UofSC-ASME/USC-ASME-TigerBurn-2026/README.md

# USC-ASME-TigerBurn-2026
Concepts and CAD files for Tiger Burn 2026.
