UofSC-ASME/USC-ASME-TigerBurn-2026/UofSC-ASME-Tiger-Burn-Design-2025-main/UofSC-ASME-Tiger-Burn-Design-2025-main/README.md

# UofSC-ASME-Tiger-Burn-Design-2025
Concepts and CAD files for Tiger Burn 2025.

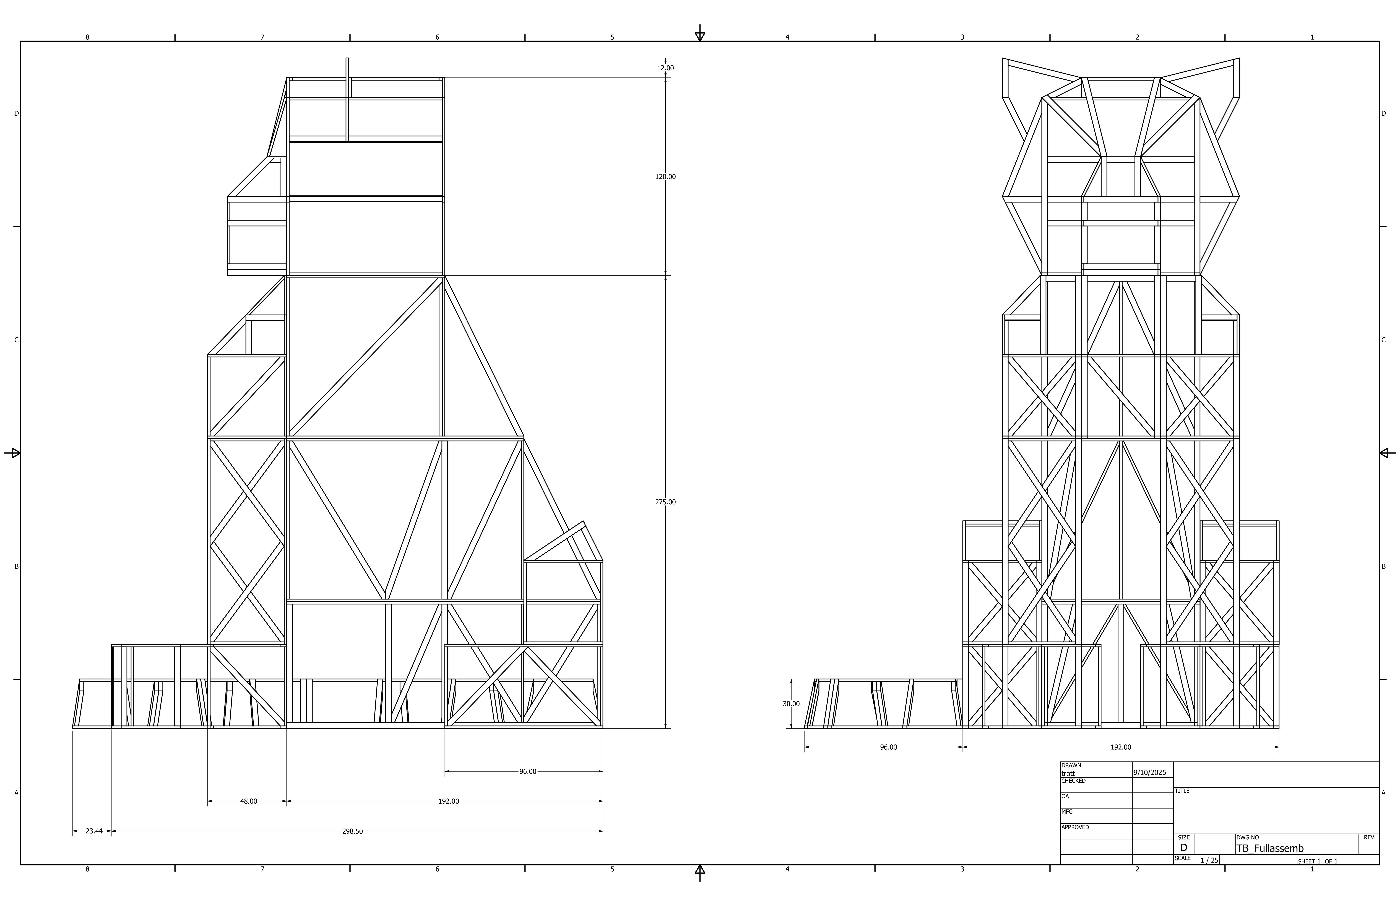
[picture p1: UofSC-ASME-Tiger-Burn-Design-2025-main/UofSC-ASME-Tiger-Burn-Design-2025-main/Documents/Drawings/TB_Fullassemb.png]

**Figure 1:** Drawing of the full assembly

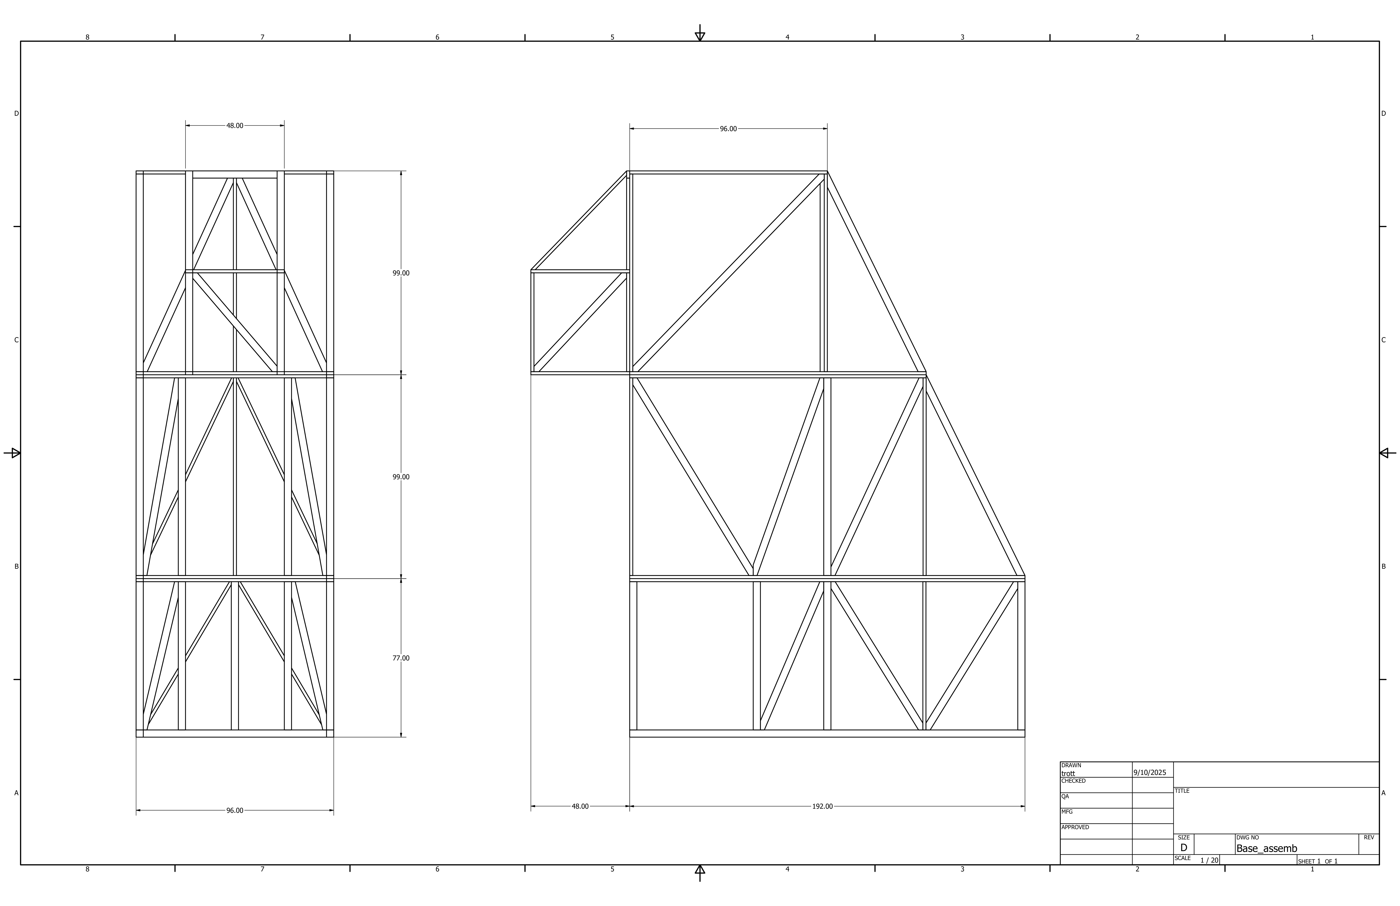
[picture p2: UofSC-ASME-Tiger-Burn-Design-2025-main/UofSC-ASME-Tiger-Burn-Design-2025-main/Documents/Drawings/Base_assemb.png]

**Figure 2:** Drawing of the base assembly.
