UofSC-ASME/USC-ASME-TigerBurn-2026/head files/Screenshot 2026-06-01 195907.png

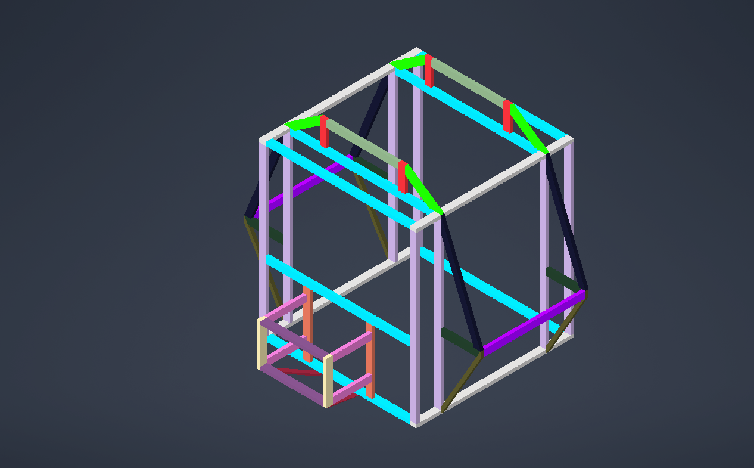
head files/Screenshot 2026-06-01 195907.png
