UofSC-ASME/USC-ASME-TigerBurn-2026/head files/Screenshot 2026-08-07 163357.png

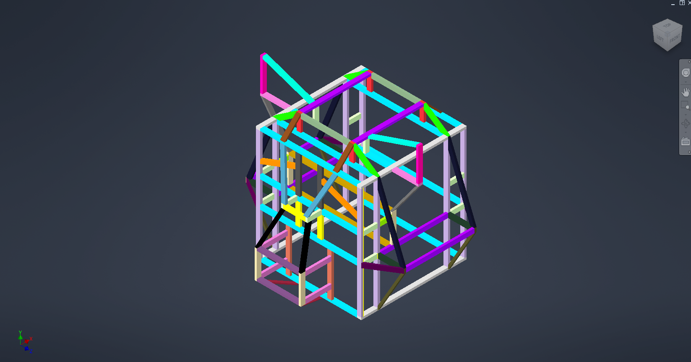
head files/Screenshot 2026-08-07 163357.png
