UofSC-ASME/USC-ASME-TigerBurn-2026/UofSC-ASME-Tiger-Burn-Design-2025-main/UofSC-ASME-Tiger-Burn-Design-2025-main/CAD/Reference (TB24)/FullAssembly/FullAssembly.stl

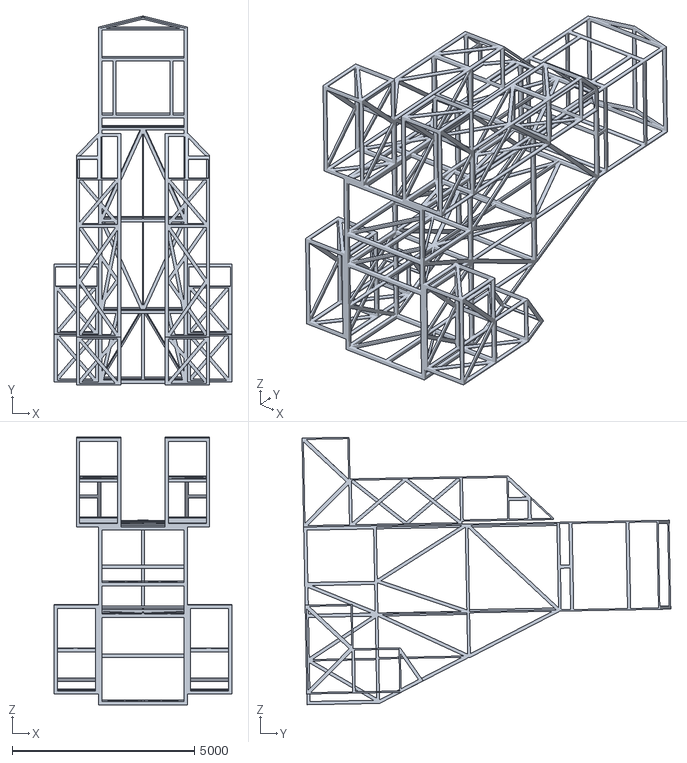
[picture p5: CAD file, 2026-04-23]
UofSC-ASME-Tiger-Burn-Design-2025-main/UofSC-ASME-Tiger-Burn-Design-2025-main/CAD/Reference (TB24)/FullAssembly/FullAssembly.stl
4876.8 x 10121.6 x 7337.9
