UofSC-ASME/USC-ASME-TigerBurn-2026/(list of files, cad)

Other CAD files:
UofSC-ASME-Tiger-Burn-Design-2025-main/UofSC-ASME-Tiger-Burn-Design-2025-main/CAD/Assembly/TB_Fullassemb.dwg
UofSC-ASME-Tiger-Burn-Design-2025-main/UofSC-ASME-Tiger-Burn-Design-2025-main/CAD/Assembly/Base_assemb.dwg
UofSC-ASME-Tiger-Burn-Design-2025-main/UofSC-ASME-Tiger-Burn-Design-2025-main/CAD/Assembly/OldVersions/TB_Fullassemb.0001.dwg
UofSC-ASME-Tiger-Burn-Design-2025-main/UofSC-ASME-Tiger-Burn-Design-2025-main/CAD/Assembly/OldVersions/Base_assemb.0001.dwg
Build Instructions/B_Foot_v2 - Copy (1).iam
Build Instructions/BoardCutsTigerBurnHead2026.iam
CAD/Assembly/OldVersions/TB_Fullassemb.0022.iam
CAD/Assembly/TB_Fullassemb-1.idw
CAD/Assembly/TB_Fullassemb.iam
CAD/Head/Tiger_HeadFrame/Frame/OldVersions/Frame 1756844320201.0004.iam
CAD/Head/Tiger_HeadFrame/Frame/OldVersions/Skeleton 1756844320202.0001.ipt
CAD/Legs/Back Foot/2x4x120.ipt
CAD/Legs/Back Foot/2x4x30.ipt
CAD/Legs/Back Foot/2x4x60.ipt
CAD/Legs/Back Foot/B_Foot.iam
CAD/Legs/Back Foot/B_Foot_v2 - Copy.iam
CAD/Legs/Back Foot/OldVersions/2x4x30.0001.ipt
CAD/Legs/Back Foot/OldVersions/2x4x42.0005.ipt
CAD/Legs/Back Foot/OldVersions/2x4x60.0002.ipt
CAD/Legs/Back Foot/OldVersions/2x4xrr.0001.ipt
CAD/Legs/Back Foot/OldVersions/B_Foot_v2.0010.iam
CAD/Legs/Back Foot/OldVersions/S_2x4x44.12.0003.ipt
CAD/Legs/Back Foot/OldVersions/S_2x4x54.35.0002.ipt
CAD/Legs/Back Foot/S_2x4x54.35.ipt
CAD/Legs/Back Foot/S_2x4x63.13.ipt
CAD/Legs/Back Foot/S_2x4x65.081.ipt
CAD/Legs/Back Foot/S_2x4x65.8.ipt
CAD/Legs/Back Foot/S_2x4x68.525.ipt
CAD/Legs/Front Foot/2x4x12.ipt
CAD/Legs/Front Foot/2x4x20.5.ipt
CAD/Legs/Front Foot/2x4x22.5.ipt
CAD/Legs/Front Foot/2x4x30.ipt
CAD/Legs/Front Foot/2x4x42.ipt
CAD/Legs/Front Foot/2x4x8.ipt
CAD/Legs/Front Foot/2x4x96.ipt
CAD/Legs/Front Foot/F_Foot.iam
CAD/Legs/Front Foot/F_Foot_v2.iam
CAD/Legs/Front Foot/Ffoot2.iam
CAD/Legs/Front Foot/OldVersions/2x4x12.0008.ipt
CAD/Legs/Front Foot/OldVersions/2x4x20.5.0002.ipt
CAD/Legs/Front Foot/OldVersions/2x4x22.5.0001.ipt
CAD/Legs/Front Foot/OldVersions/2x4x8.0005.ipt
CAD/Legs/Front Foot/OldVersions/F_Foot.0013.iam
CAD/Legs/Front Foot/OldVersions/F_Foot.0015.iam
CAD/Legs/Front Foot/OldVersions/F_Foot_v2.0007.iam
CAD/Legs/Front Foot/OldVersions/S_2x4x11.24.0002.ipt
CAD/Legs/Front Foot/OldVersions/S_2x4x13.48.0002.ipt
CAD/Legs/Front Foot/OldVersions/S_2x4x14.71 - Copy.0001.ipt
CAD/Legs/Front Foot/OldVersions/S_2x4x30.5.0001.ipt
CAD/Legs/Front Foot/S_2x4x11.24.ipt
CAD/Legs/Front Foot/S_2x4x13.48.ipt
CAD/Legs/Front Foot/S_2x4x14.71.ipt
CAD/Legs/Front Foot/S_2x4x30.5.ipt
CAD/Legs/Front Foot/S_2x4x54.35.ipt
CAD/Legs/Shoulder/Shoulder_L/Lshoulder cuts.ipt
CAD/Legs/Shoulder/Shoulder_L/OldVersions/Lshoulder cuts.0001.ipt
CAD/Tail/2x4x24.ipt
CAD/Tail/2x4x28.ipt
CAD/Tail/2x4x36.ipt
CAD/Tail/2x4x72.ipt
CAD/Tail/2x4x96.ipt
CAD/Tail/OldVersions/2x4x28.0005.ipt
CAD/Tail/OldVersions/2x4x96.0007.ipt
CAD/Tail/OldVersions/S_2x4x14.42.0001.ipt
CAD/Tail/OldVersions/S_2x4x24.74.0002.ipt
CAD/Tail/OldVersions/S_2x4x27.876.0001.ipt
CAD/Tail/OldVersions/S_2x4x28.635.0001.ipt
CAD/Tail/OldVersions/S_2x4x29.399.0002.ipt
CAD/Tail/OldVersions/S_2x4x31.008.0001.ipt
CAD/Tail/OldVersions/S_2x4x39.27.0003.ipt
CAD/Tail/OldVersions/S_2x4x39.865.0001.ipt
CAD/Tail/OldVersions/S_2x4x42.997.0001.ipt
CAD/Tail/OldVersions/S_2x4x45.283.0001.ipt
CAD/Tail/OldVersions/S_2x4x48.76.0005.ipt
CAD/Tail/OldVersions/S_2x4x50.56.0003.ipt
CAD/Tail/OldVersions/S_2x4x52.551.0002.ipt
CAD/Tail/OldVersions/S_2x4x53.341.0001.ipt
CAD/Tail/OldVersions/S_2x4x55.628.0001.ipt
CAD/Tail/OldVersions/S_2x4x57.206.0001.ipt
CAD/Tail/OldVersions/S_2x4x60.882.0002.ipt
CAD/Tail/OldVersions/S_2x4x64.382.0001.ipt
CAD/Tail/OldVersions/S_2x4x69.709.0001.ipt
CAD/Tail/OldVersions/S_2x4x73.75.0003.ipt
CAD/Tail/OldVersions/S_2x4x74.54.0003.ipt
CAD/Tail/OldVersions/S_2x4x82.0002.ipt
CAD/Tail/OldVersions/S_2x4x84.0002.ipt
CAD/Tail/OldVersions/S_2x4x93.85.0002.ipt
CAD/Tail/OldVersions/Sketch_tail.0003.ipt
CAD/Tail/OldVersions/Struct_tail.0002.iam
CAD/Tail/OldVersions/Tail.0007.iam
CAD/Tail/OldVersions/tail_p1.0005.iam
CAD/Tail/OldVersions/tail_p2.0001.iam
CAD/Tail/OldVersions/tail_p3.0003.iam
CAD/Tail/OldVersions/tail_p4.0004.iam
CAD/Tail/OldVersions/taildiag.0001.ipt
CAD/Tail/S_2x4x14.42.ipt
CAD/Tail/S_2x4x24.74.ipt
CAD/Tail/S_2x4x27.876.ipt
CAD/Tail/S_2x4x28.635.ipt
CAD/Tail/S_2x4x29.334.ipt
CAD/Tail/S_2x4x29.399.ipt
CAD/Tail/S_2x4x31.008.ipt
CAD/Tail/S_2x4x31.38.ipt
CAD/Tail/S_2x4x32.93.ipt
CAD/Tail/S_2x4x39.865.ipt
CAD/Tail/S_2x4x40.427.ipt
CAD/Tail/S_2x4x40.639.ipt
CAD/Tail/S_2x4x41.265.ipt
CAD/Tail/S_2x4x41.489.ipt
CAD/Tail/S_2x4x42.997.ipt
CAD/Tail/S_2x4x43.799.ipt
CAD/Tail/S_2x4x45.283.ipt
CAD/Tail/S_2x4x48.76.ipt
CAD/Tail/S_2x4x50.56.ipt
CAD/Tail/S_2x4x52.551.ipt
CAD/Tail/S_2x4x53.341.ipt
CAD/Tail/S_2x4x55.628.ipt
CAD/Tail/S_2x4x57.206.ipt
CAD/Tail/S_2x4x60.882.ipt
CAD/Tail/S_2x4x64.382.ipt
CAD/Tail/S_2x4x69.709.ipt
CAD/Tail/S_2x4x72.ipt
CAD/Tail/S_2x4x73.75.ipt
CAD/Tail/S_2x4x74.54.ipt
CAD/Tail/S_2x4x80.31.ipt
CAD/Tail/S_2x4x82.ipt
CAD/Tail/S_2x4x84.ipt
CAD/Tail/S_2x4x92.131.ipt
CAD/Tail/S_2x4x93.85.ipt
CAD/Tail/S_2x4x96.546.ipt
CAD/Tail/S_2x4x96.ipt
CAD/Tail/S_2x4x96b.ipt
CAD/Tail/Sketch_tail.ipt
CAD/Tail/Struct_tail.iam
CAD/Tail/Tail.iam
CAD/Tail/tail_p1.iam
CAD/Tail/tail_p2.iam
CAD/Tail/tail_p3.iam
CAD/Tail/tail_p4.iam
CAD/Tail/taildiag.ipt
UofSC-ASME-Tiger-Burn-Design-2025-main/UofSC-ASME-Tiger-Burn-Design-2025-main/CAD/Assembly/Base_assemb.iam
UofSC-ASME-Tiger-Burn-Design-2025-main/UofSC-ASME-Tiger-Burn-Design-2025-main/CAD/Assembly/Body_assemb.iam
UofSC-ASME-Tiger-Burn-Design-2025-main/UofSC-ASME-Tiger-Burn-Design-2025-main/CAD/Assembly/OldVersions/Base_assemb.0001.iam
UofSC-ASME-Tiger-Burn-Design-2025-main/UofSC-ASME-Tiger-Burn-Design-2025-main/CAD/Assembly/OldVersions/Body_assemb.0001.iam
UofSC-ASME-Tiger-Burn-Design-2025-main/UofSC-ASME-Tiger-Burn-Design-2025-main/CAD/Assembly/OldVersions/TB_Fullassemb.0014.iam
UofSC-ASME-Tiger-Burn-Design-2025-main/UofSC-ASME-Tiger-Burn-Design-2025-main/CAD/Assembly/TB_Fullassemb.iam
UofSC-ASME-Tiger-Burn-Design-2025-main/UofSC-ASME-Tiger-Burn-Design-2025-main/CAD/Body/Base 01/2x4x192.ipt
UofSC-ASME-Tiger-Burn-Design-2025-main/UofSC-ASME-Tiger-Burn-Design-2025-main/CAD/Body/Base 01/2x4x72.ipt
UofSC-ASME-Tiger-Burn-Design-2025-main/UofSC-ASME-Tiger-Burn-Design-2025-main/CAD/Body/Base 01/2x4x89.ipt
UofSC-ASME-Tiger-Burn-Design-2025-main/UofSC-ASME-Tiger-Burn-Design-2025-main/CAD/Body/Base 01/4x4x192.ipt
UofSC-ASME-Tiger-Burn-Design-2025-main/UofSC-ASME-Tiger-Burn-Design-2025-main/CAD/Body/Base 01/4x4x72.ipt
UofSC-ASME-Tiger-Burn-Design-2025-main/UofSC-ASME-Tiger-Burn-Design-2025-main/CAD/Body/Base 01/4x4x89.ipt
UofSC-ASME-Tiger-Burn-Design-2025-main/UofSC-ASME-Tiger-Burn-Design-2025-main/CAD/Body/Base 01/Base 01.iam
UofSC-ASME-Tiger-Burn-Design-2025-main/UofSC-ASME-Tiger-Burn-Design-2025-main/CAD/Body/Base 01/OldVersions/2x4x192.0001.ipt
UofSC-ASME-Tiger-Burn-Design-2025-main/UofSC-ASME-Tiger-Burn-Design-2025-main/CAD/Body/Base 01/OldVersions/2x4x72.0001.ipt
UofSC-ASME-Tiger-Burn-Design-2025-main/UofSC-ASME-Tiger-Burn-Design-2025-main/CAD/Body/Base 01/OldVersions/2x4x89.0001.ipt
UofSC-ASME-Tiger-Burn-Design-2025-main/UofSC-ASME-Tiger-Burn-Design-2025-main/CAD/Body/Base 01/OldVersions/4x4x192.0001.ipt
UofSC-ASME-Tiger-Burn-Design-2025-main/UofSC-ASME-Tiger-Burn-Design-2025-main/CAD/Body/Base 01/OldVersions/4x4x72.0001.ipt
UofSC-ASME-Tiger-Burn-Design-2025-main/UofSC-ASME-Tiger-Burn-Design-2025-main/CAD/Body/Base 01/OldVersions/4x4x89.0001.ipt
UofSC-ASME-Tiger-Burn-Design-2025-main/UofSC-ASME-Tiger-Burn-Design-2025-main/CAD/Body/Base 01/OldVersions/Base 01.0027.iam
UofSC-ASME-Tiger-Burn-Design-2025-main/UofSC-ASME-Tiger-Burn-Design-2025-main/CAD/Body/Base 01/OldVersions/S_2x4x73.980.0003.ipt
UofSC-ASME-Tiger-Burn-Design-2025-main/UofSC-ASME-Tiger-Burn-Design-2025-main/CAD/Body/Base 01/OldVersions/S_2x4x83.735.0004.ipt
UofSC-ASME-Tiger-Burn-Design-2025-main/UofSC-ASME-Tiger-Burn-Design-2025-main/CAD/Body/Base 01/OldVersions/fside1.0002.ipt
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
