UofSC-ASME/USC-ASME-TigerBurn-2026/Build Instructions Instructions.docx

Follow template of previous year’s designs!!

PUT ALL DIMENSIONS IN INCHES ONLY (people are stupid)

Don’t include unnecessary information

Piece quantity – pull from BOM

Piece cuts – pull from cut sheet

Screenshot each step of the process with dimensions

Include all pieces used and dimensions to build

Think about how to best construct the piece in order as you make the steps

I prefer to create a “cut sheet” page at the beginning. This shows people how to cut the boards all at once, and makes next steps a lot easier. Make sure to add a note on the instructions to LABEL YOUR CUTS with the dimension so they don’t get mixed up.
