UofSC-ASME/USC-ASME-TigerBurn-2026/Build Instructions/B Leg.x.pptx

## Back Leg x2

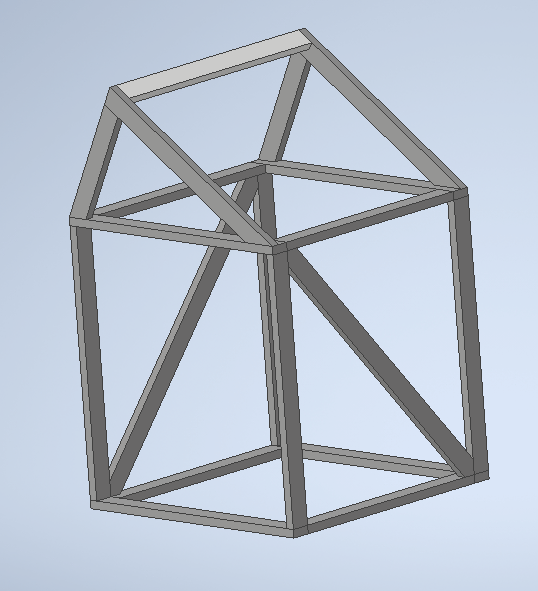
[picture p6: figure]

9.5 2x4x8

## Slide 2

(2) 2x4x8
- (2) 48”
- (2) 41”

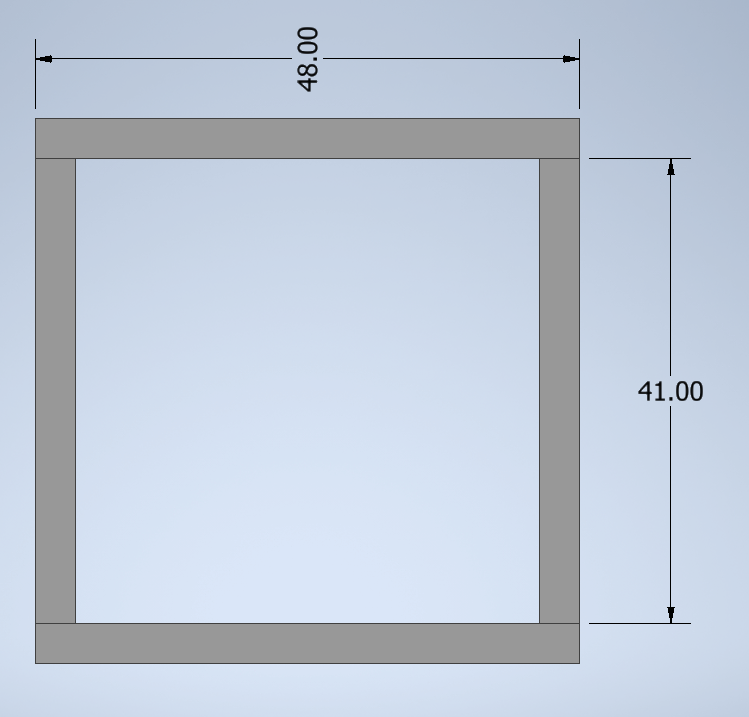
[picture p7: figure]

## Slide 3

(2) 2x4x8
- (4) 48”

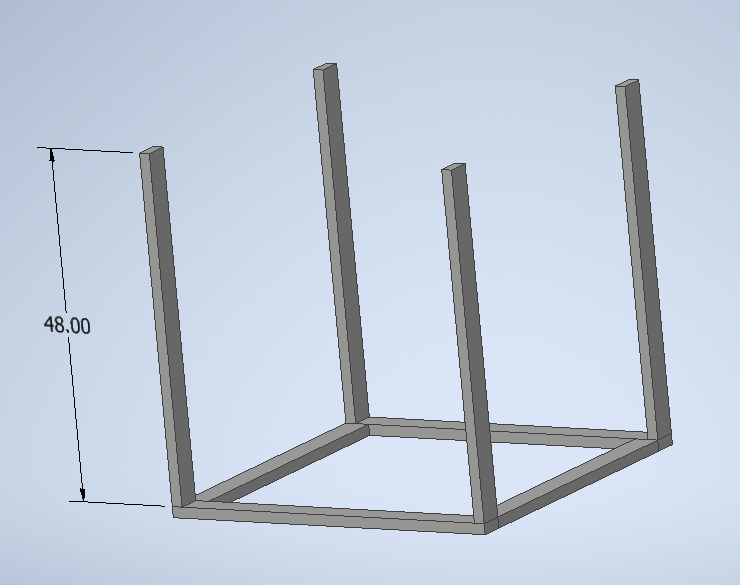
[picture p8: figure]

## Slide 4

(2) 2x4x8
- (2) 48”
- (2) 41”

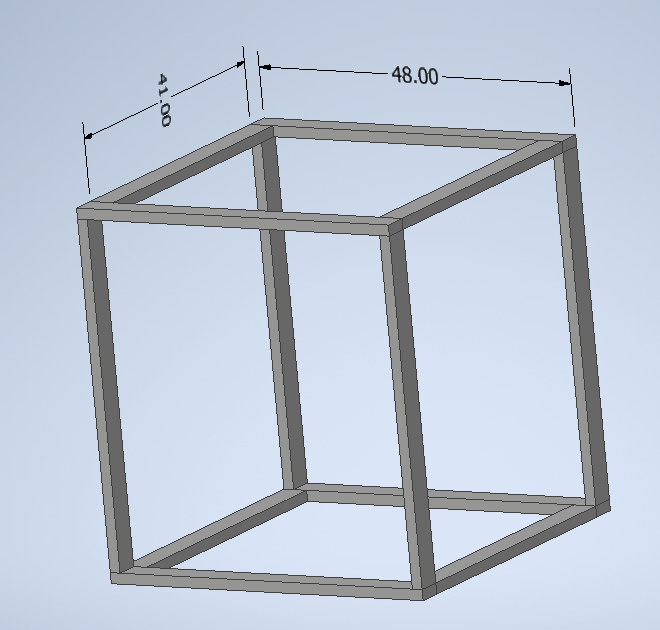
[picture p9: figure]

## Slide 5

(2) 2x4x8
- (2) slants
  - Save excess for top slants

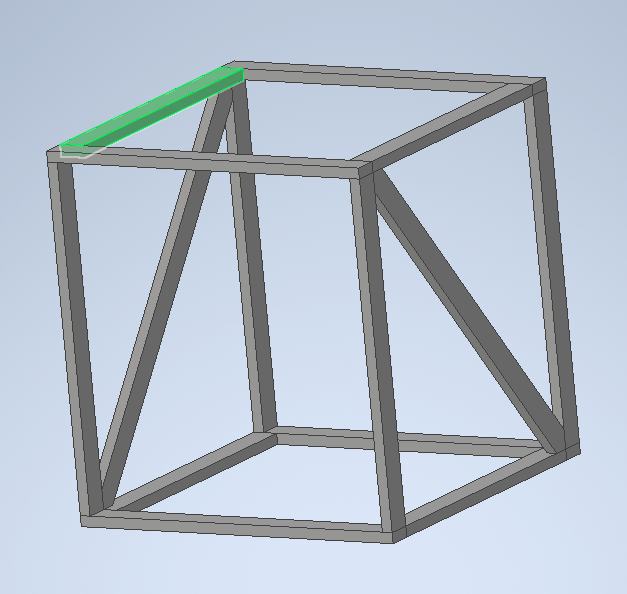
[picture p10: figure]

## Slide 6

(1) 2x4x8
- (2) long slants

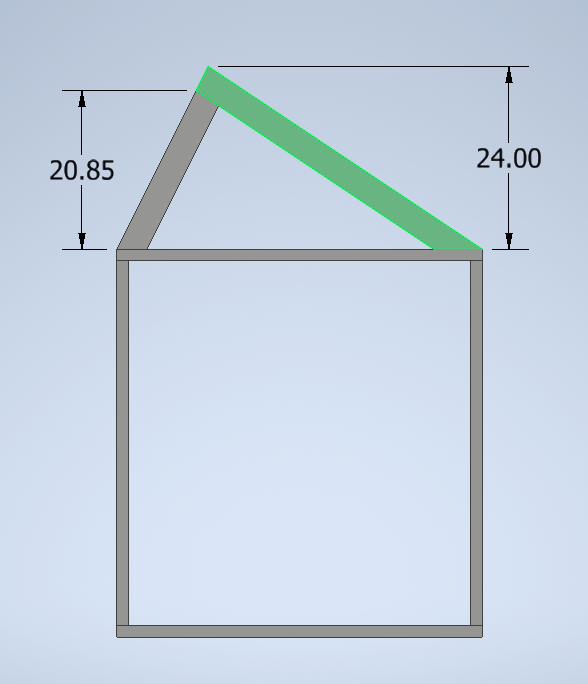
[picture p11: figure]

(2) Leftover from inside slants
- (2) short slants

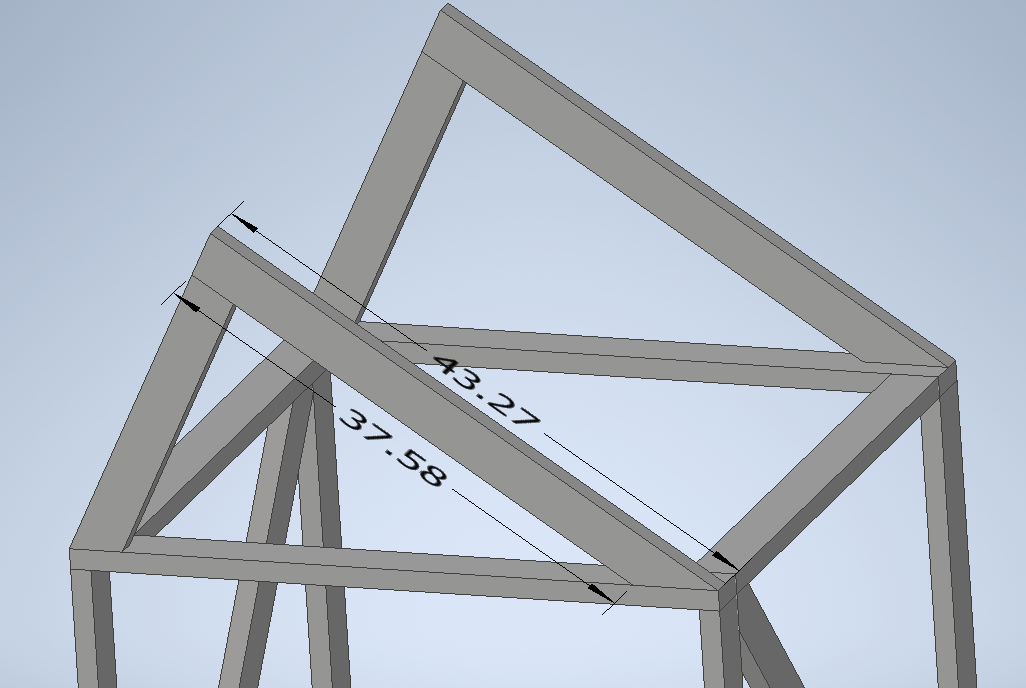
[picture p12: figure]
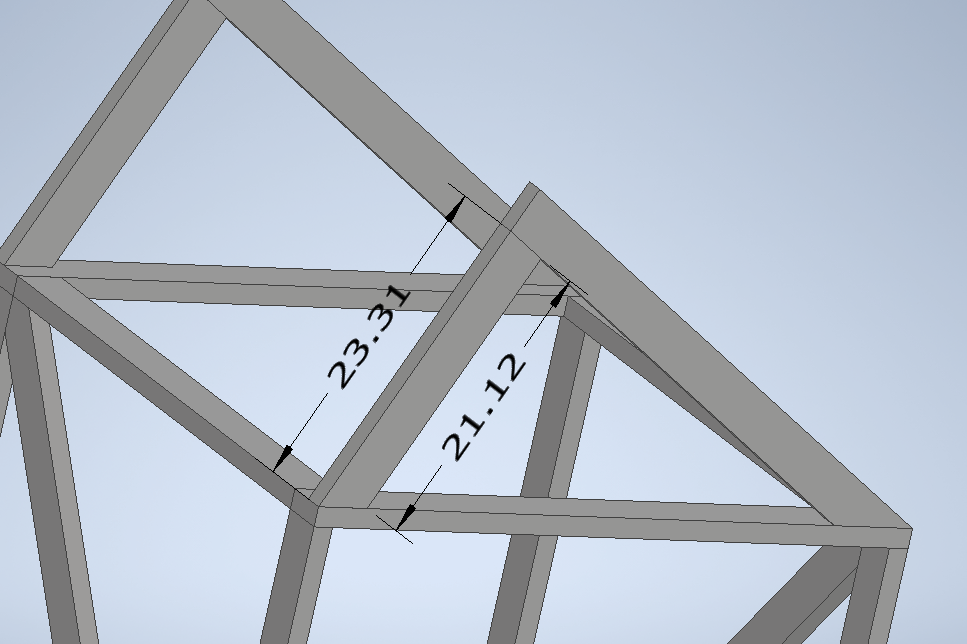
[picture p13: figure]

## Slide 7

(0.5) 2x4x8
- (1) 45”
  - Save other half for second back leg

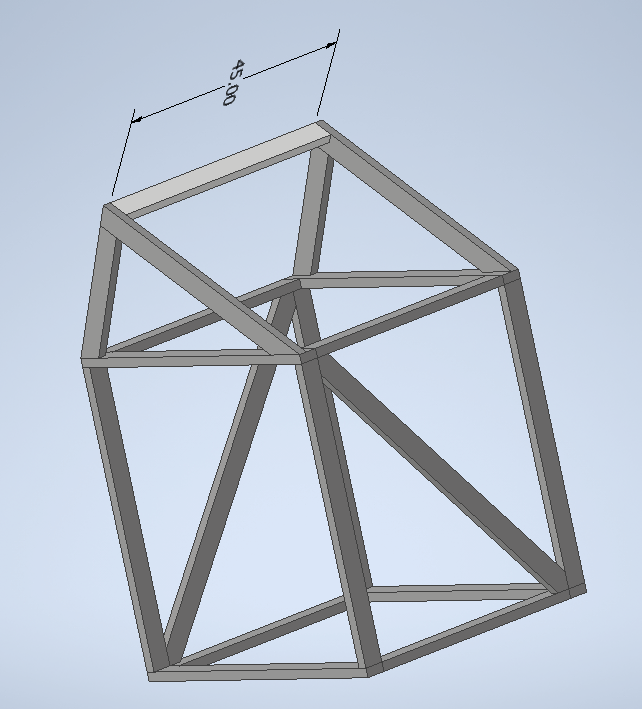
[picture p14: figure]
