UofSC-ASME/USC-ASME-TigerBurn-2026/Build Instructions/BF2026.x.pptx

## Back Foot Instructions (x2)

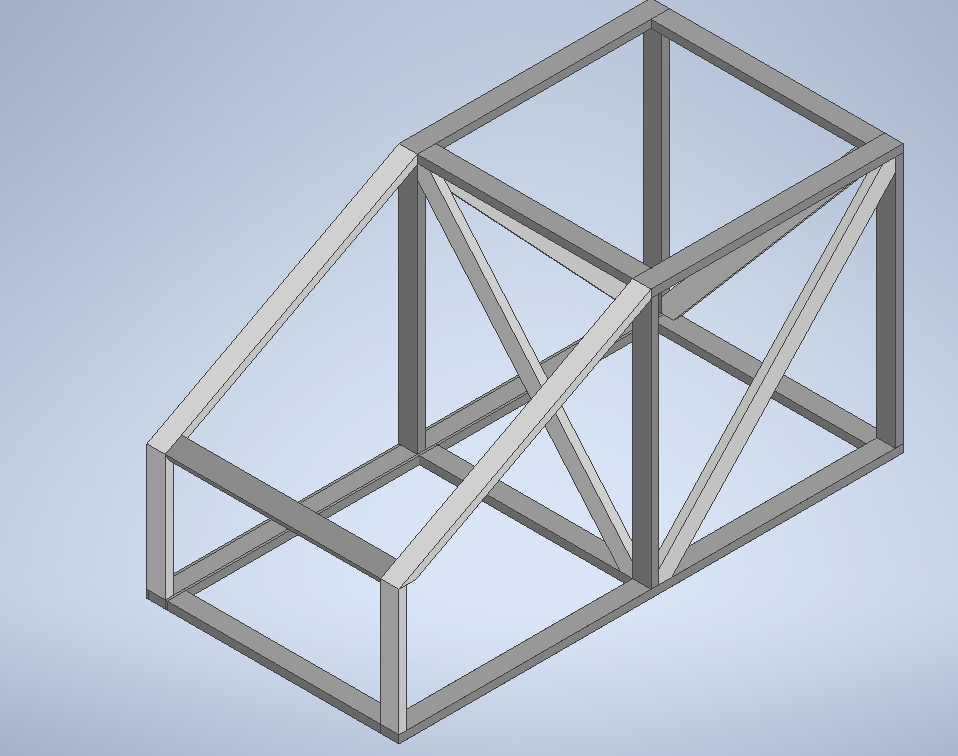
[picture p15: figure]
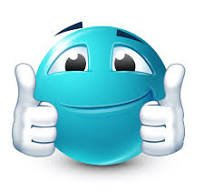
[picture p16: figure]

## Cut List

- (10) 2x4x8
  - (2 boards) → (1) 96” per board
  - (3 boards) → (2) 48” per board
  - (3 boards) → (2) 41” per board
  - (2 boards) → (1) 24” + (1) S66
- (1) 2x4x10
  - (1 board) → (2) S55
- (1) 2x4x12
  - (1 board) → (2) S66
Label all boards as you cut and keep track!

## Base

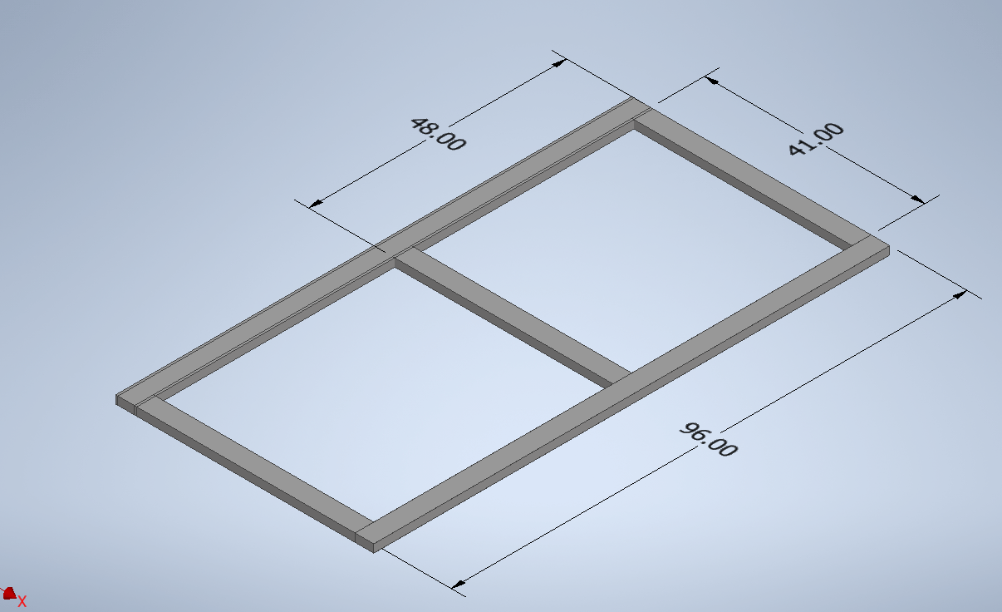
[picture p17: figure]

- (2) 96"
- (3) 41''

## Supports

- (4) 48”

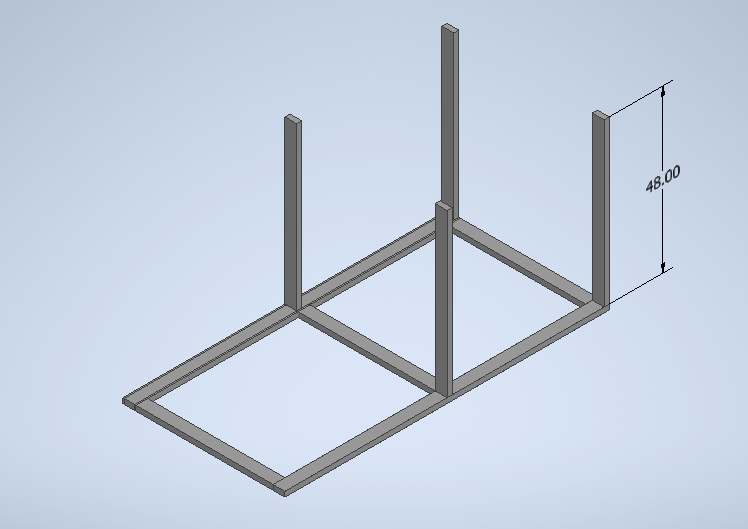
[picture p18: figure]

## Roof

- (2) 48”
- (2) 41”

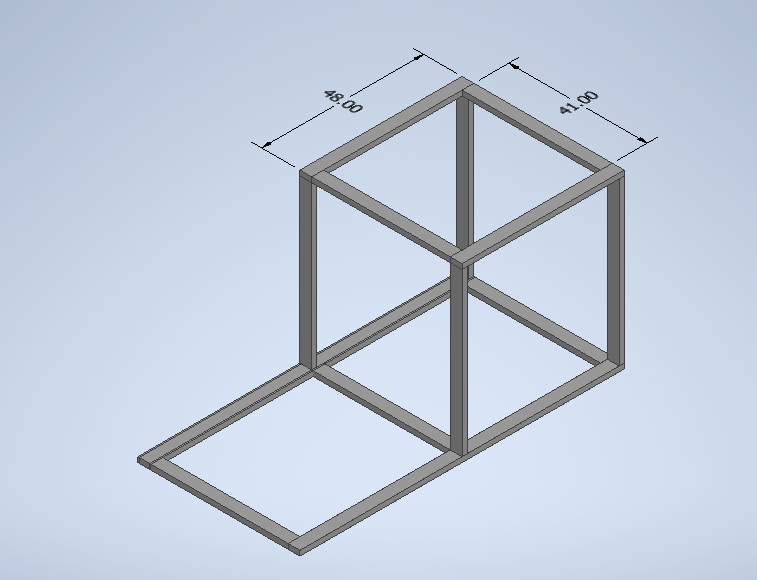
[picture p19: figure]

## Inner Diagonals

- (4) S66

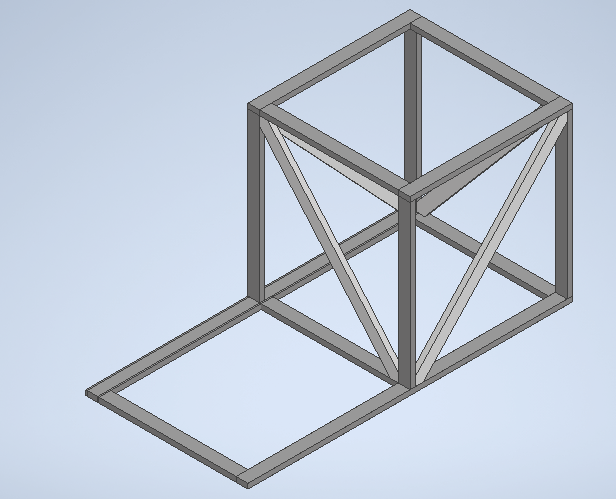
[picture p20: figure]

## Claw area

- (2) 24”
- (1) 41”

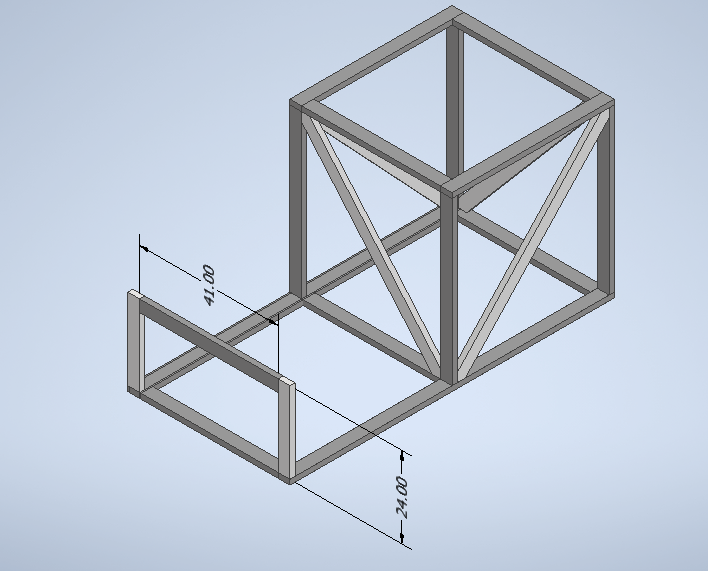
[picture p21: figure]

## Front Diagonal

- (2) S55

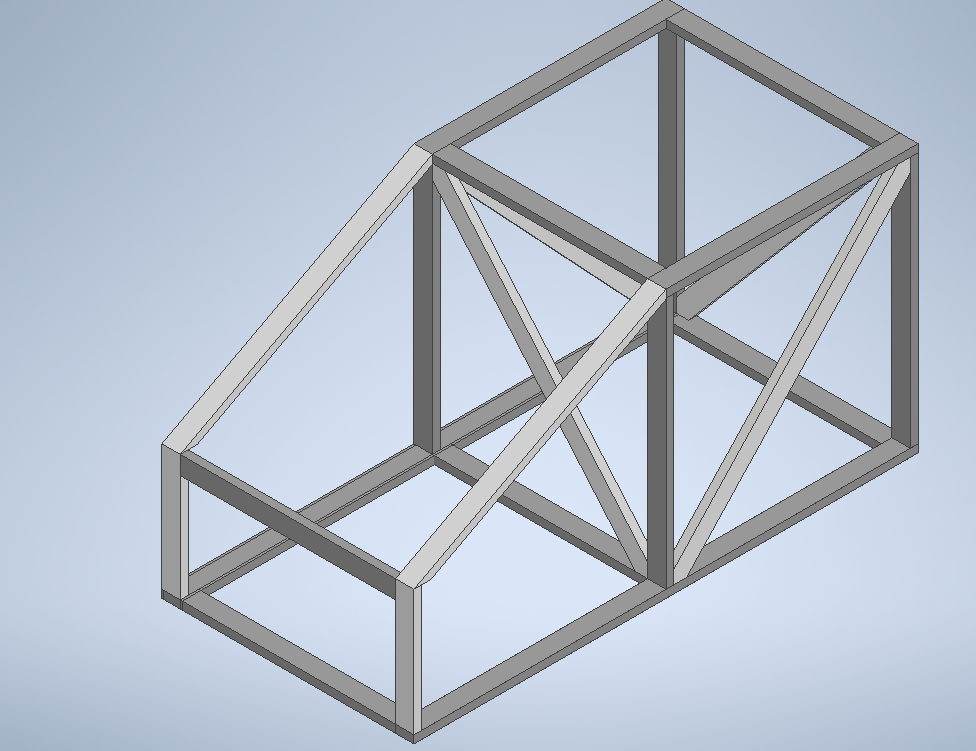
[picture p22: figure]

## CONGRATS!!

- Now the other Front Foot!
