UofSC-ASME/USC-ASME-TigerBurn-2026/Build Instructions/FF2026.x.pptx

## Front Foot Instructions (x2)

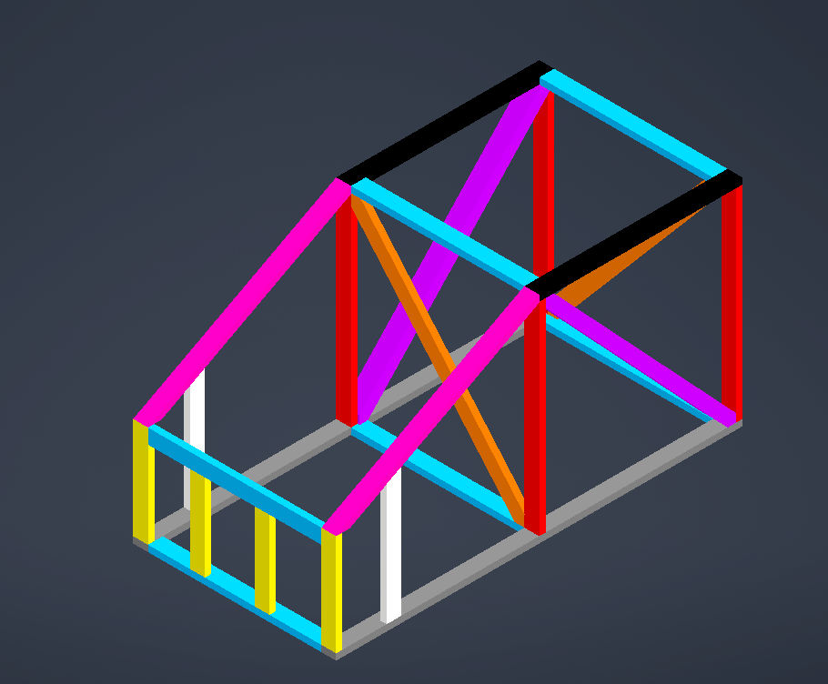
[picture p23: figure]
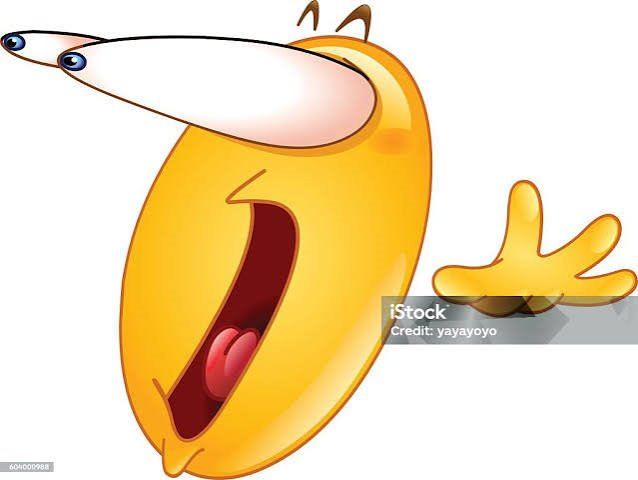
[picture p24: figure]

## Cut List

- (10) 2x4x8
  - (2 boards) → (1) 96” per board
  - (3 boards) → (2) 48” per board
  - (3 boards) → (2) 41” per board
  - (2 boards) → (1) 24” + (1) S66
- (3) 2x4x10
  - (1 board) → (2) S55
  - (2 boards) →(1) 20.5” + (1) S31 + (1) S66
Label all boards as you cut and keep track!

## Base


- (2) 96"
- (3) 41''

## Supports

- (4) 48”
- (2) 24”

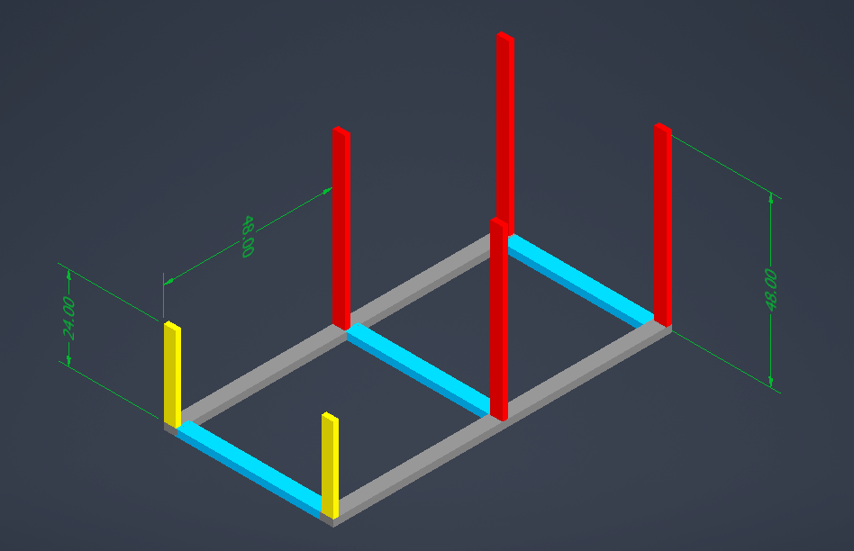
[picture p25: figure]

## Roof

- (2) 48”
- (2) 41”

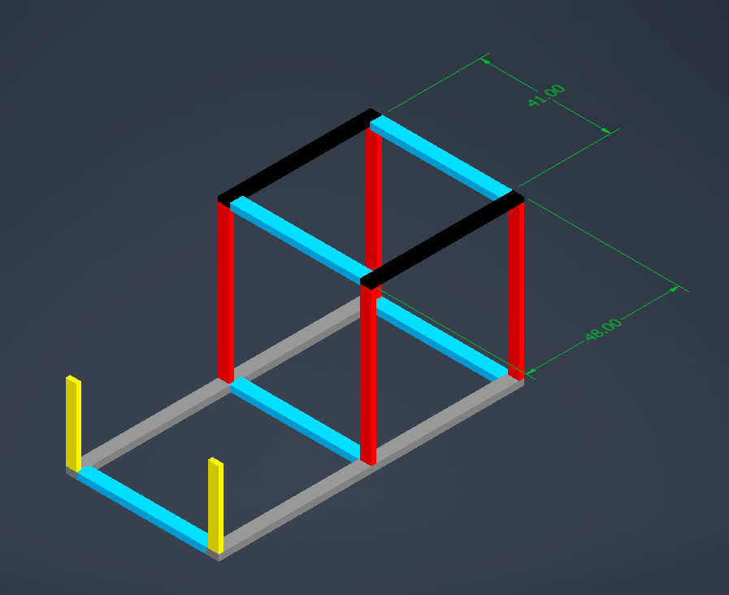
[picture p26: figure]

## Inner Diagonals

- (4) S66
- (pictures are a bit out of order but do these box diagonals before adding the toe)

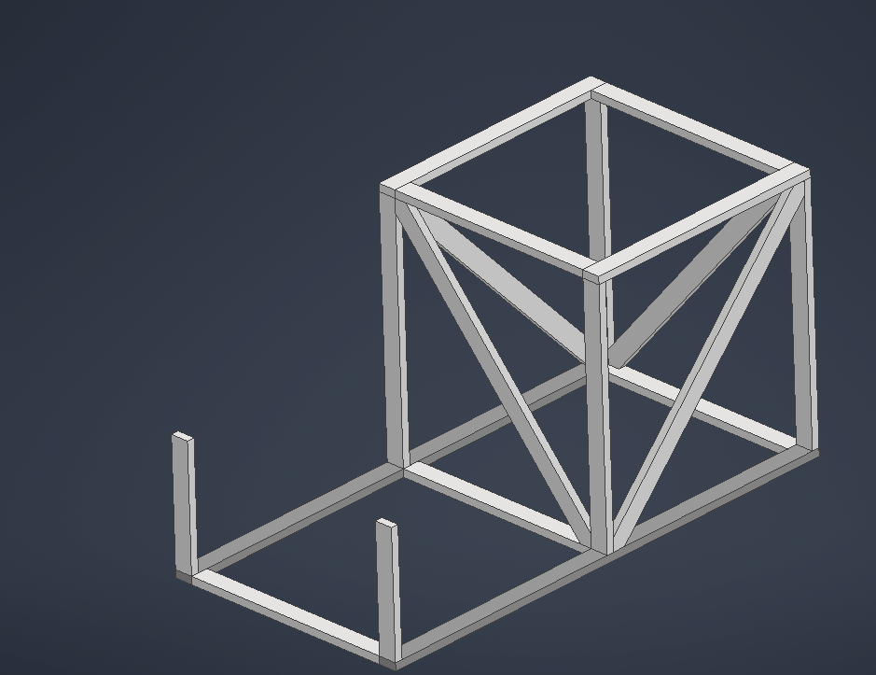
[picture p27: figure]

## Claw area

- (2) 20.5”
- (1) 41”

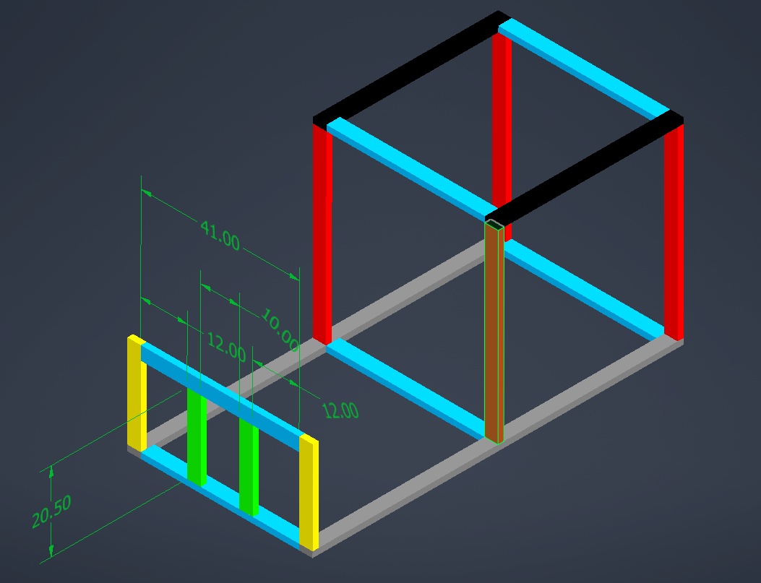
[picture p28: figure]

## Front Diagonal and Support

- (2) S55
- (2) S31

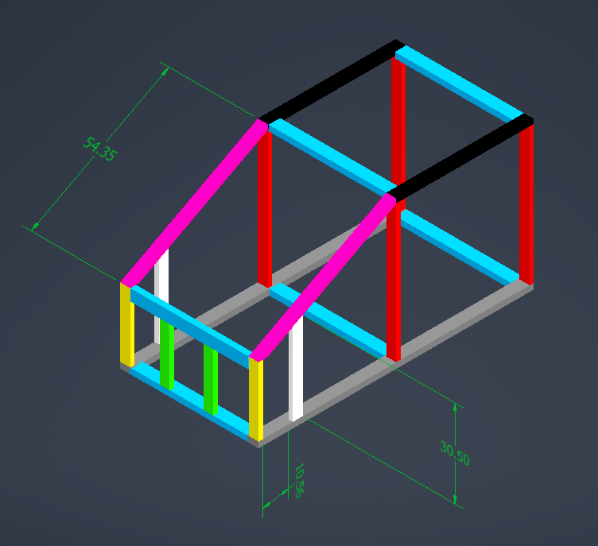
[picture p29: figure]

## CONGRATS!!

- Now the other Front Foot!

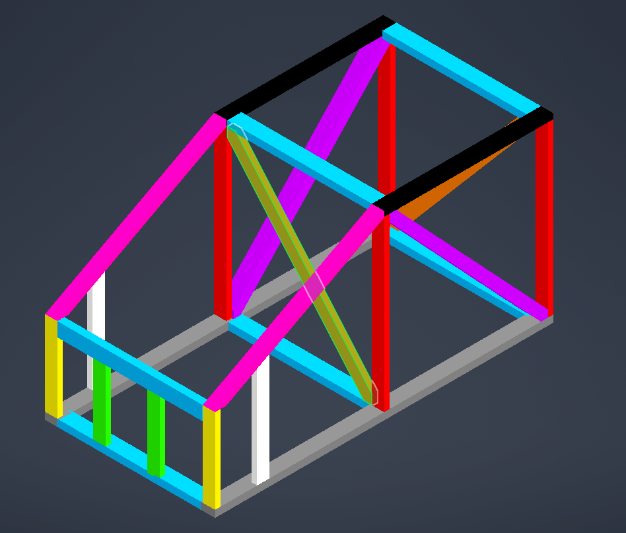
[picture p30: figure]
