UofSC-ASME/USC-ASME-TigerBurn-2026/Build Instructions/F Leg.x.pptx

## Front Leg x2

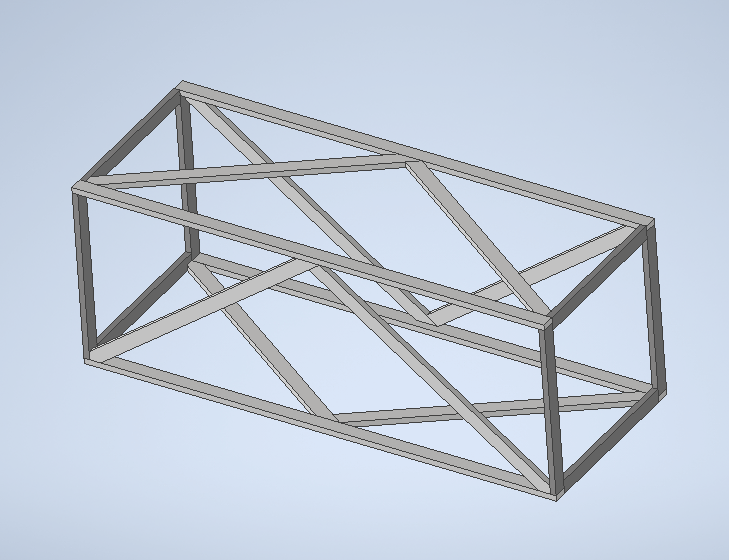
[picture p31: figure]

Very important to be using the right pieces and board sizes!!! Please keep track and label boards as you cut!!

3 2x4x8
6 2x4x10
4 2x4x12

## Slide 2

(2) 2x4x12
- (2) 125”
(2) 2x4x10
- (2) 41”
  - Cut a 41” from two separate 10’ boards NOT the same one. Save 79” leftover pieces

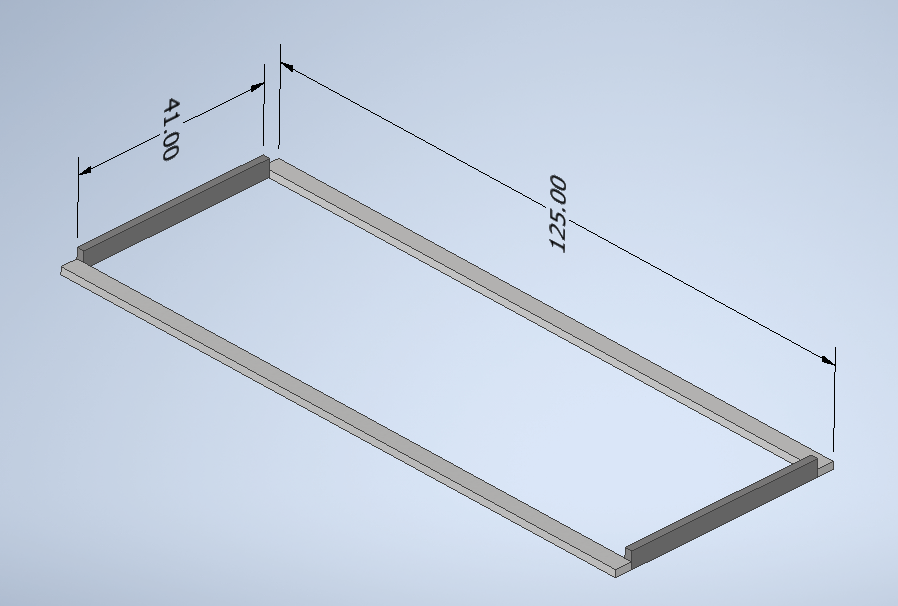
[picture p32: figure]

Very important to be using the right pieces and board sizes!!! Please keep track and label boards as you cut!!

## Slide 3

(1) 2x4x8
- (2) 45”
  - cut 2 45” from one 8’ board
(2) 2x4x10
- (2) 45”
  - Cut a 45” from two separate 10’ boards NOT the same one. Save 75” leftover pieces

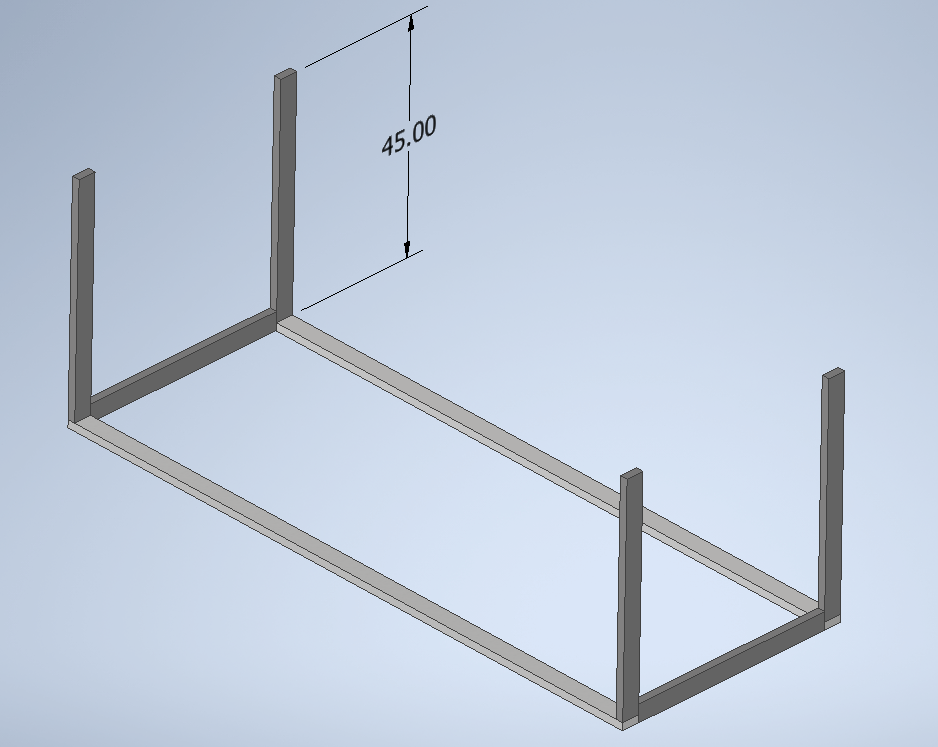
[picture p33: figure]

Very important to be using the right pieces and board sizes!!! Please keep track and label boards as you cut!!

## Slide 4

(2) 2x4x12
- (2) 125”
(2) 2x4x10
- (2) 41”
  - Cut a 41” from two separate 10’ boards NOT the same one. Save 79” leftover pieces

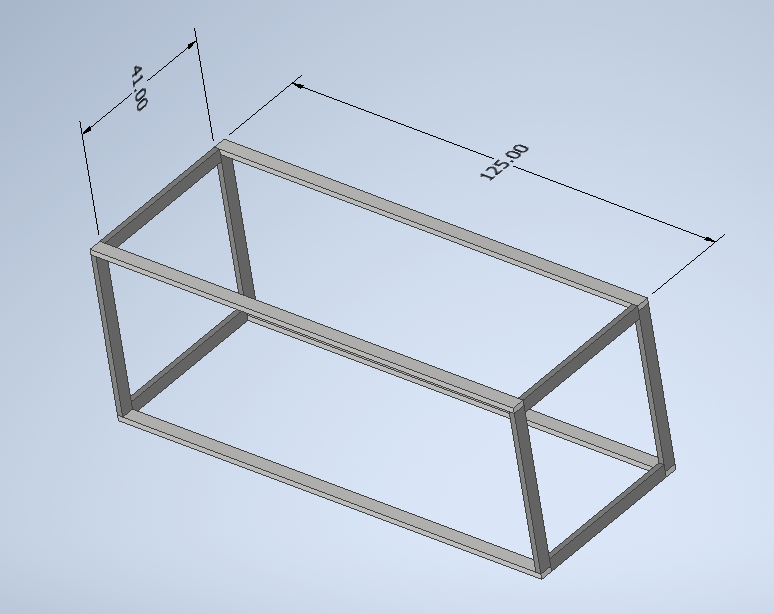
[picture p34: figure]
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

## Slide 5

(2) 2x4x8
- (2) long slants
(2) 75” leftovers
- (2) short slants

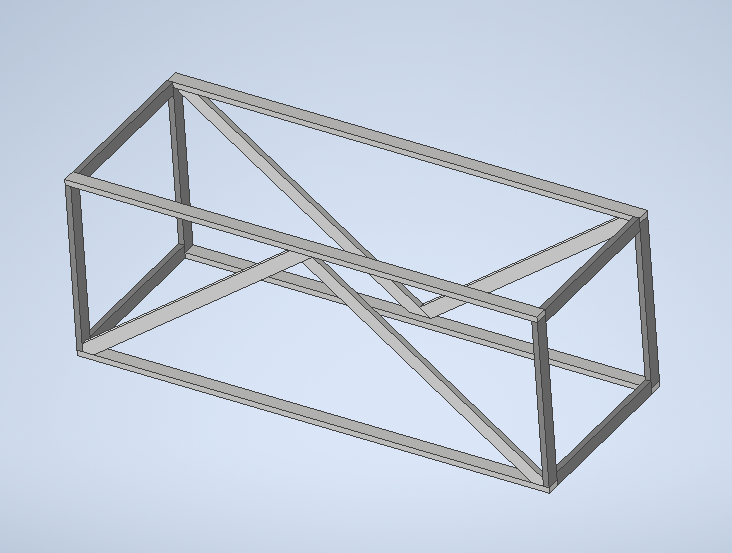
[picture p35: figure]
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

## Slide 6

(4) 79” leftovers
- (4) slants

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
