UofSC-ASME/USC-ASME-TigerBurn-2026/Build Instructions/B Foot..pptx

## Back Foot x2

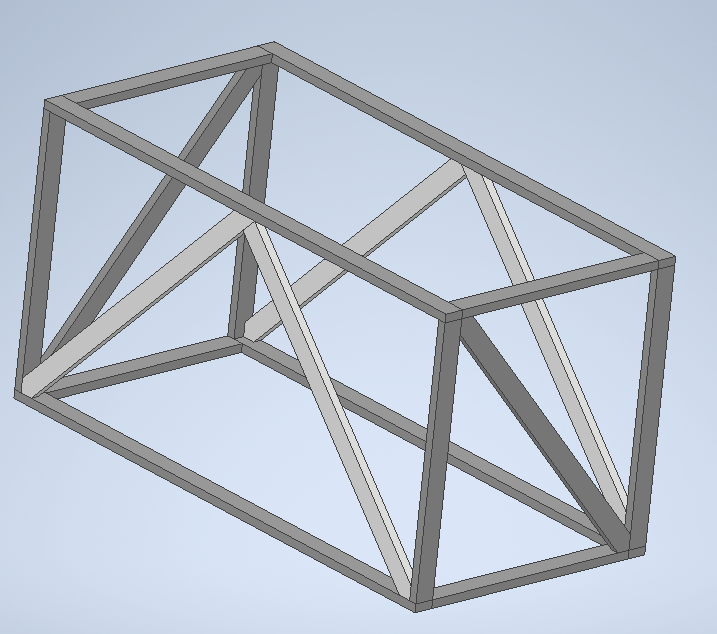
[picture p36: figure]

5 2x4x8
6 2x4x10

## Slide 2

(2) 2x4x8
- (2) 8’
(2) 2x4x10
- (2) 41”
  - Cut one from each board, save extra 79” boards

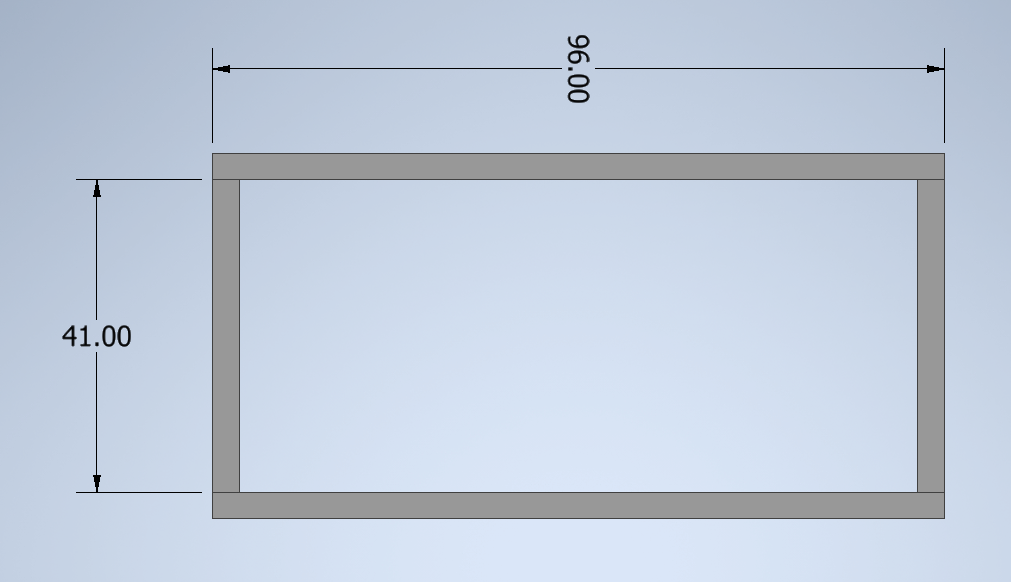
[picture p37: figure]

## Slide 3

(1) 2x4x8
- (2) 4’
(2) 2x4x10
- (2) 4’
  - One from each board, save extra 72” boards

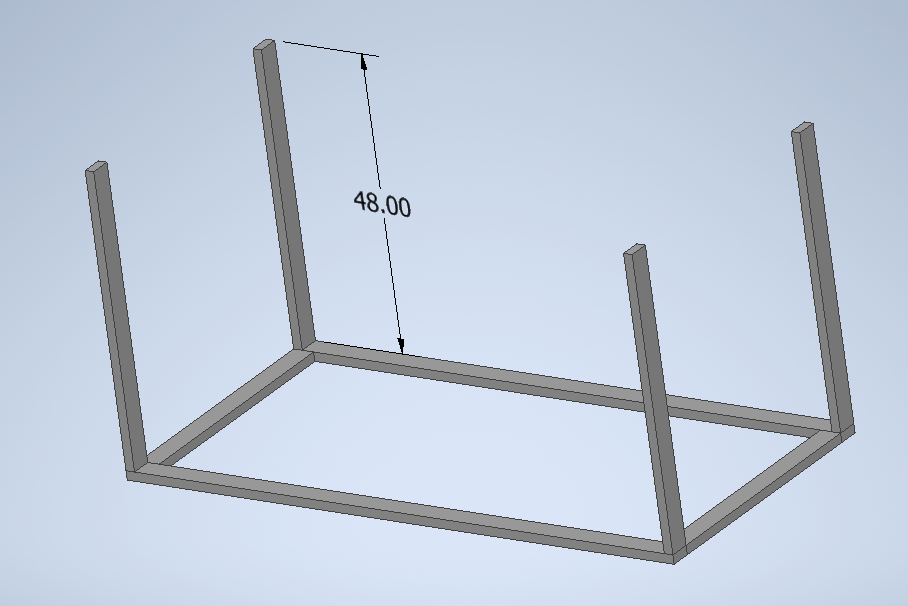
[picture p38: figure]

## Slide 4

(2) 2x4x8
- (2) 8’
(2) 2x4x10
- (2) 41”
  - Cut one from each board, save extra 79” boards

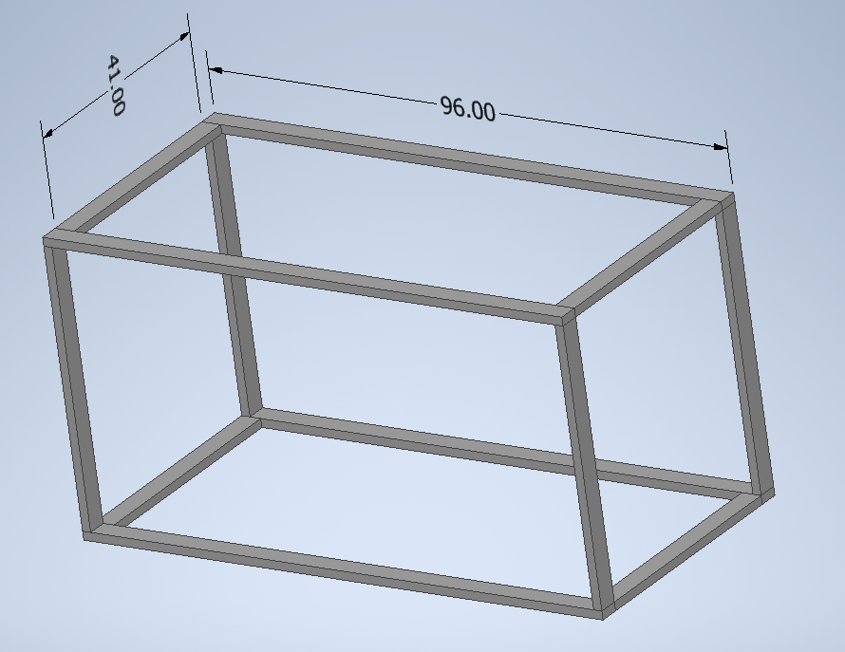
[picture p39: figure]

## Slide 5

(4) Saved extras
- (4) slants

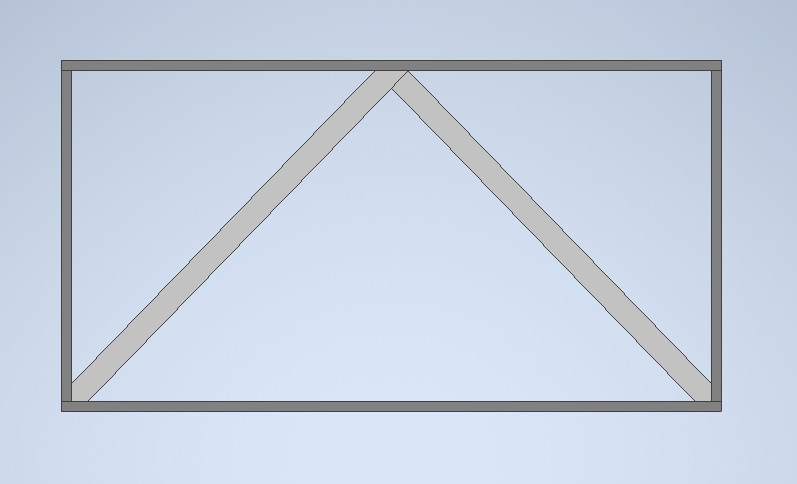
[picture p40: figure]

## Slide 6

(2) Saved extras
- slants
