UofSC-ASME/USC-ASME-TigerBurn-2026/Build Instructions/Head.o.pptx

## Head

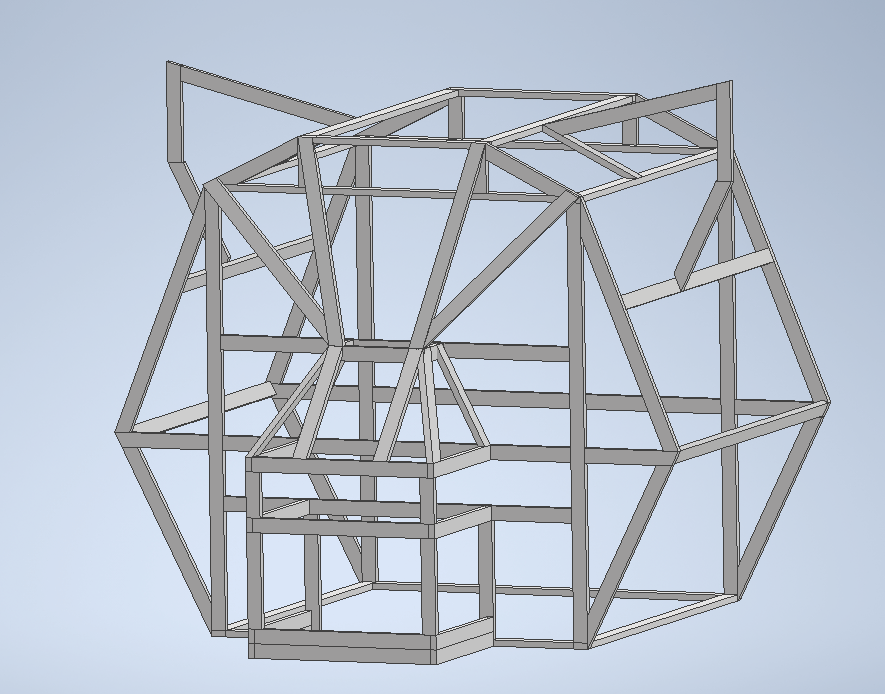
[picture p41: figure]

25 2x4x8
16 2x4x10
1 2x4x12

## Slide 2

(4) 2x4x8
- (2) 8’
- (2) 7’5”

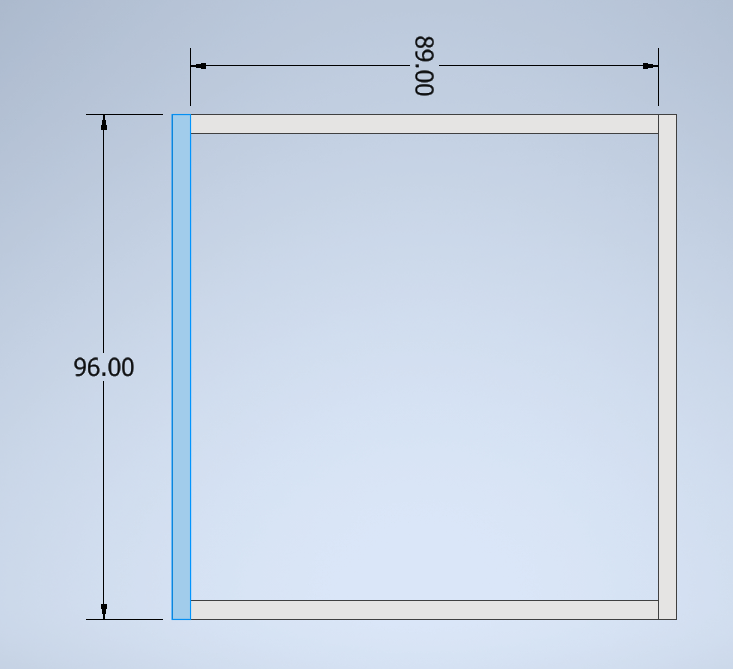
[picture p42: figure]

## Slide 3

(4) 2x4x10
- (4) 8’9”
  - save (4) 15” leftovers

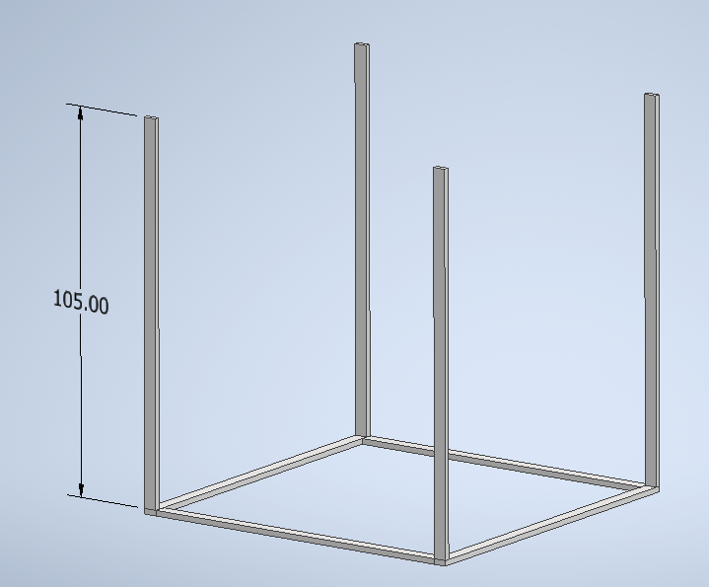
[picture p43: figure]

## Slide 4

(4) 2x4x8
- (2) 8’
- (2) 7’5”

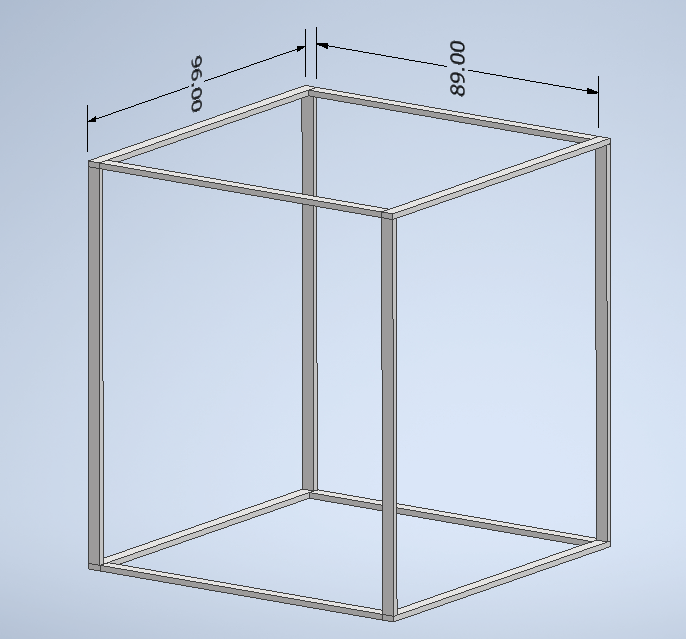
[picture p44: figure]

## Slide 5

(2) 2x4x10
- (2) 28.5”
  - Cut ONE from EACH board
  - WRITE (B) ON LEFTOVER BOARDS [91.5”] AND SAVE

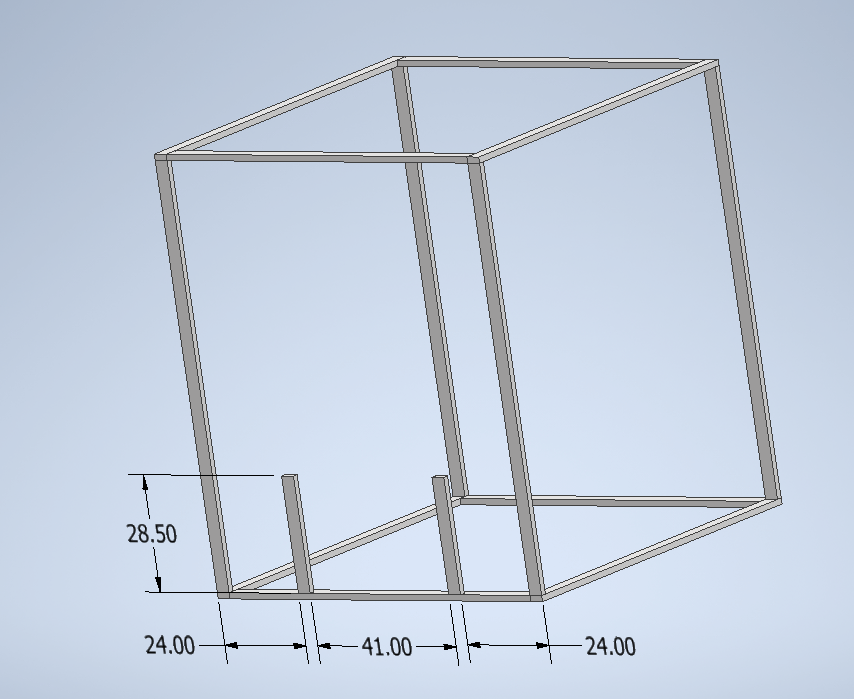
[picture p45: figure]

## Slide 6

(4) 2x4x8
- (4) 7’5”

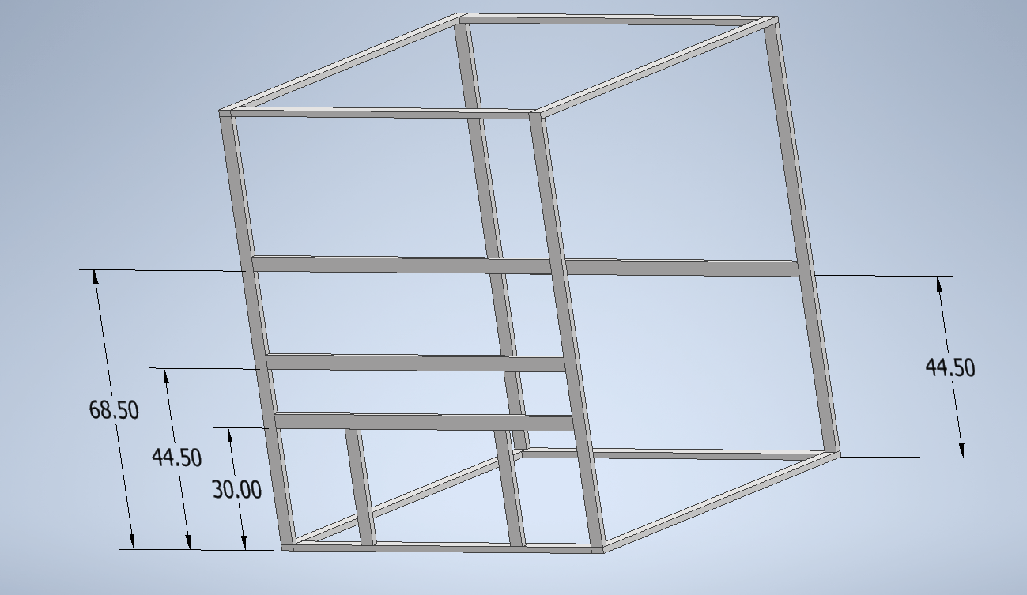
[picture p46: figure]

## Slide 7

(4) 15” leftovers
- (4) 10.5”

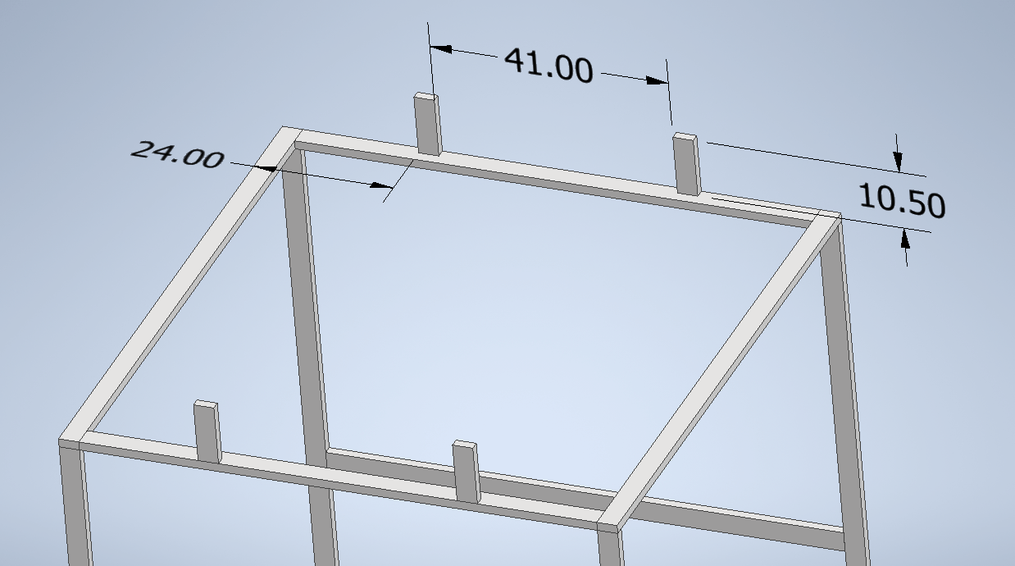
[picture p47: figure]

## Slide 8

(3) 2x4x8
- (2) 4’
- (2) 7’5”

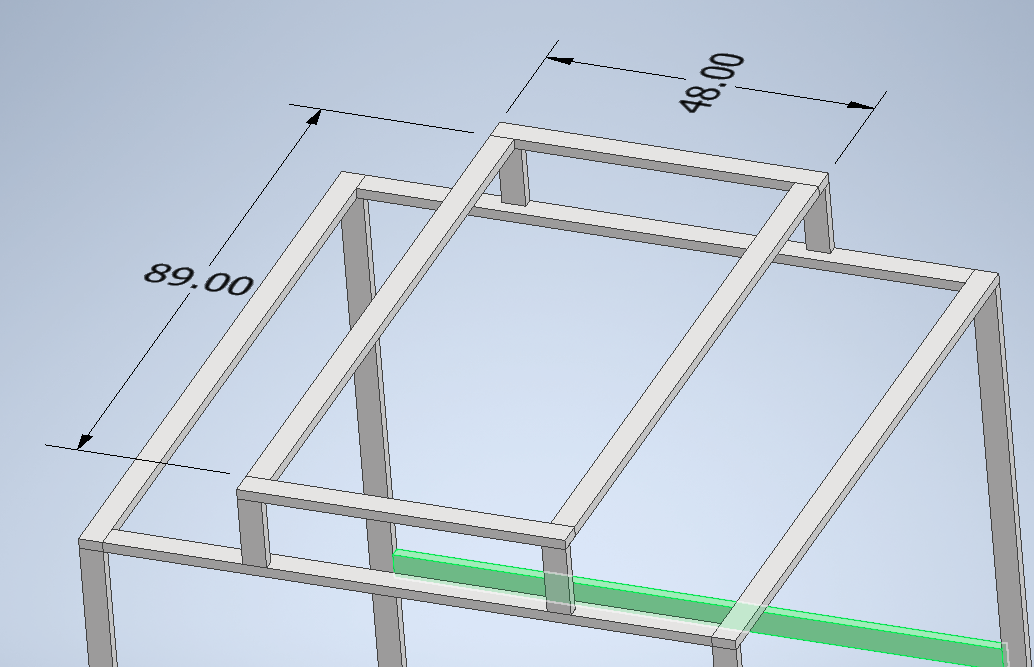
[picture p48: figure]

## Slide 9

(2) 2x4x8
- (6) slants
  - Three slants/board
  - WRITE (A) ON LEFTOVER BOARDS [15”] AND SAVE

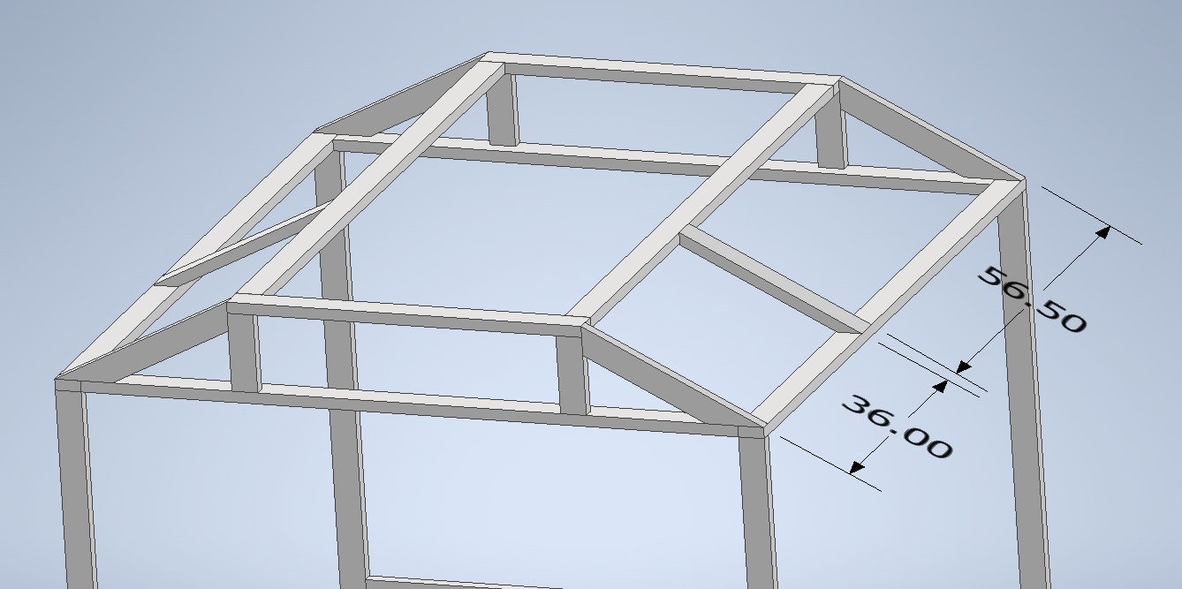
[picture p49: figure]

## Slide 10

(1) 2x4x8
- (4) ???

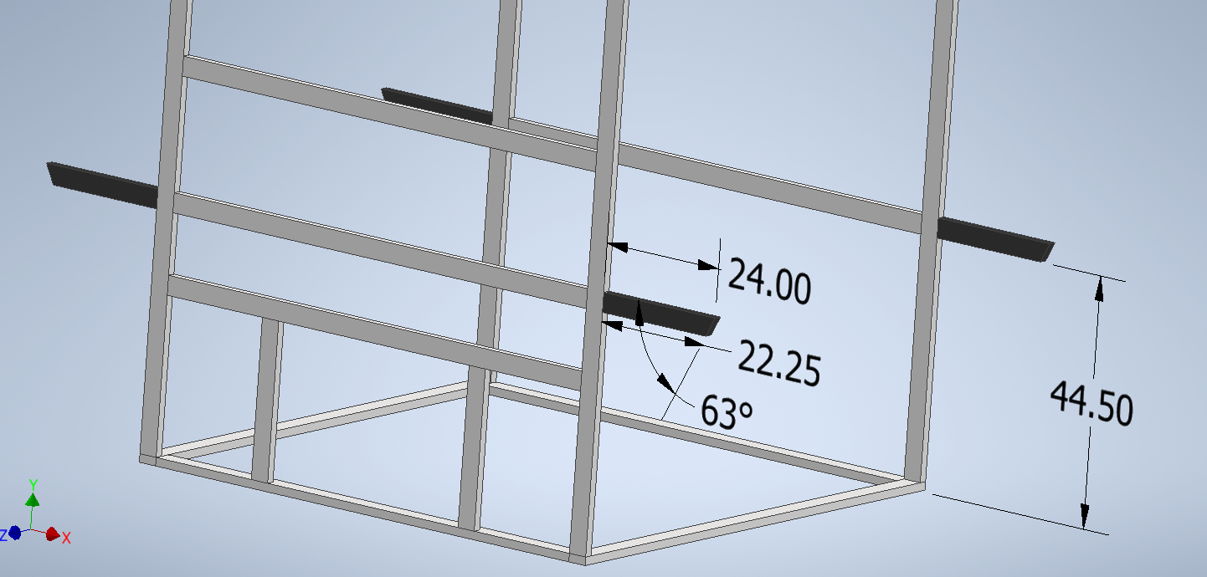
[picture p50: figure]

## Slide 11

(4) 2x4x10
- (8) slants
  - 1 long + 1 short per board

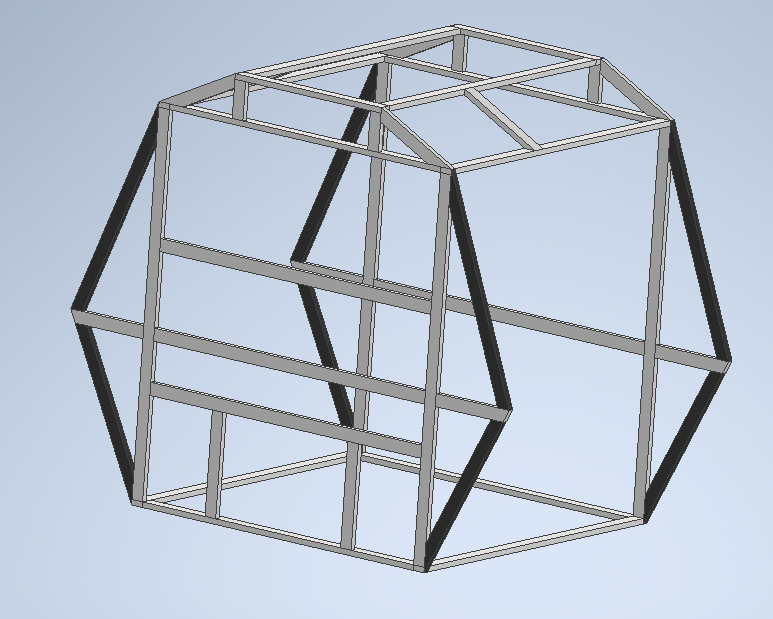
[picture p51: figure]

## Slide 12

(4) 2x4x8
- (4) 7’9”

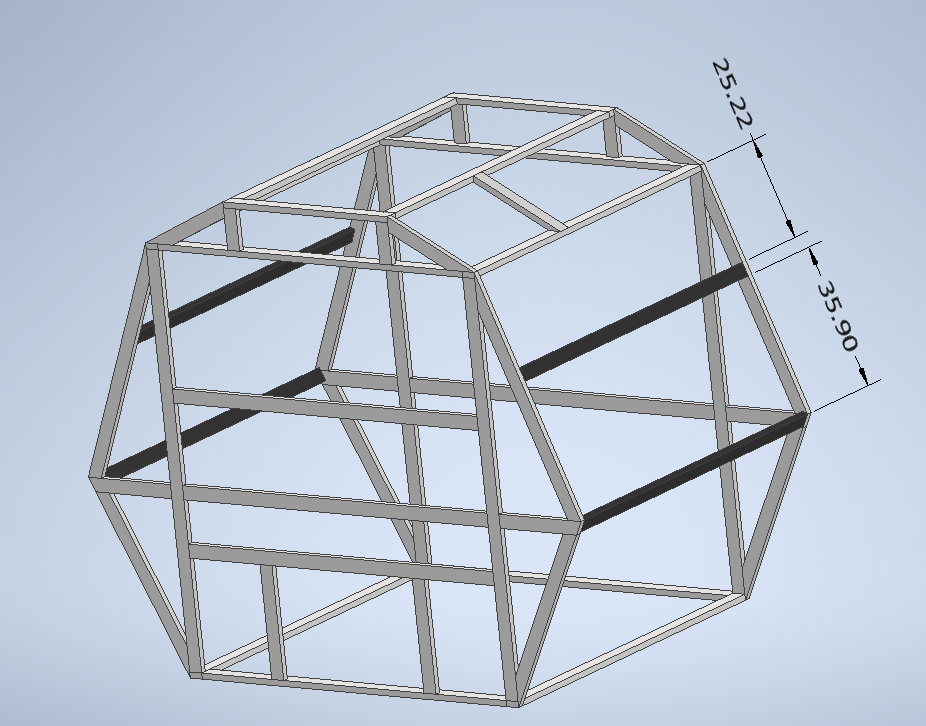
[picture p52: figure]

## Slide 13

(2) 2x4x10
- (4) 3’
- (2) 3’9”
  - (36+36+45)x2 boards

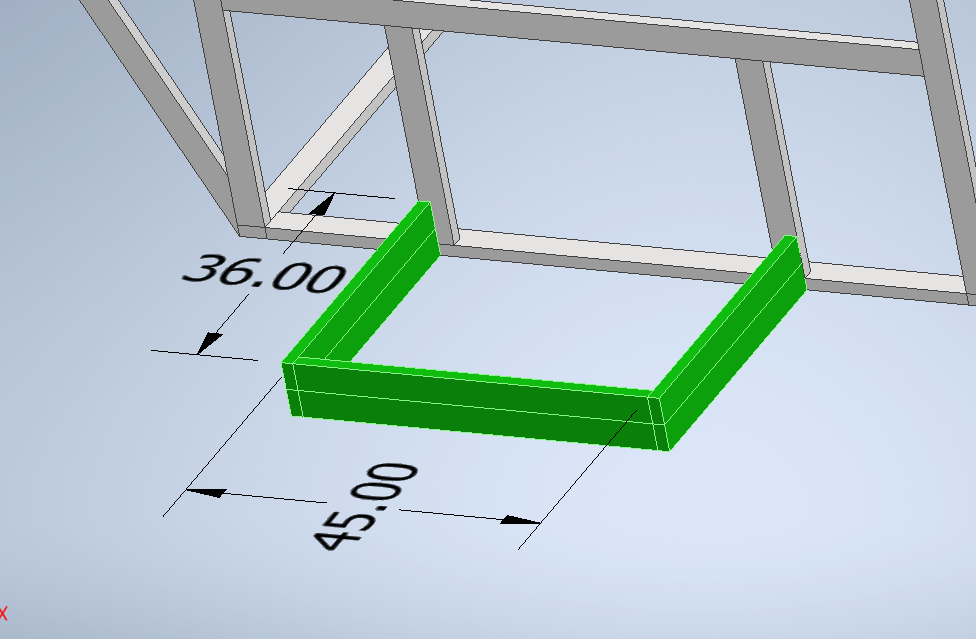
[picture p53: figure]

## Slide 14

(2) B boards
- (2) 23”
  - Cut ONE from EACH board

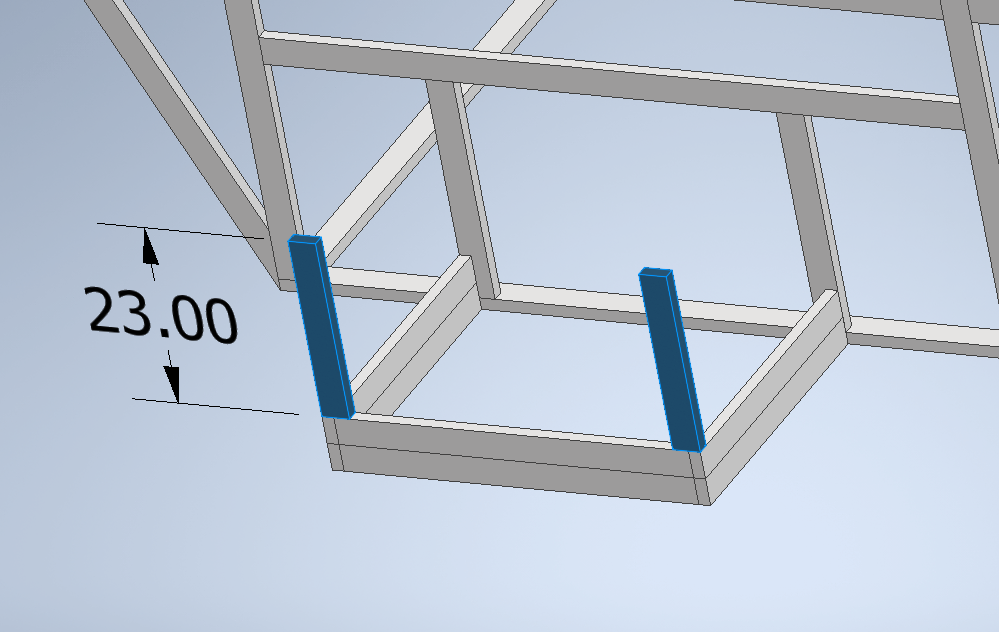
[picture p54: figure]

## Slide 15

(1) 2x4x10
- (2) 3’
- (1) 3’9”

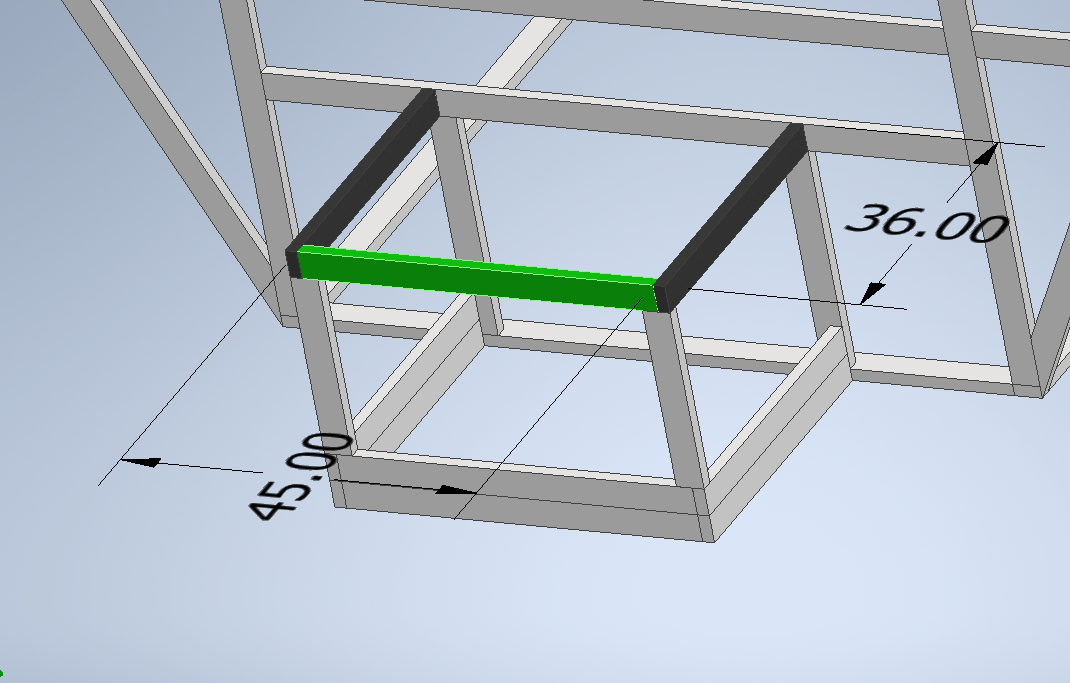
[picture p55: figure]

## Slide 16

(2) A boards
- (2) 11”

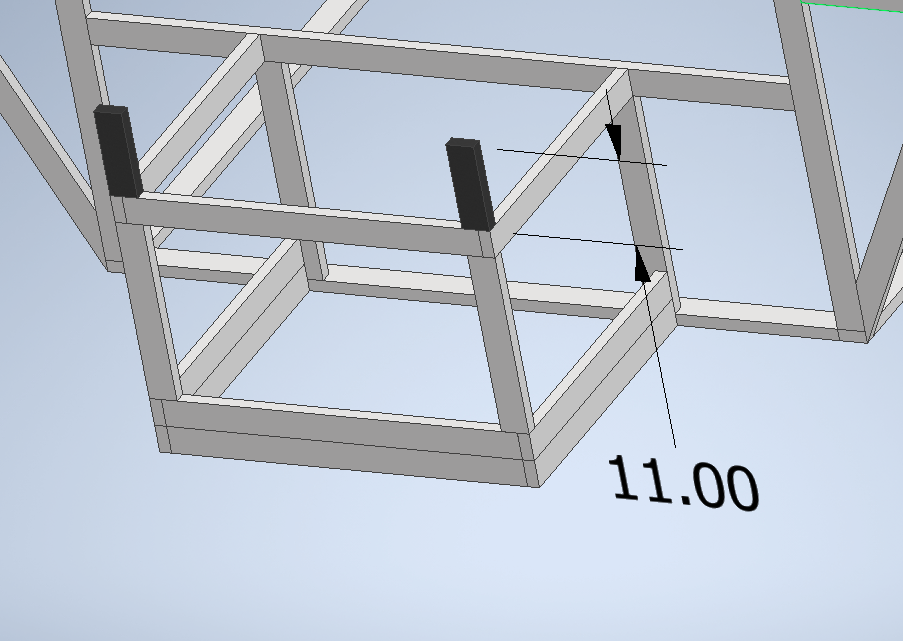
[picture p56: figure]

## Slide 17

(1) 2x4x10
- (2) 3’
- (1) 3’9”

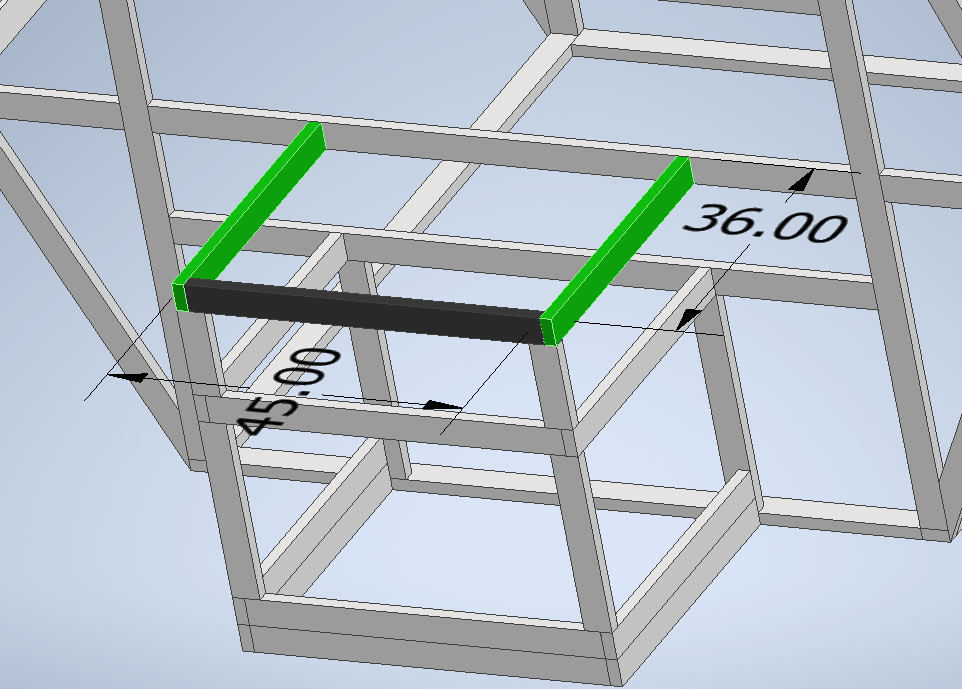
[picture p57: figure]

## Slide 18

(2) 2x4x10
- (2) 12”
  - Cut ONE 12” from each 10’
  - WRITE (E) ON LEFTOVER BOARDS [9’] AND SAVE

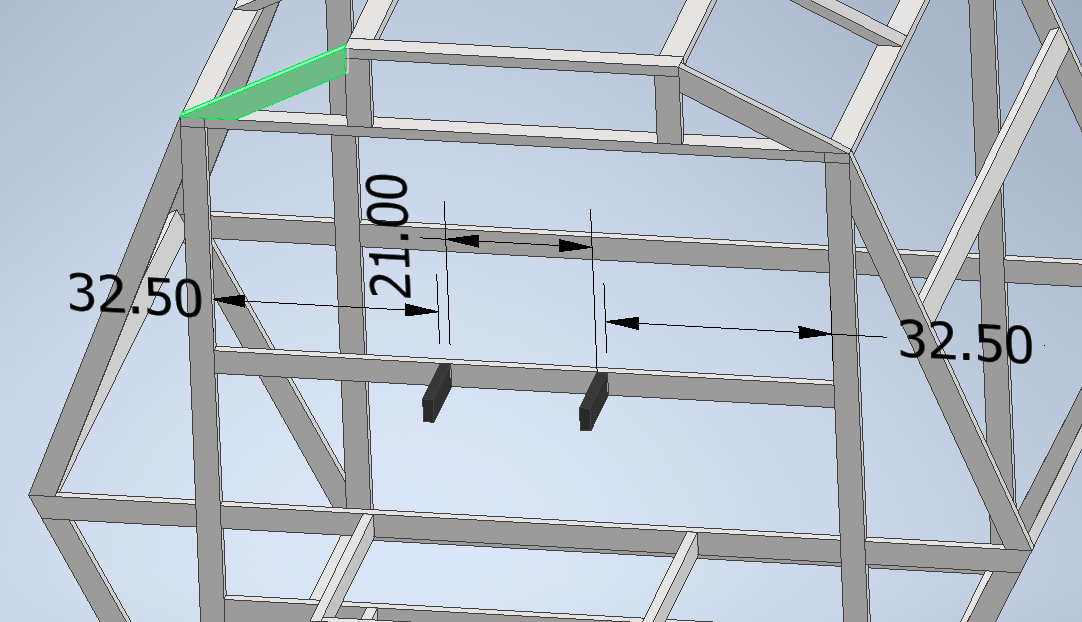
[picture p58: figure]

12.00

## Slide 19

(1) scrap???
- (1) 21”

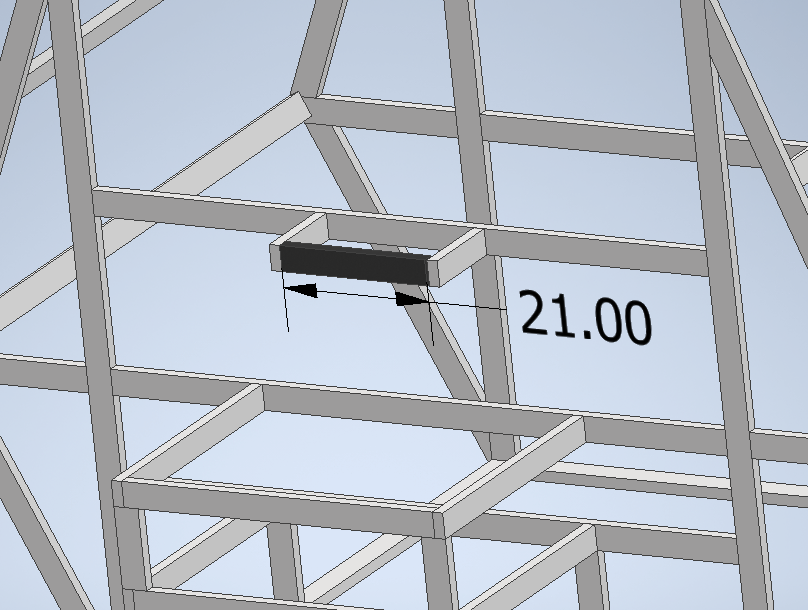
[picture p59: figure]

## Slide 20

(2) D boards (75” miscuts)
- (2) slants
  - One from each board

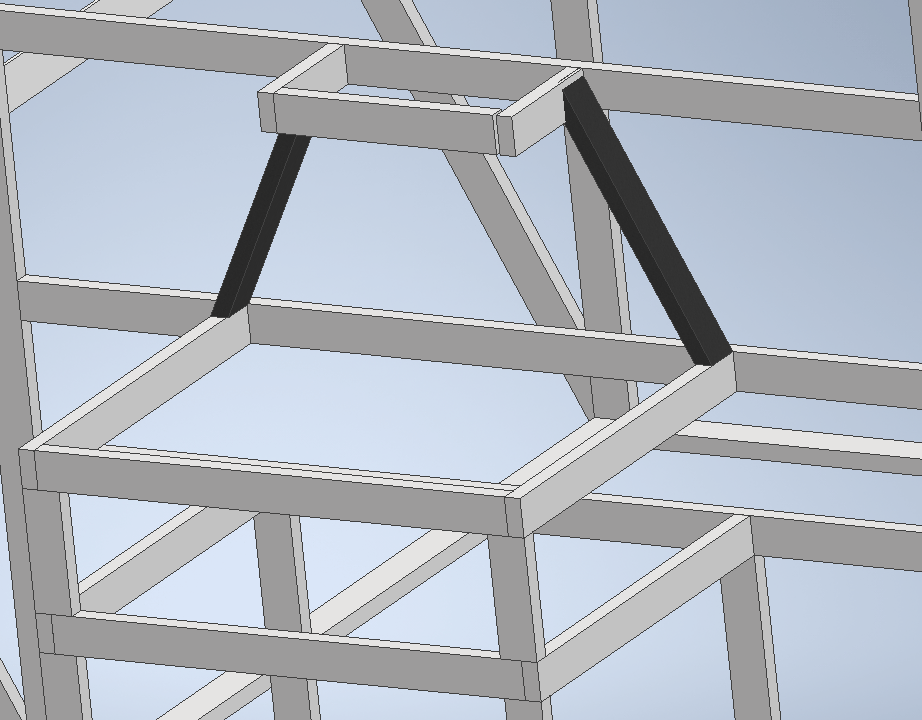
[picture p60: figure]

## Slide 21

(2) B boards
- (2) slants
  - One from each board

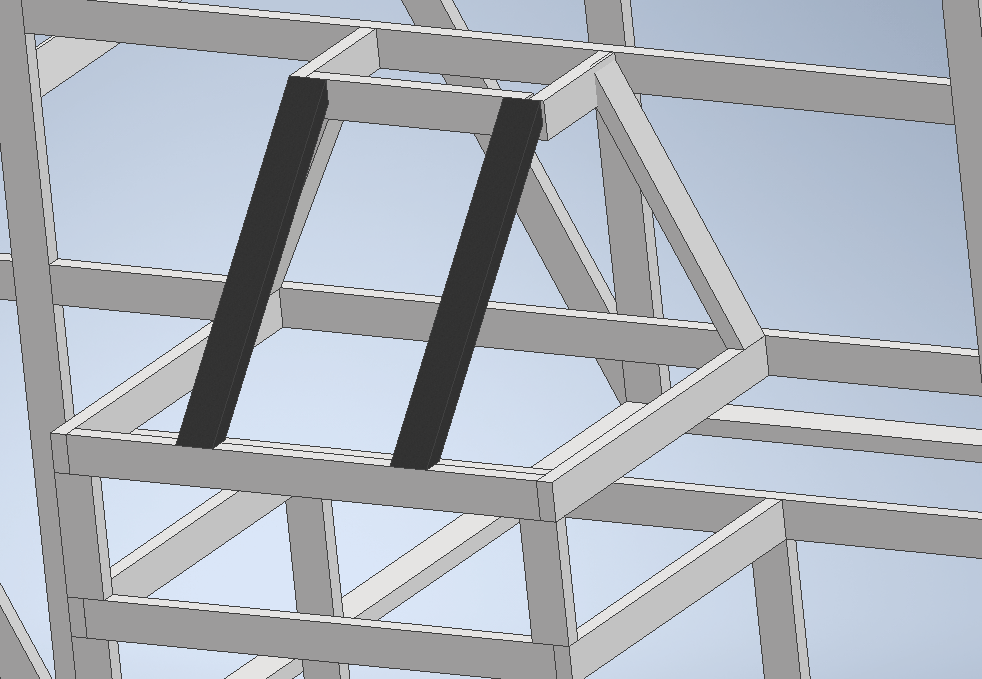
[picture p61: figure]

## Slide 22

(2) D boards
- (2) slants
  - One from each board

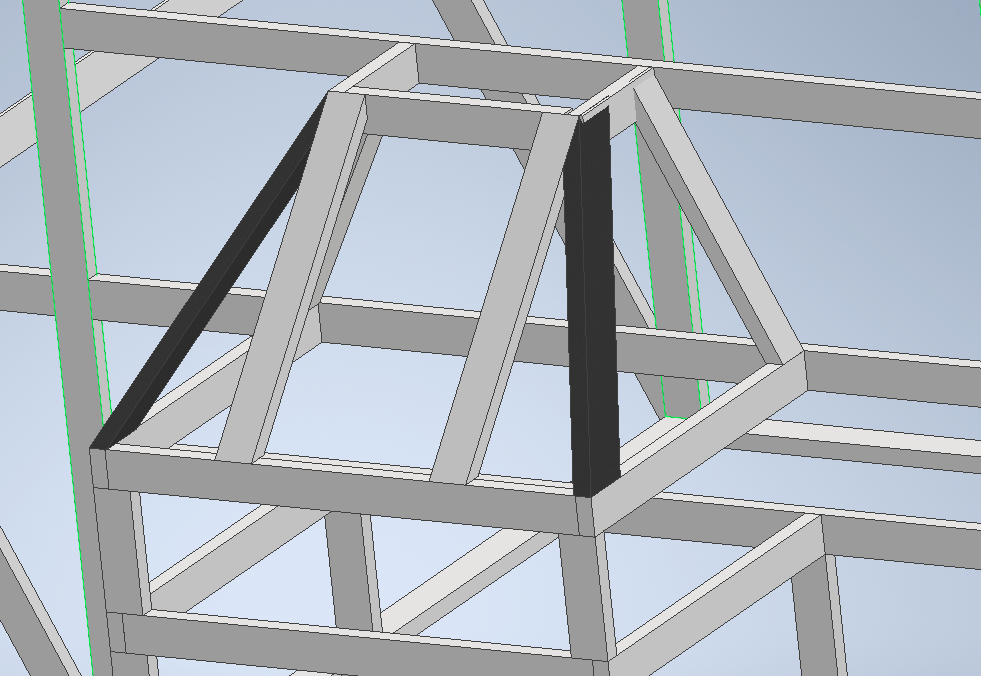
[picture p62: figure]

## Slide 23

(1) E board
- (2) slants

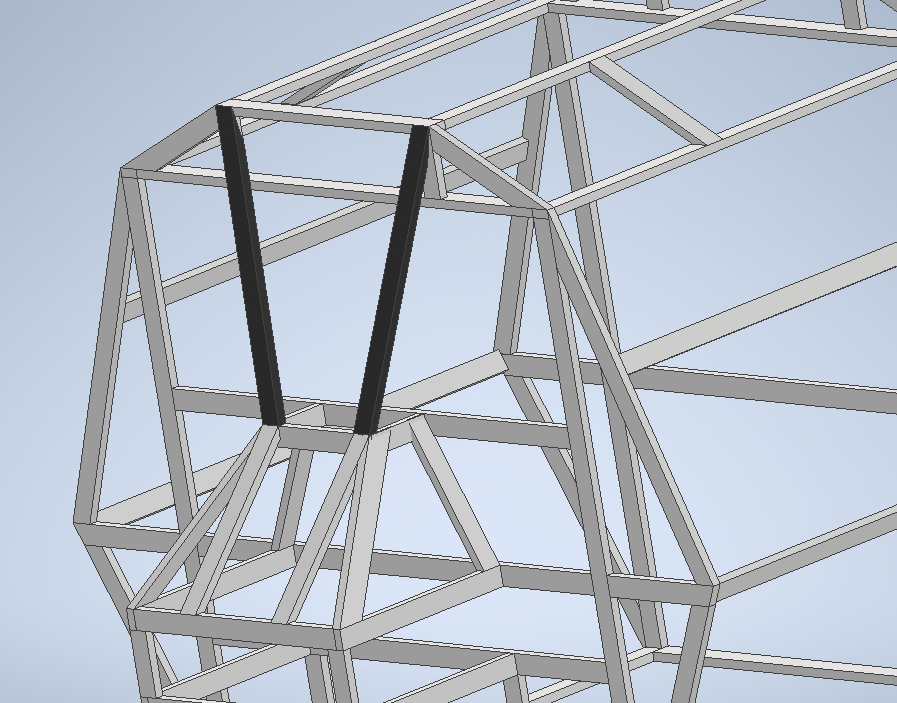
[picture p63: figure]

## Slide 24

(1) E board
- (2) slants

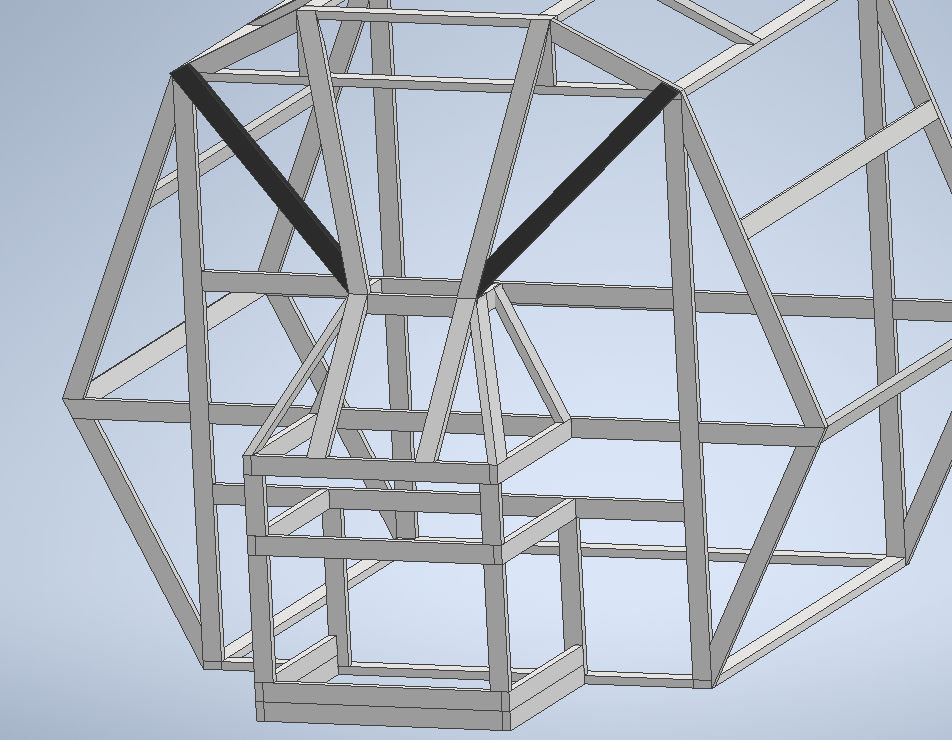
[picture p64: figure]

## Slide 25

(1) 2x4x12
- (2) ear tops
- (2) ear sides
(2) B boards
- (2) ear bottoms
  - One from each board

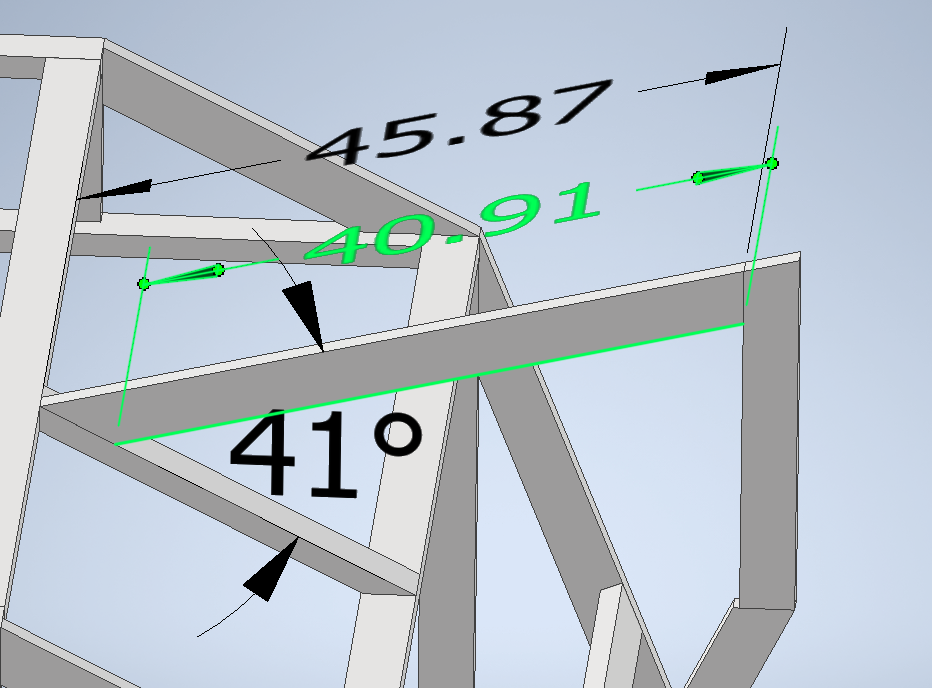
[picture p65: figure]
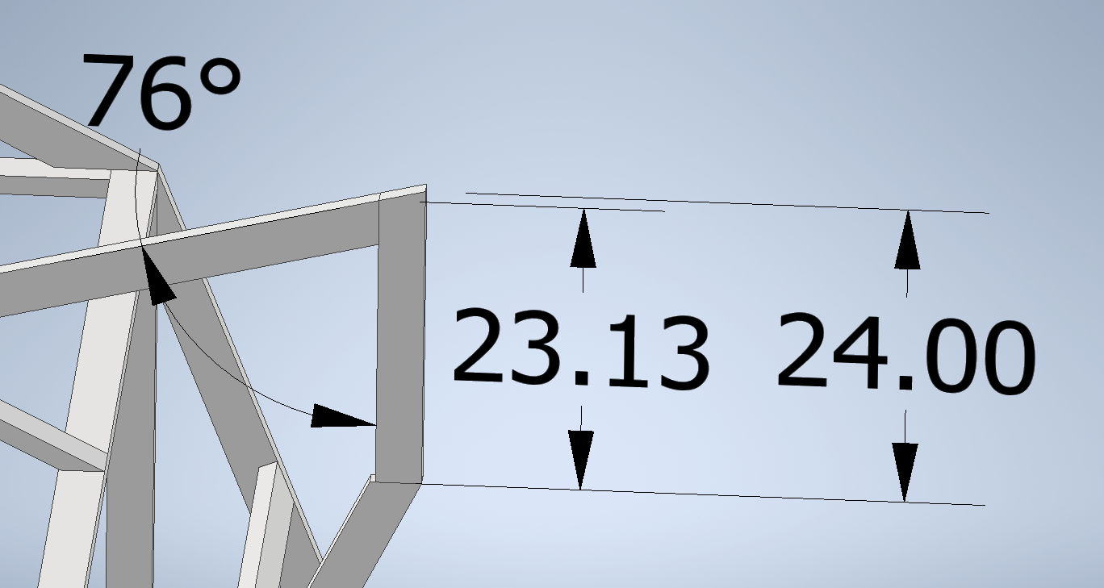
[picture p66: figure]
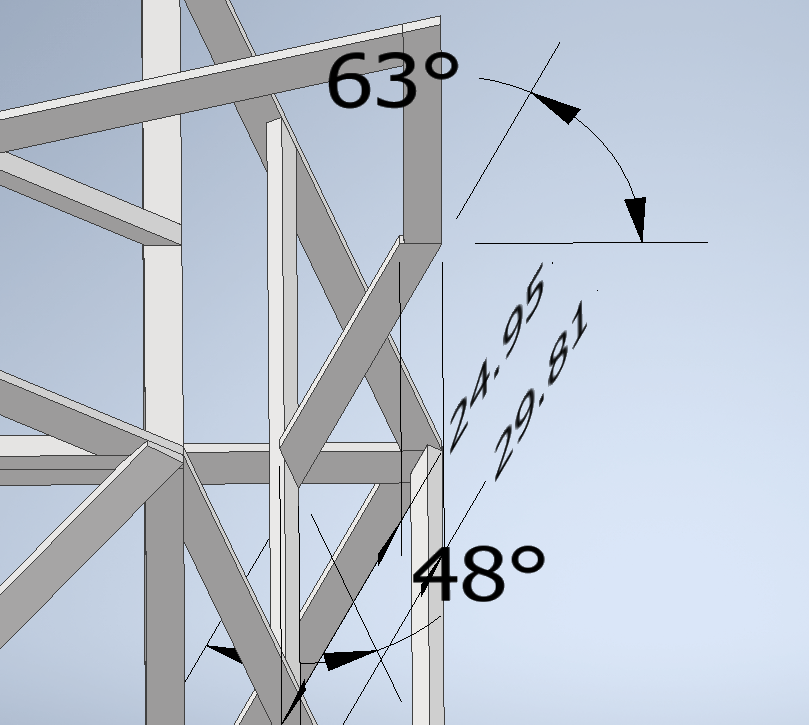
[picture p67: figure]
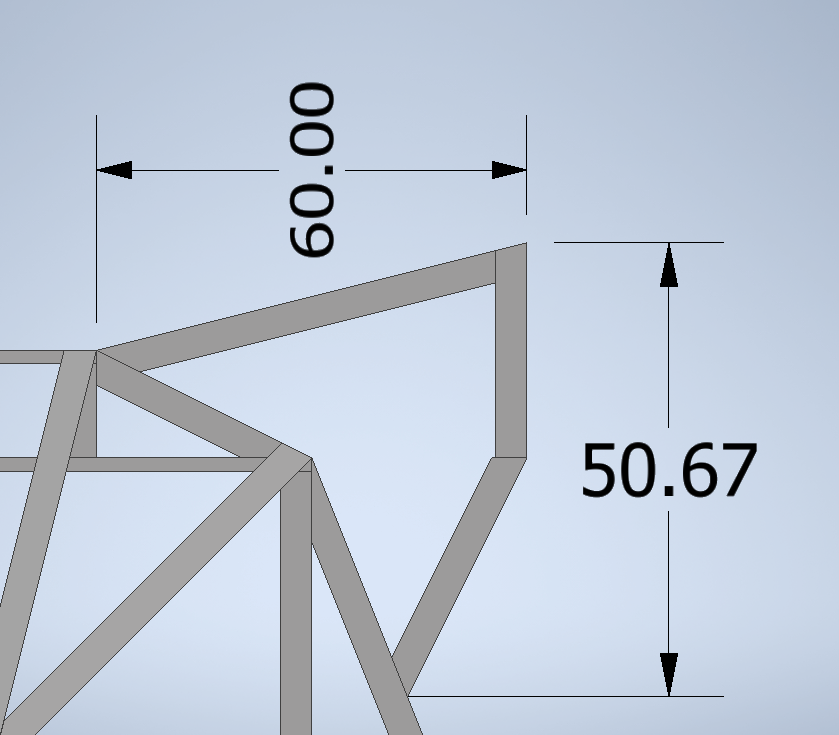
[picture p68: figure]

## Slide 26

voila

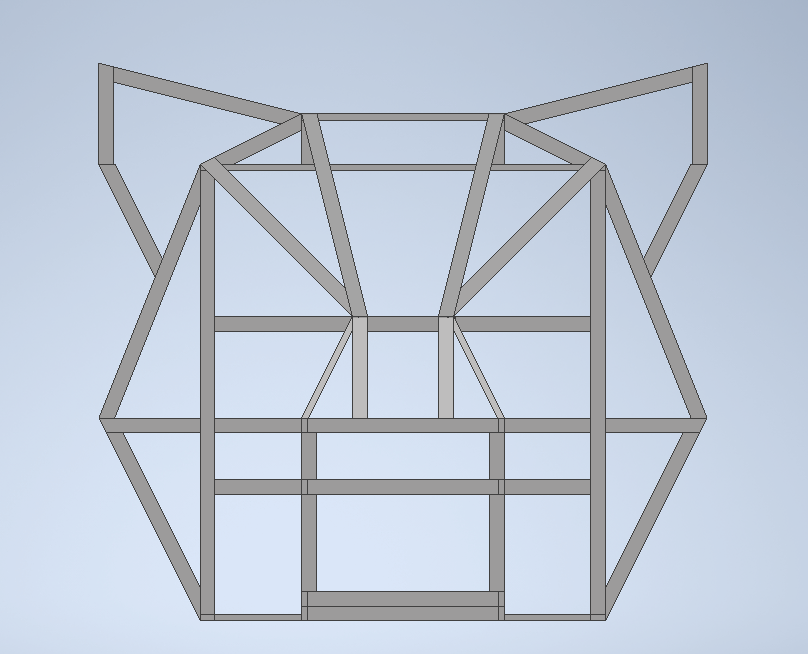
[picture p69: figure]
