UofSC-ASME/USC-ASME-TigerBurn-2026/Build Instructions/L shoulder..pptx

## LEFT shoulder

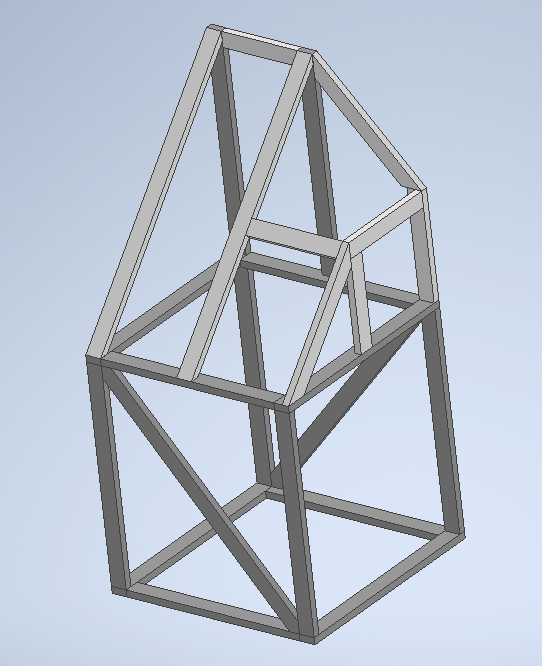
[picture p70: figure]

1.5 2x4x8
7 2x4x12

Very important to be using the right pieces and board sizes!!! Please keep track and label boards as you cut!!

## Slide 2

(2) 2x4x8
(7) 2x4x12

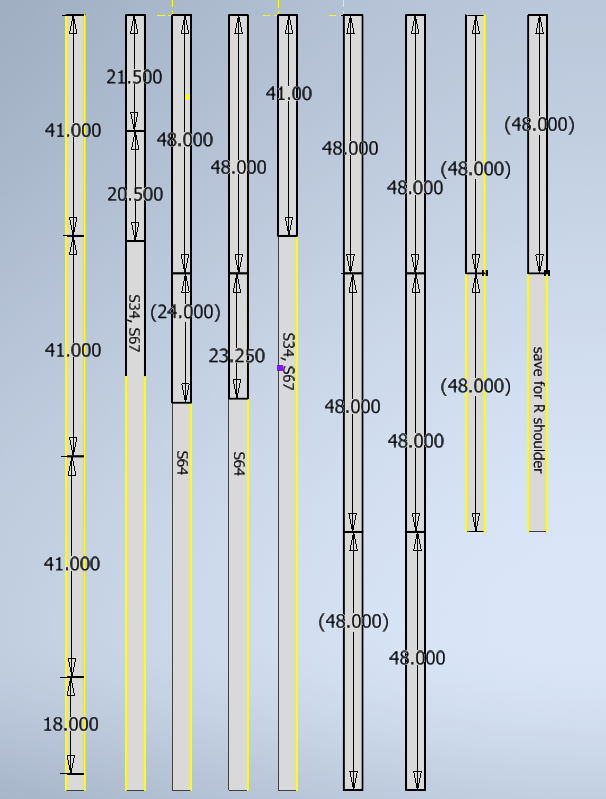
[picture p71: figure]

Mark and cut boards like this →
Label each board as written here and keep together

Very important to be using the right pieces and board sizes!!! Please keep track and label boards as you cut!!

## Slide 3

(2) 48”
(2) 41”

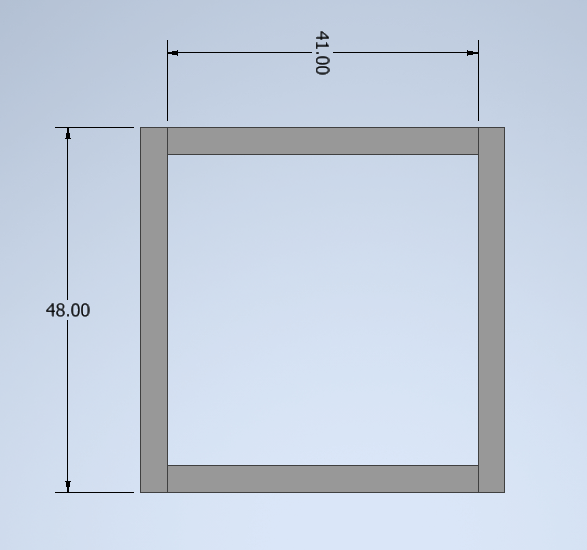
[picture p72: figure]

## Slide 4

(4) 48”

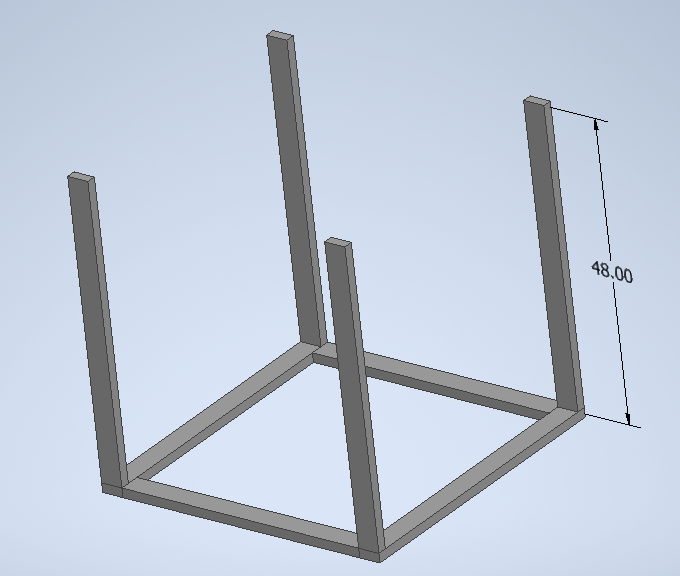
[picture p73: figure]

## Slide 5

(2) 48”
(2) 41”

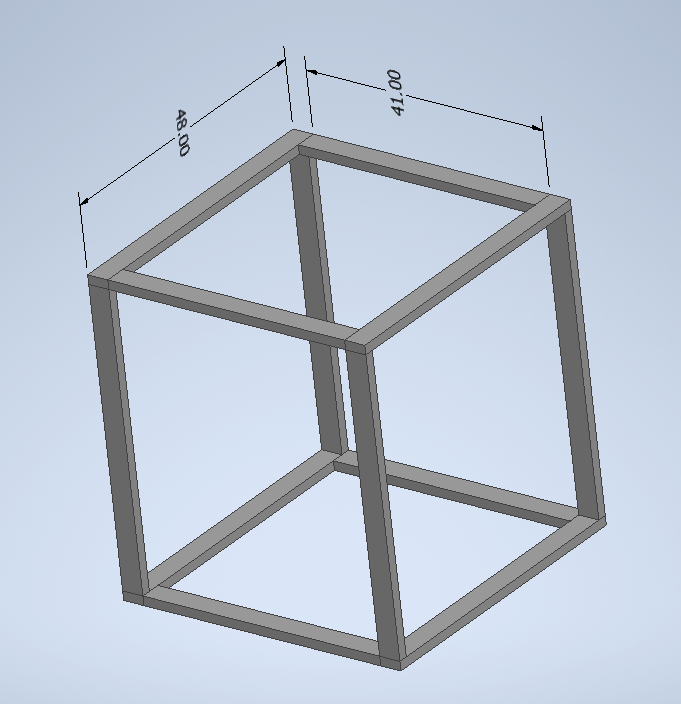
[picture p74: figure]

## Slide 6

Use the 2 pieces marked S64, one cut from each

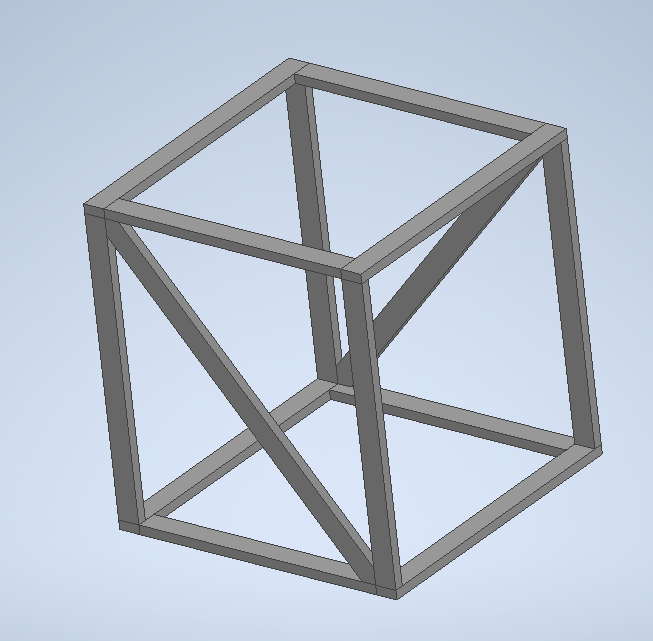
[picture p75: figure]

## Slide 7

(2) 48”
(1) 18”

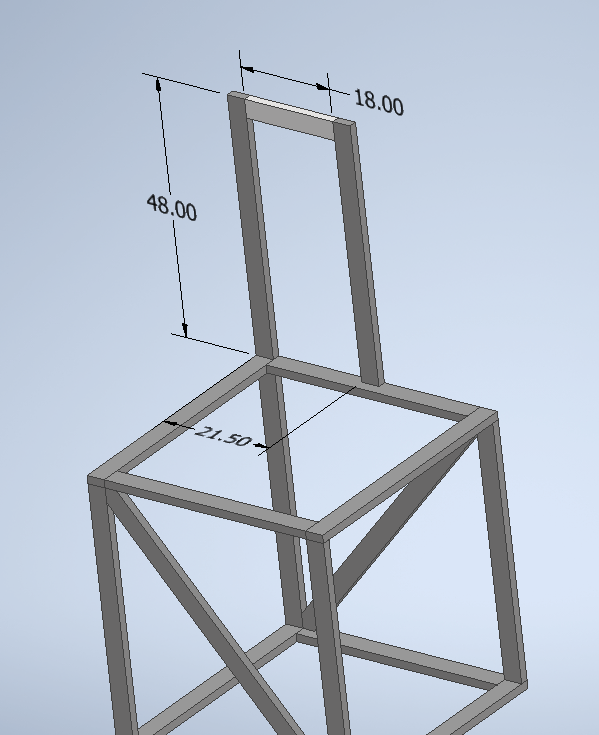
[picture p76: figure]

## Slide 8

1. 20.5”
(1) 24”
(1) 23.25”

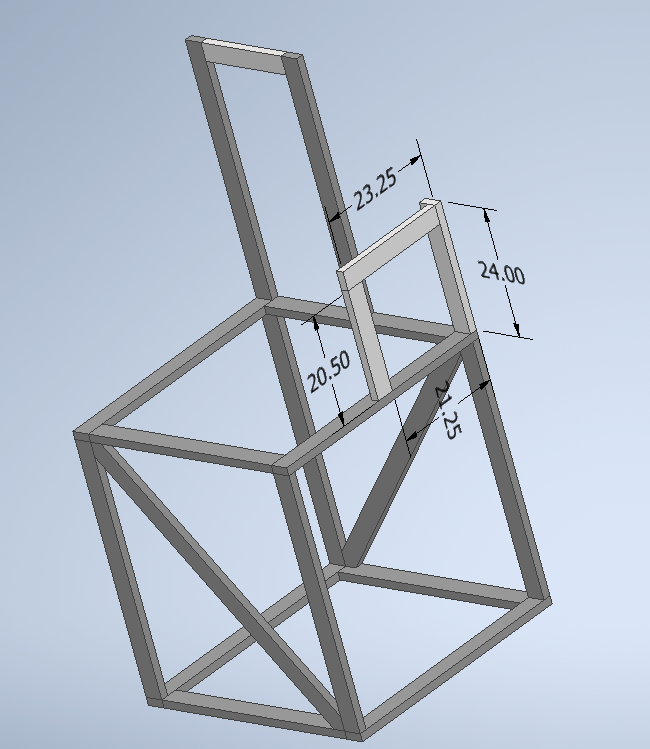
[picture p77: figure]

## Slide 9

(2) S67
(1) S34

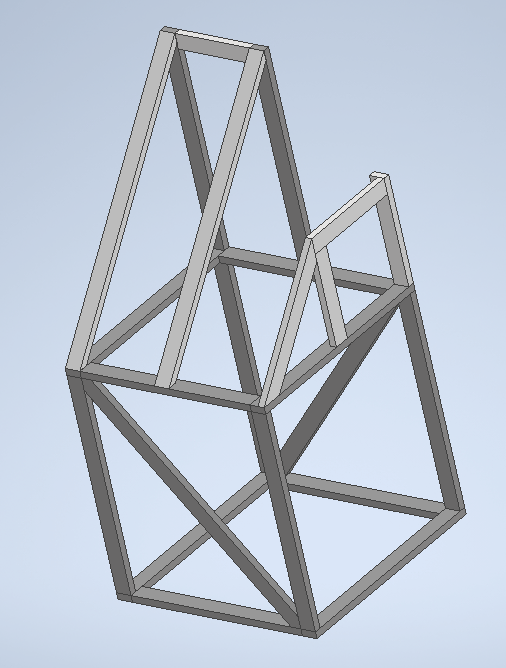
[picture p78: figure]

## Slide 10

1. 21.5”

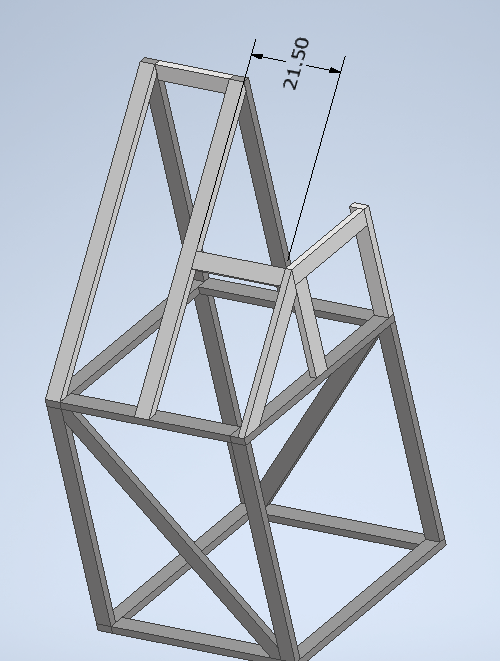
[picture p79: figure]

## Slide 11

(1) S34

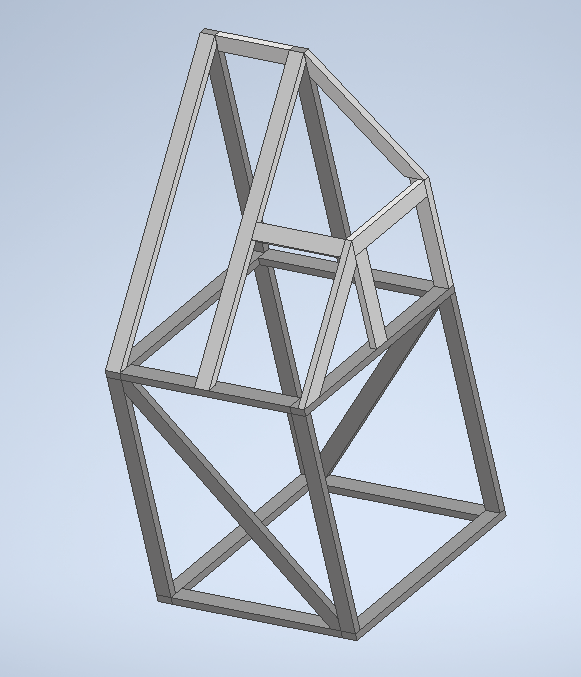
[picture p80: figure]
