UofSC-ASME/USC-ASME-TigerBurn-2026/Build Instructions/R shoulder..pptx

## RIGHT shoulder

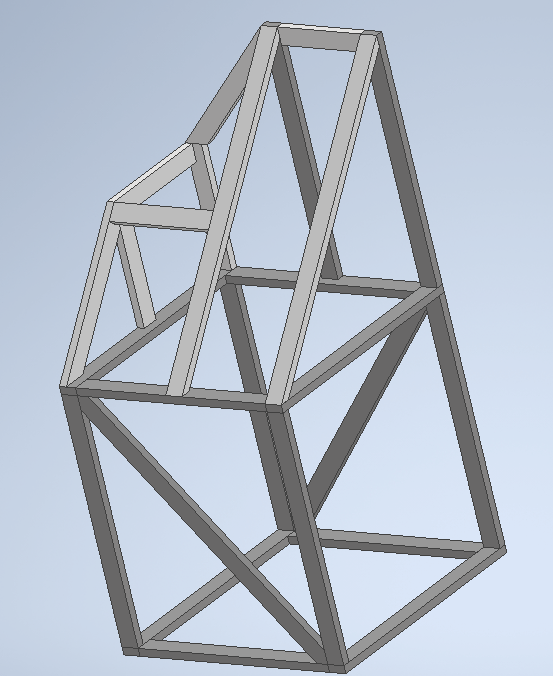
[picture p81: figure]

1.5 2x4x8
7 2x4x12

Very important to be using the right pieces and board sizes!!! Please keep track and label boards as you cut!!

## Slide 2

(1) 2x4x8
(7) 2x4x12

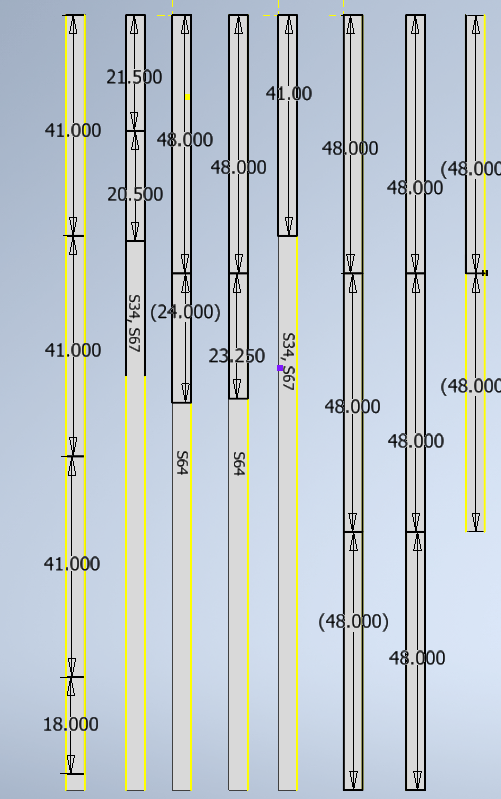
[picture p82: figure]

Mark and cut boards like this →
Label each board as written here and keep together

+ 48” saved from L shoulder

Very important to be using the right pieces and board sizes!!! Please keep track and label boards as you cut!!

## Slide 3

(2) 48”
(2) 41”


## Slide 4

(4) 48”


## Slide 5

(2) 48”
(2) 41”


## Slide 6

Use the 2 pieces marked S64, one cut from each


## Slide 7

(2) 48”
(1) 18”

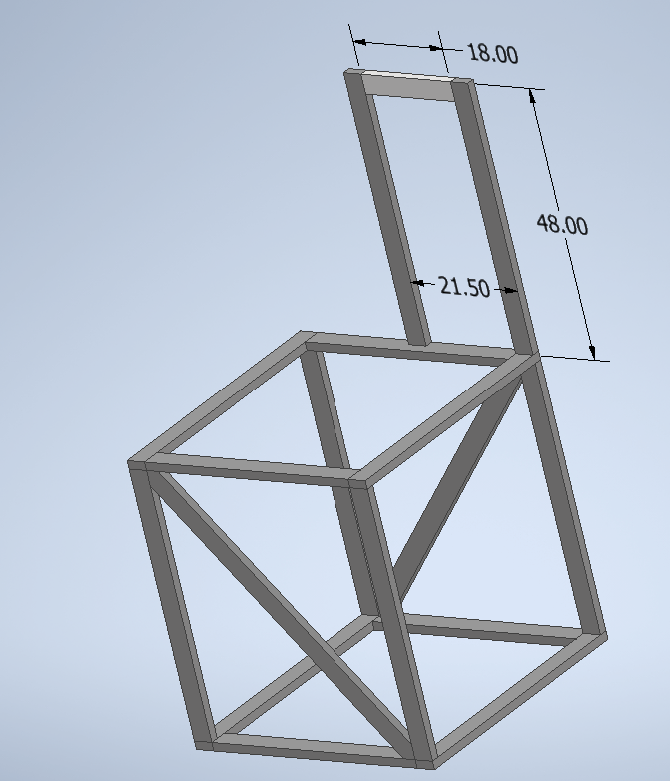
[picture p83: figure]

## Slide 8

1. 20.5”
(1) 24”
(1) 23.25”

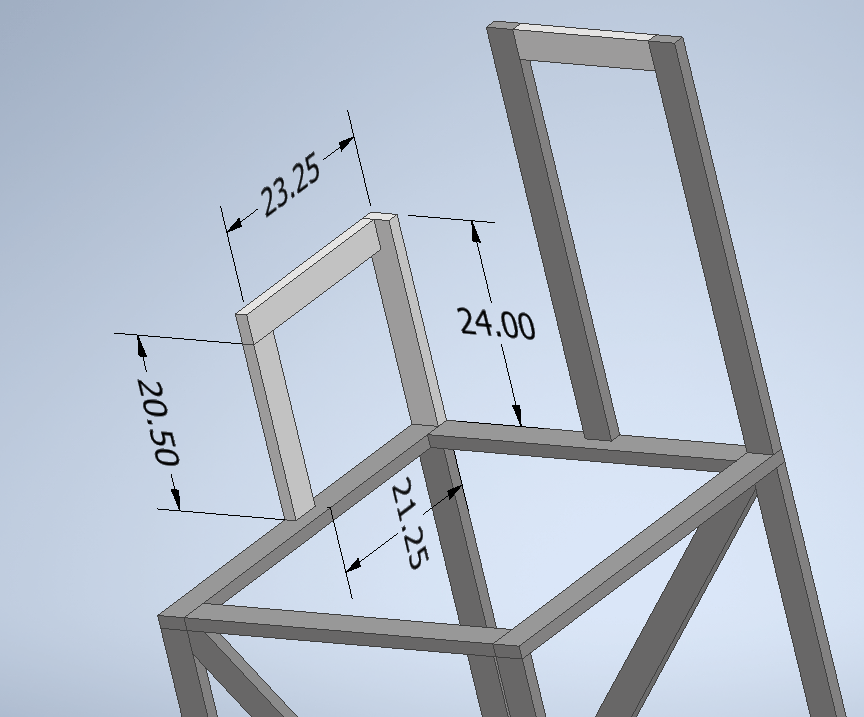
[picture p84: figure]

## Slide 9

(2) S67
(1) S34

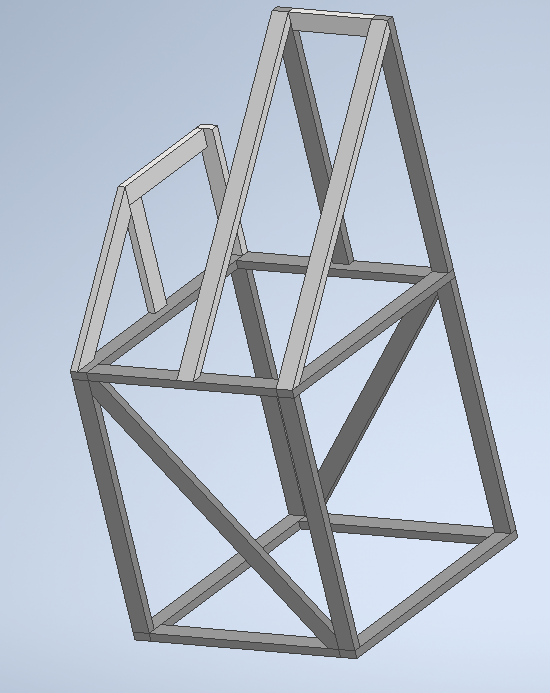
[picture p85: figure]

## Slide 10

1. 21.5”

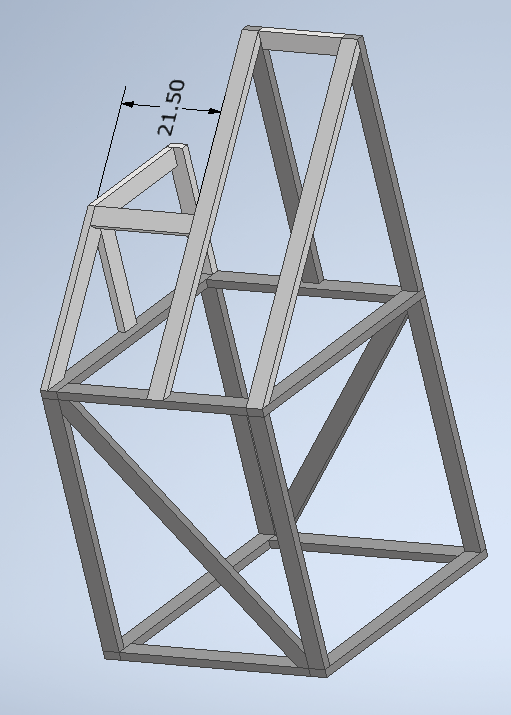
[picture p86: figure]

## Slide 11

(1) S34
