UofSC-ASME/USC-ASME-TigerBurn-2026/Build Instructions/Base 3.x.pptx

## Base 3

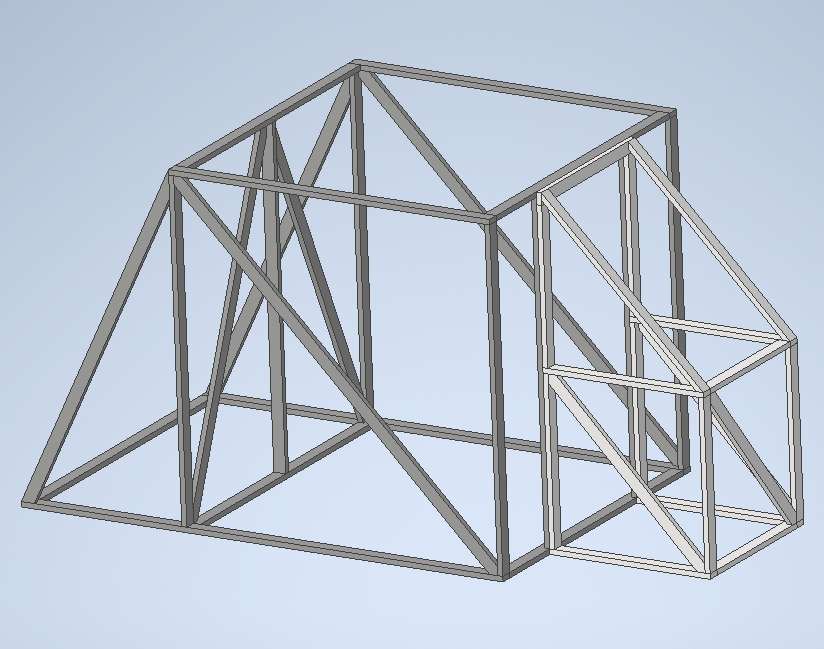
[picture p87: figure]

20 2x4x8
5 2x4x10
6 2x4x12

## Slide 2

(2) 2x4x12
- (2) 12’
(3) 2x4x8
→ (3) 7’5”

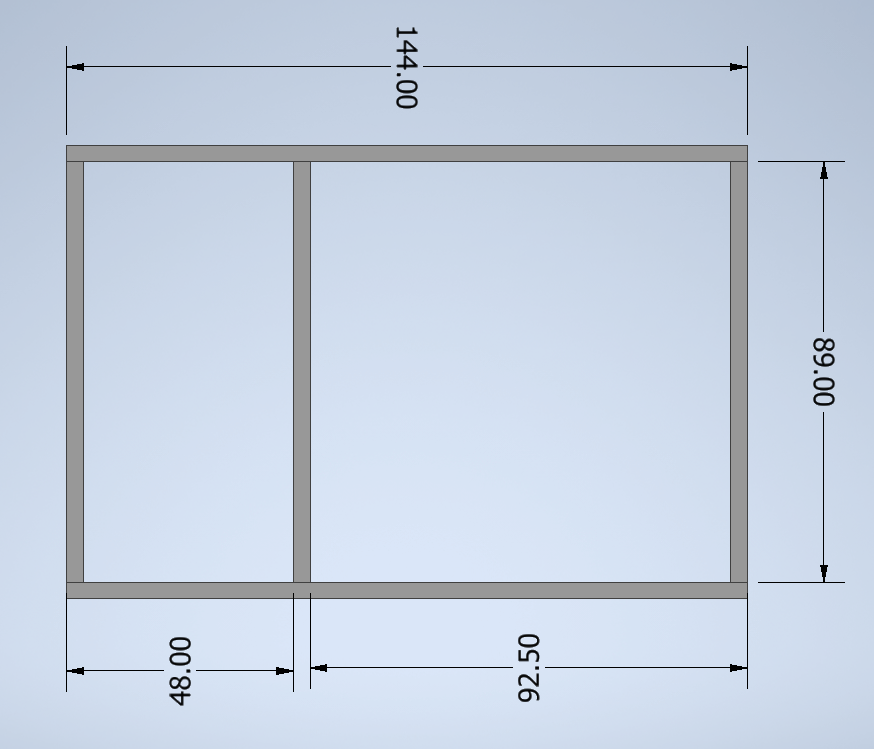
[picture p88: figure]

## Slide 3

(7) 2x4x8
→ (7) 8’

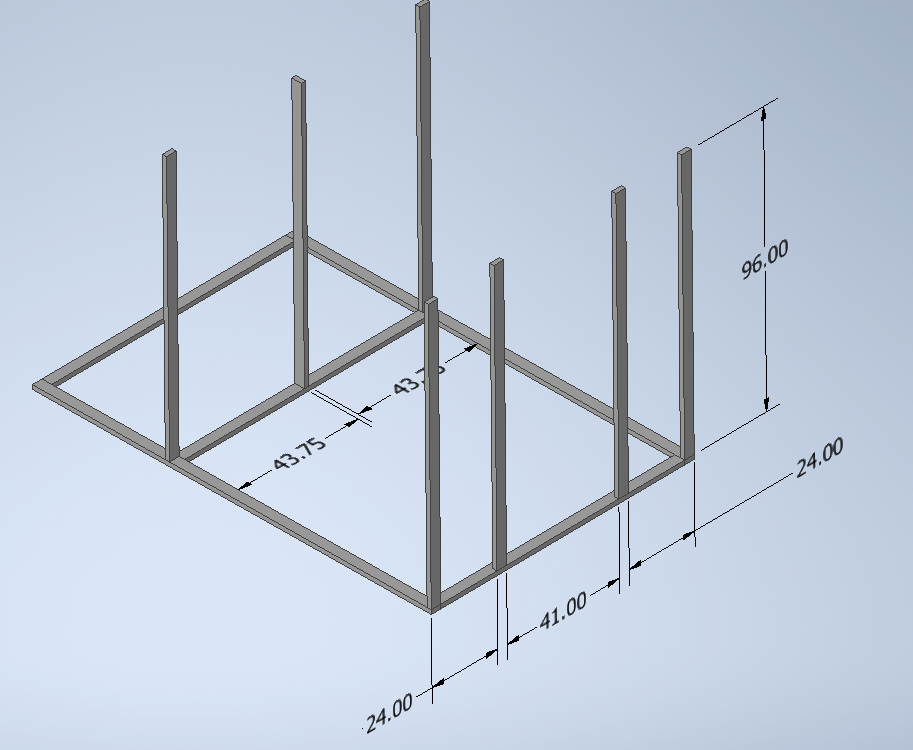
[picture p89: figure]

## Slide 4

(2) 2x4x8
- (2) 8’
(2) 2x4x8
→ (2) 7’5”

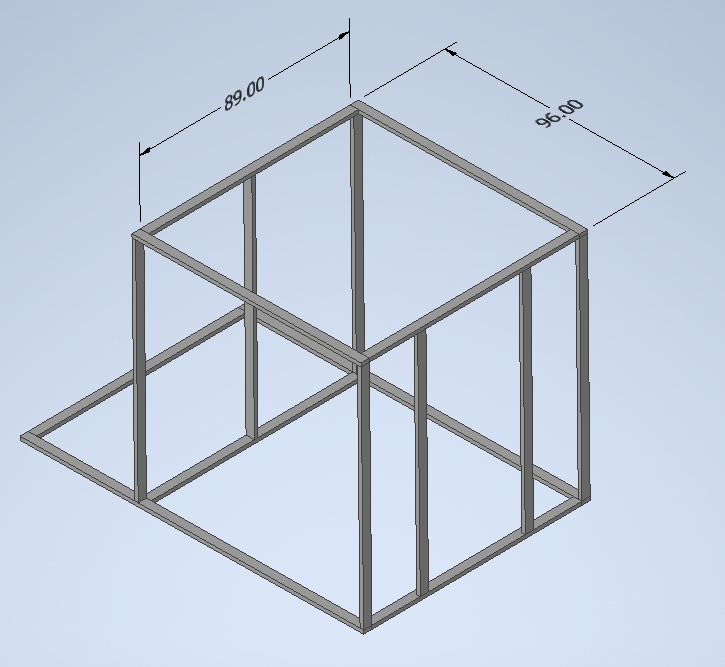
[picture p90: figure]

## Slide 5

(2) 2x4x12
- (2) internal slants
(2) 2x4x10
- (2) external slants

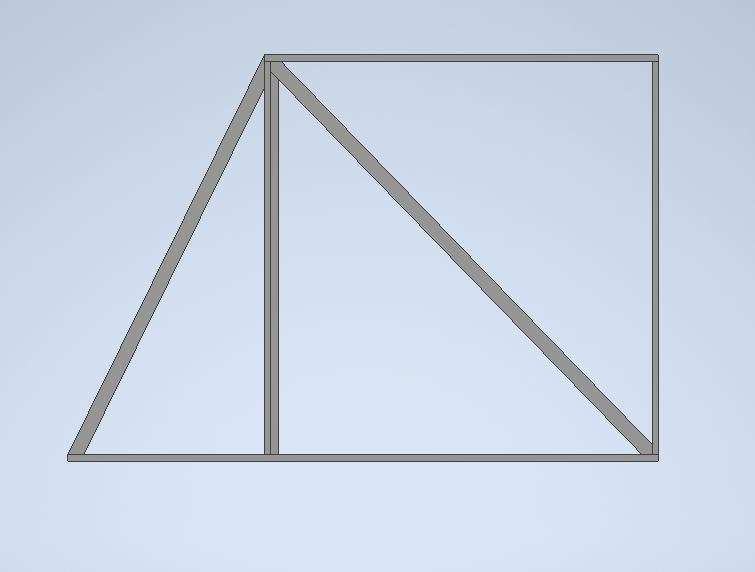
[picture p91: figure]

## Slide 6

(2) 2x4x10
- (2) slants

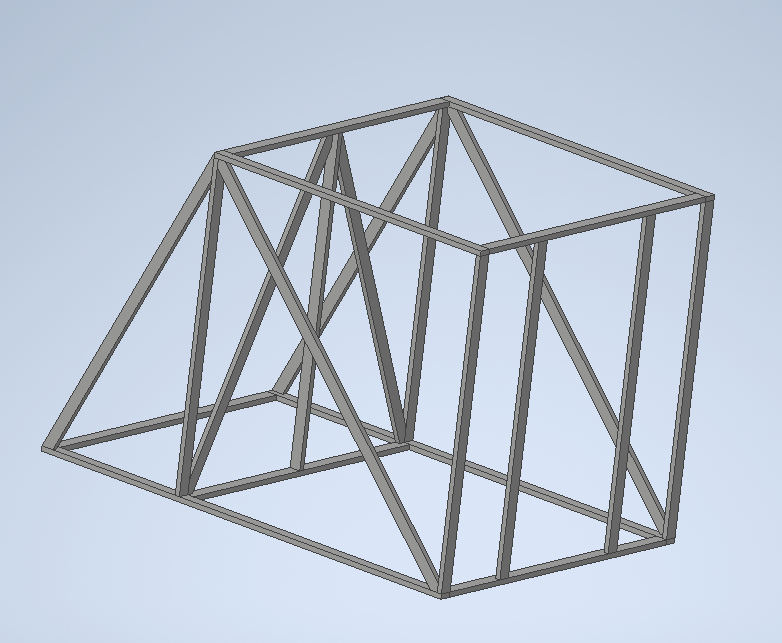
[picture p92: figure]

## Slide 7

(1.5) 2x4x8
- (2) 4’
- (1) 3’5”
  - save other half for top piece

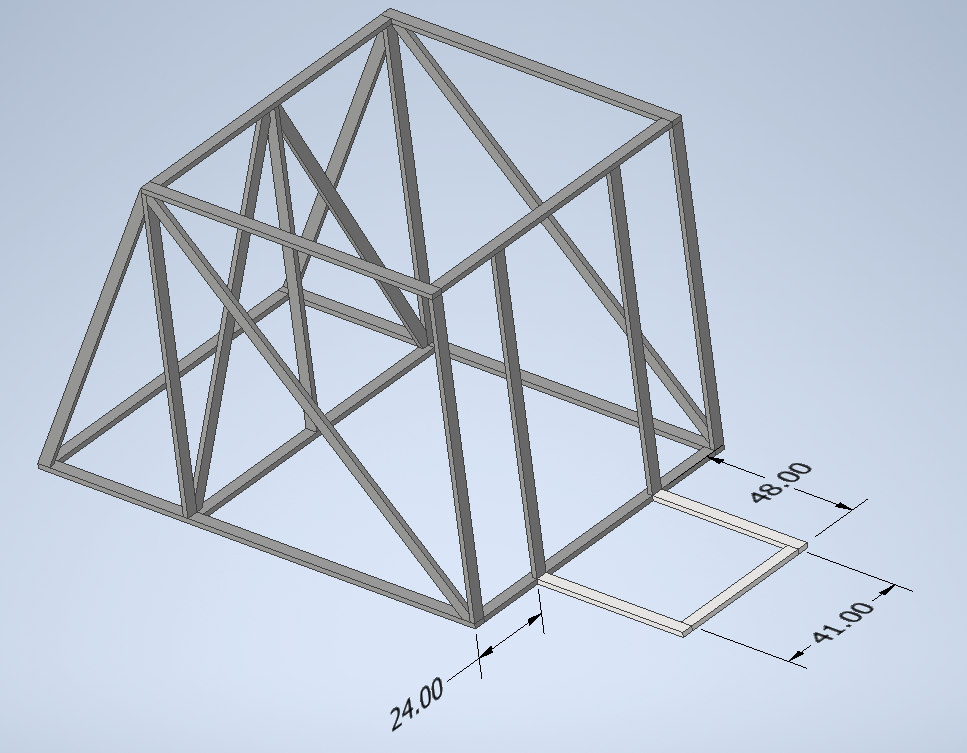
[picture p93: figure]

## Slide 8

(2) 2x4x8
- (4) 4’

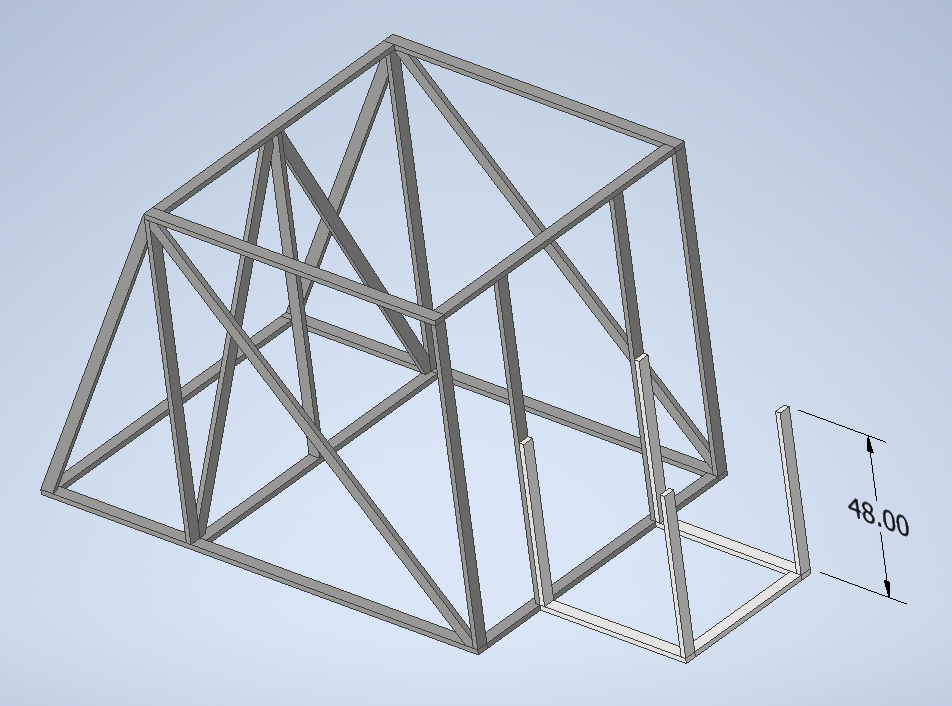
[picture p94: figure]

## Slide 9

(1.5) 2x4x8
- (2) 4’
- (1) 3’5”
  - from other half of bottom piece

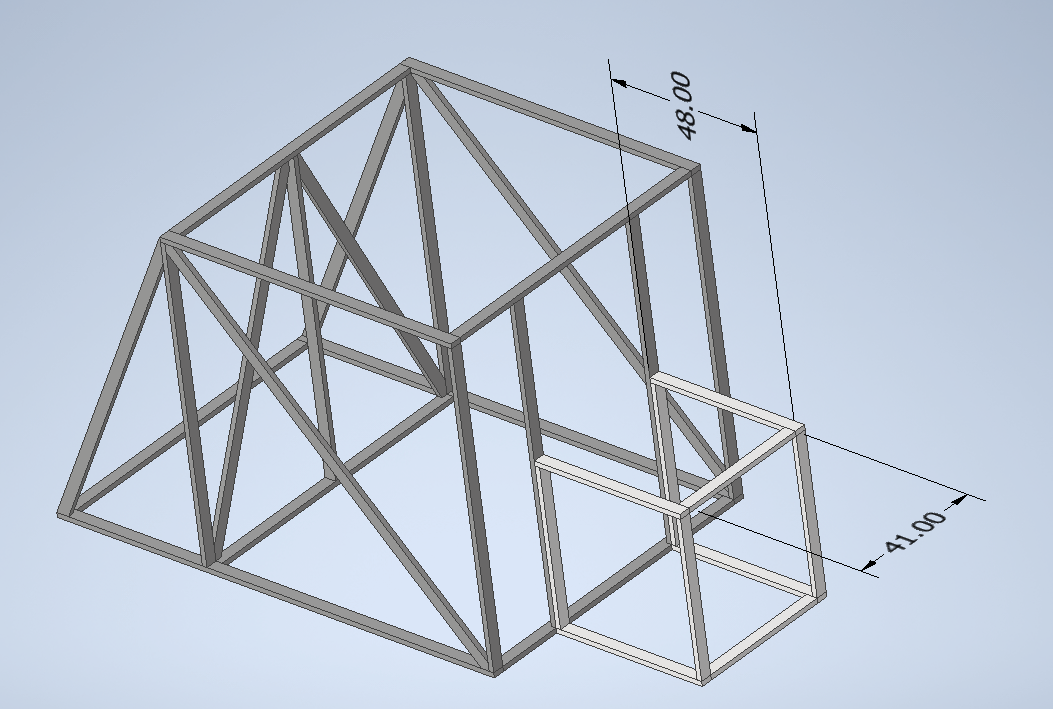
[picture p95: figure]

## Slide 10

(0.5) 2x4x10
- (1) 4’
  - save other half for front slant
(1) 2x4x8
- (1) 3’8.5”

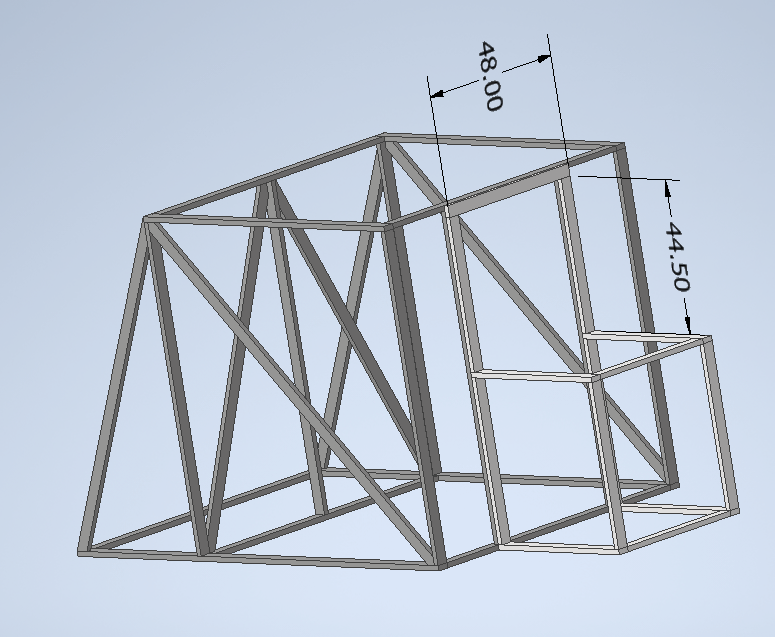
[picture p96: figure]

## Slide 11

(2) 2x4x12
- (4) slants

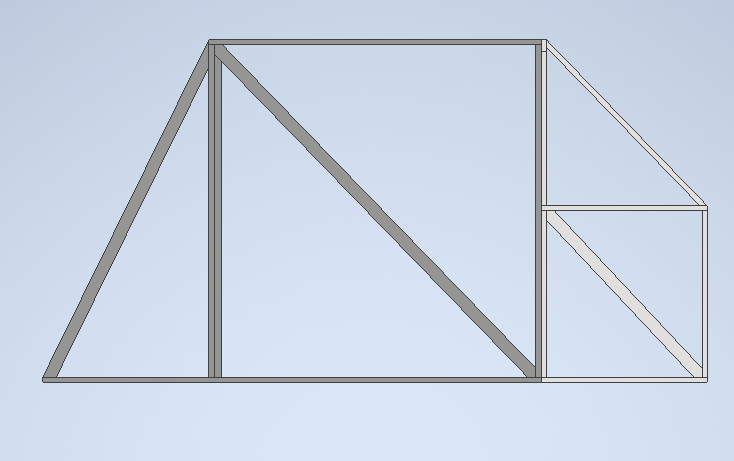
[picture p97: figure]

## Slide 12

(0.5) 2x4x10
- (1) slant
  - Saved from other half of top piece
