UofSC-ASME/USC-ASME-TigerBurn-2026/Build Instructions/F Foot..pptx

x2 (base and top)

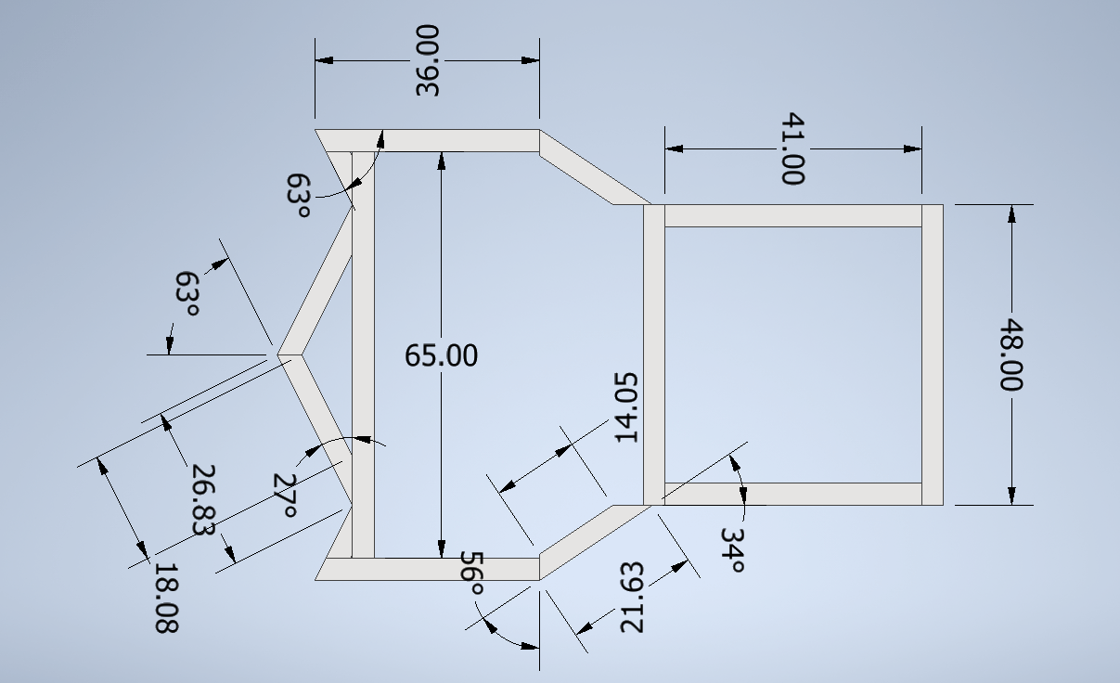
[picture p98: figure]

## Slide 4

(2) 2x4x8
- (11) 4’

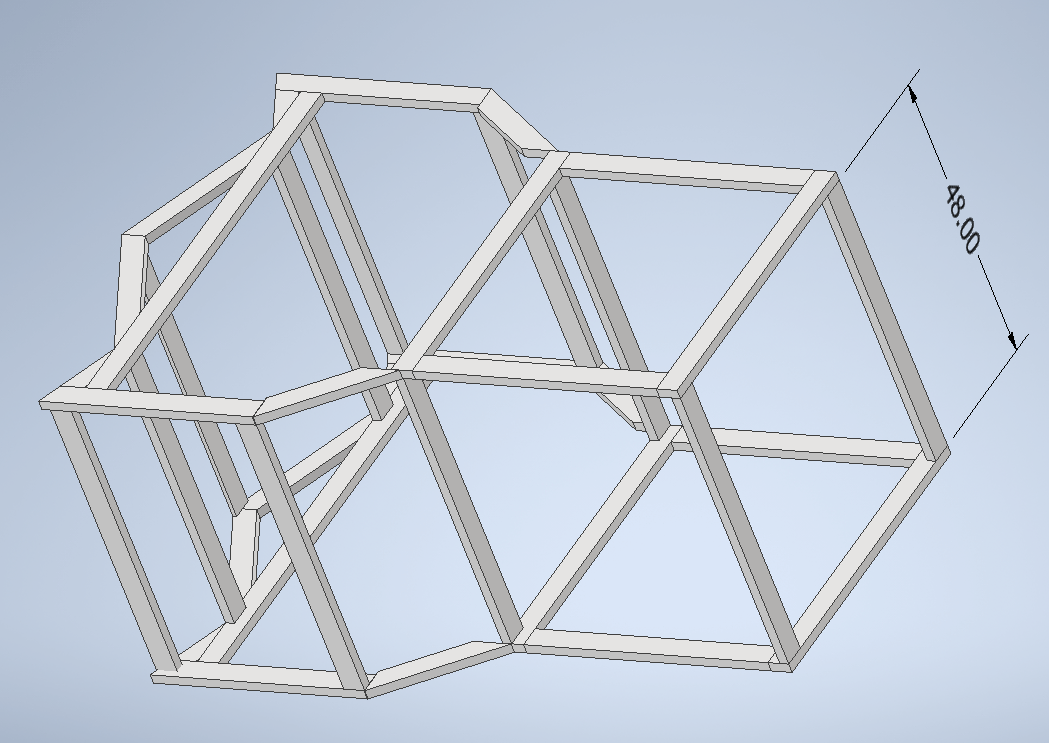
[picture p99: figure]
