UofSC-ASME/USC-ASME-TigerBurn-2026/Build Instructions/Base1.x.pptx

## Base 1

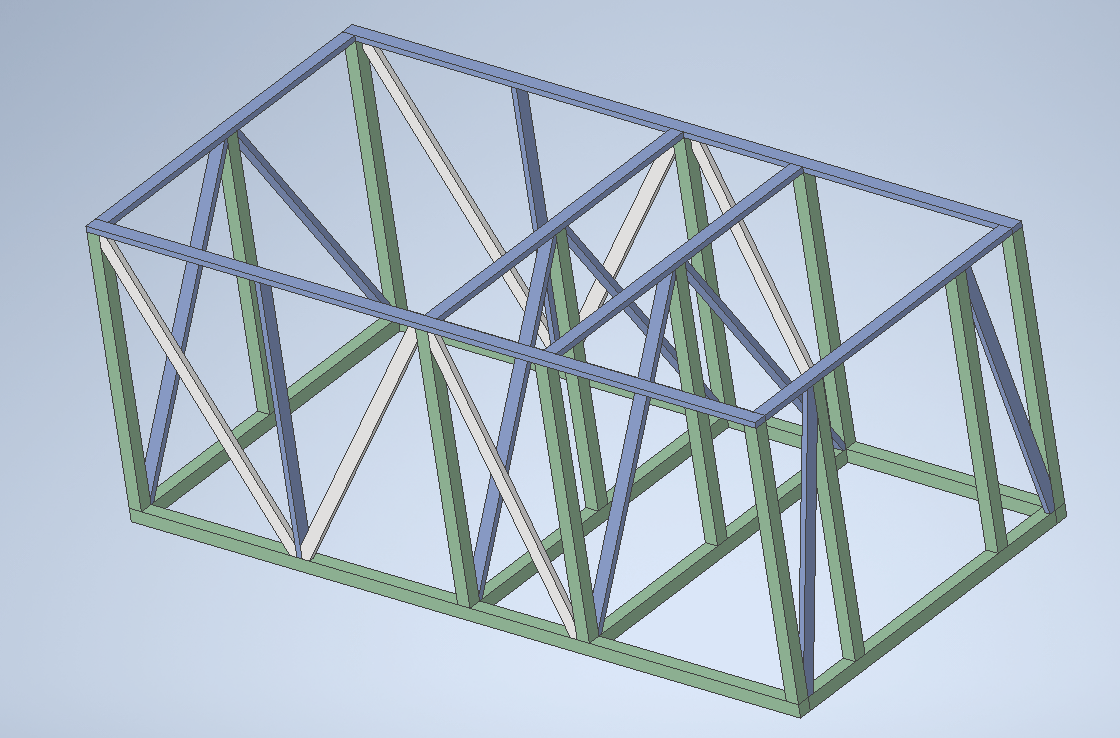
[picture p100: figure]

2 4x4x16
17 4x4x8
18 2x4x8
1 2x4x12
2 2x4x16

## Slide 2

(2) 4x4x16
- (2) 16’
(4) 4x4x8
→ (4) 7’5”

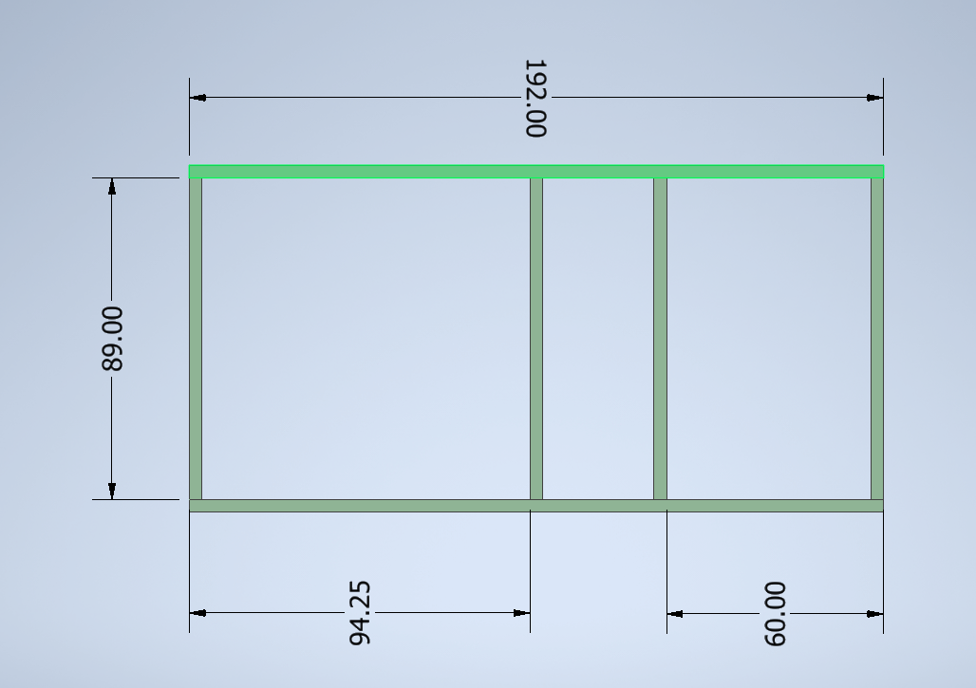
[picture p101: figure]

## Slide 3

(13) 4x4x8
→ (13) 6’
1. 2x4x12
→ (2) 6’

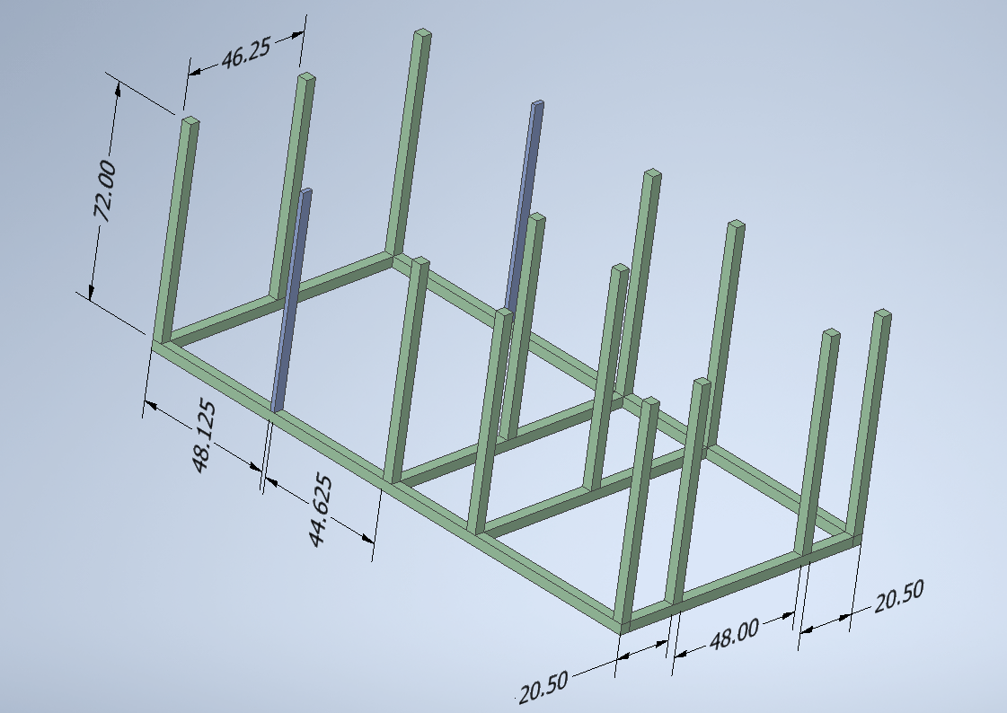
[picture p102: figure]

## Slide 4

(2) 2x4x16
- (2) 16’
(4) 2x4x8
→ (4) 7’5”

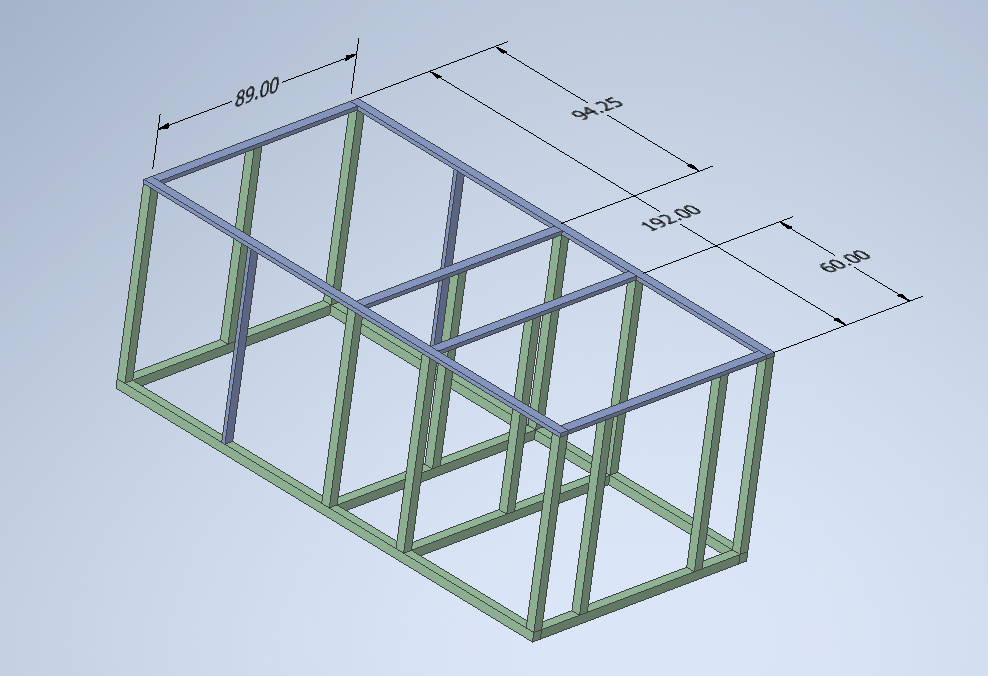
[picture p103: figure]

## Slide 5

(6) 2x4x8
- (6) slants

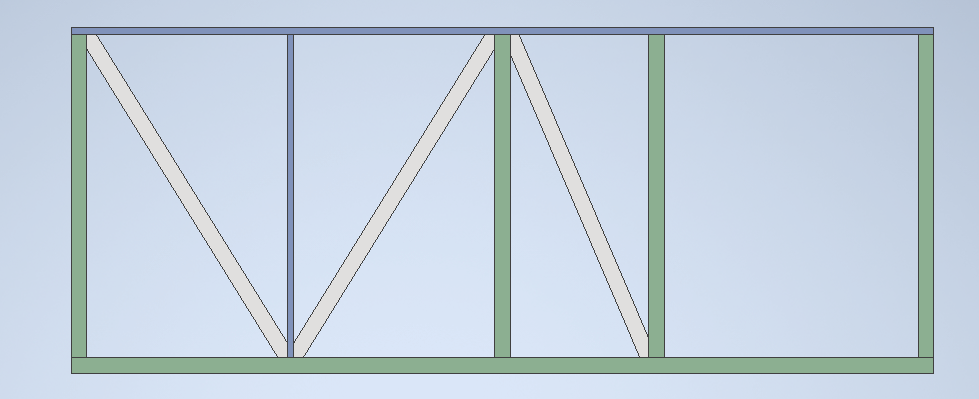
[picture p104: figure]

## Slide 6

(8) 2x4x8
- (8) slants
