UofSC-ASME/USC-ASME-TigerBurn-2026/Build Instructions/Base2.x.pptx

## Base 2

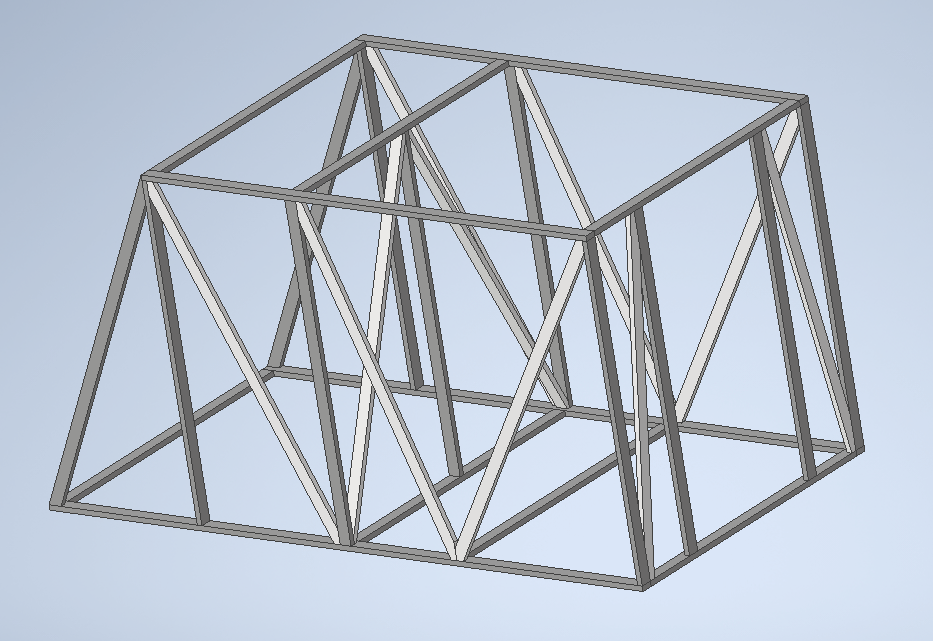
[picture p105: figure]

16 2x4x8
12 2x4x10
2 2x4x12
2 2x4x16

## Slide 2

(2) 2x4x16
- (2) 16’
(4) 2x4x8
→ (4) 7’5”

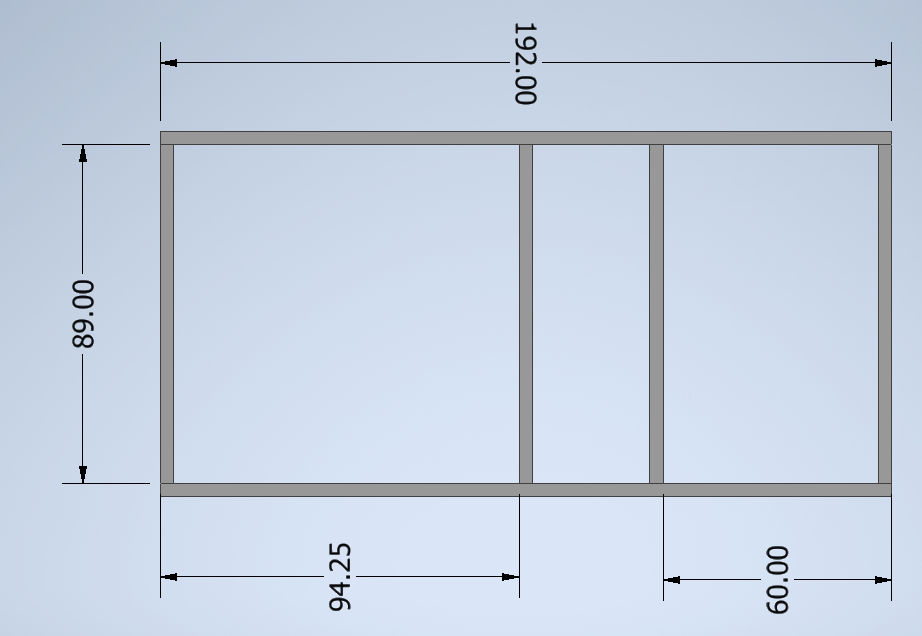
[picture p106: figure]

## Slide 3

(9) 2x4x8
→ (9) 8’

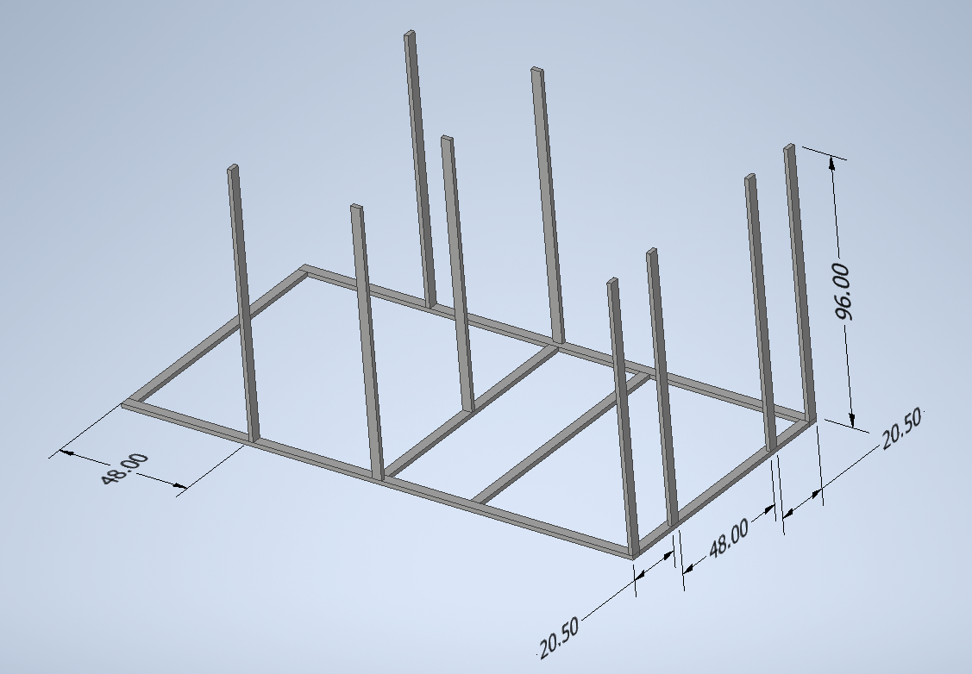
[picture p107: figure]

## Slide 4

(2) 2x4x12
- (2) 12’
(3) 2x4x8
→ (3) 7’5”

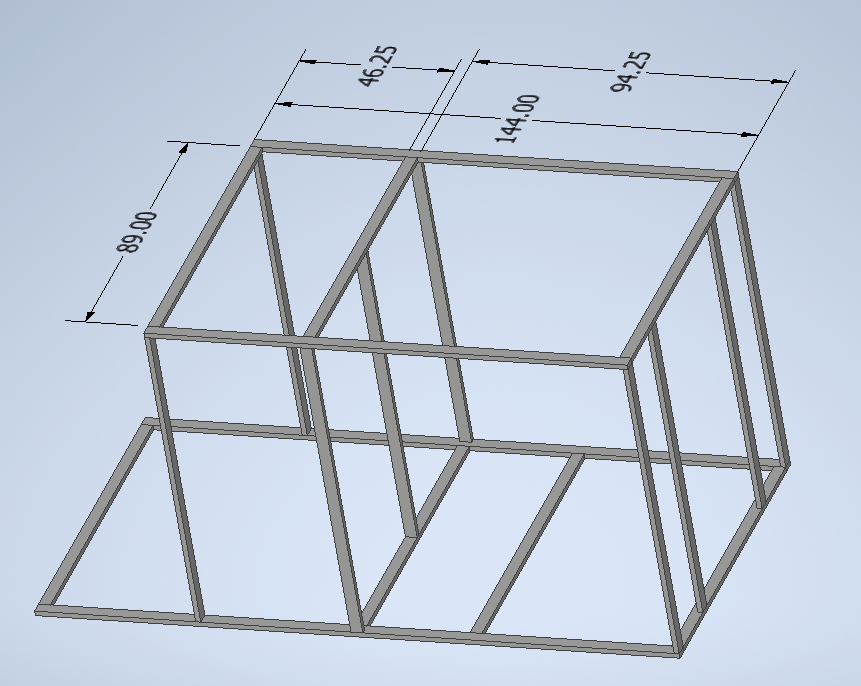
[picture p108: figure]

## Slide 5

(6) 2x4x10
- (6) slants

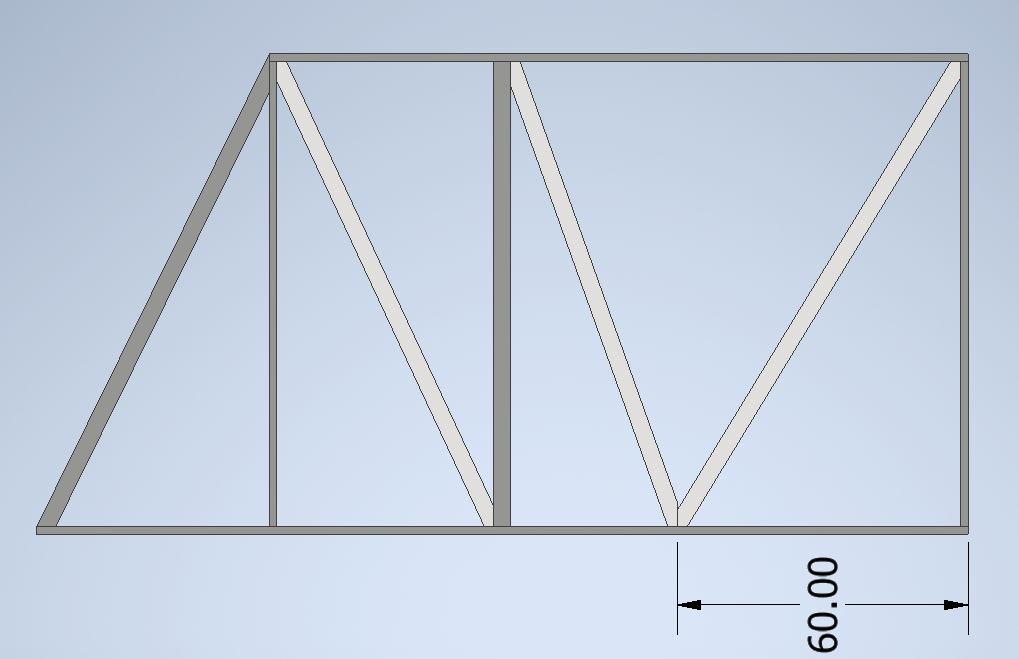
[picture p109: figure]

## Slide 6

(8) 2x4x10
- (8) slants
