UofSC-ASME/USC-ASME-TigerBurn-2026/CAD/Assembly/TigerBurnDesign2026.pdf

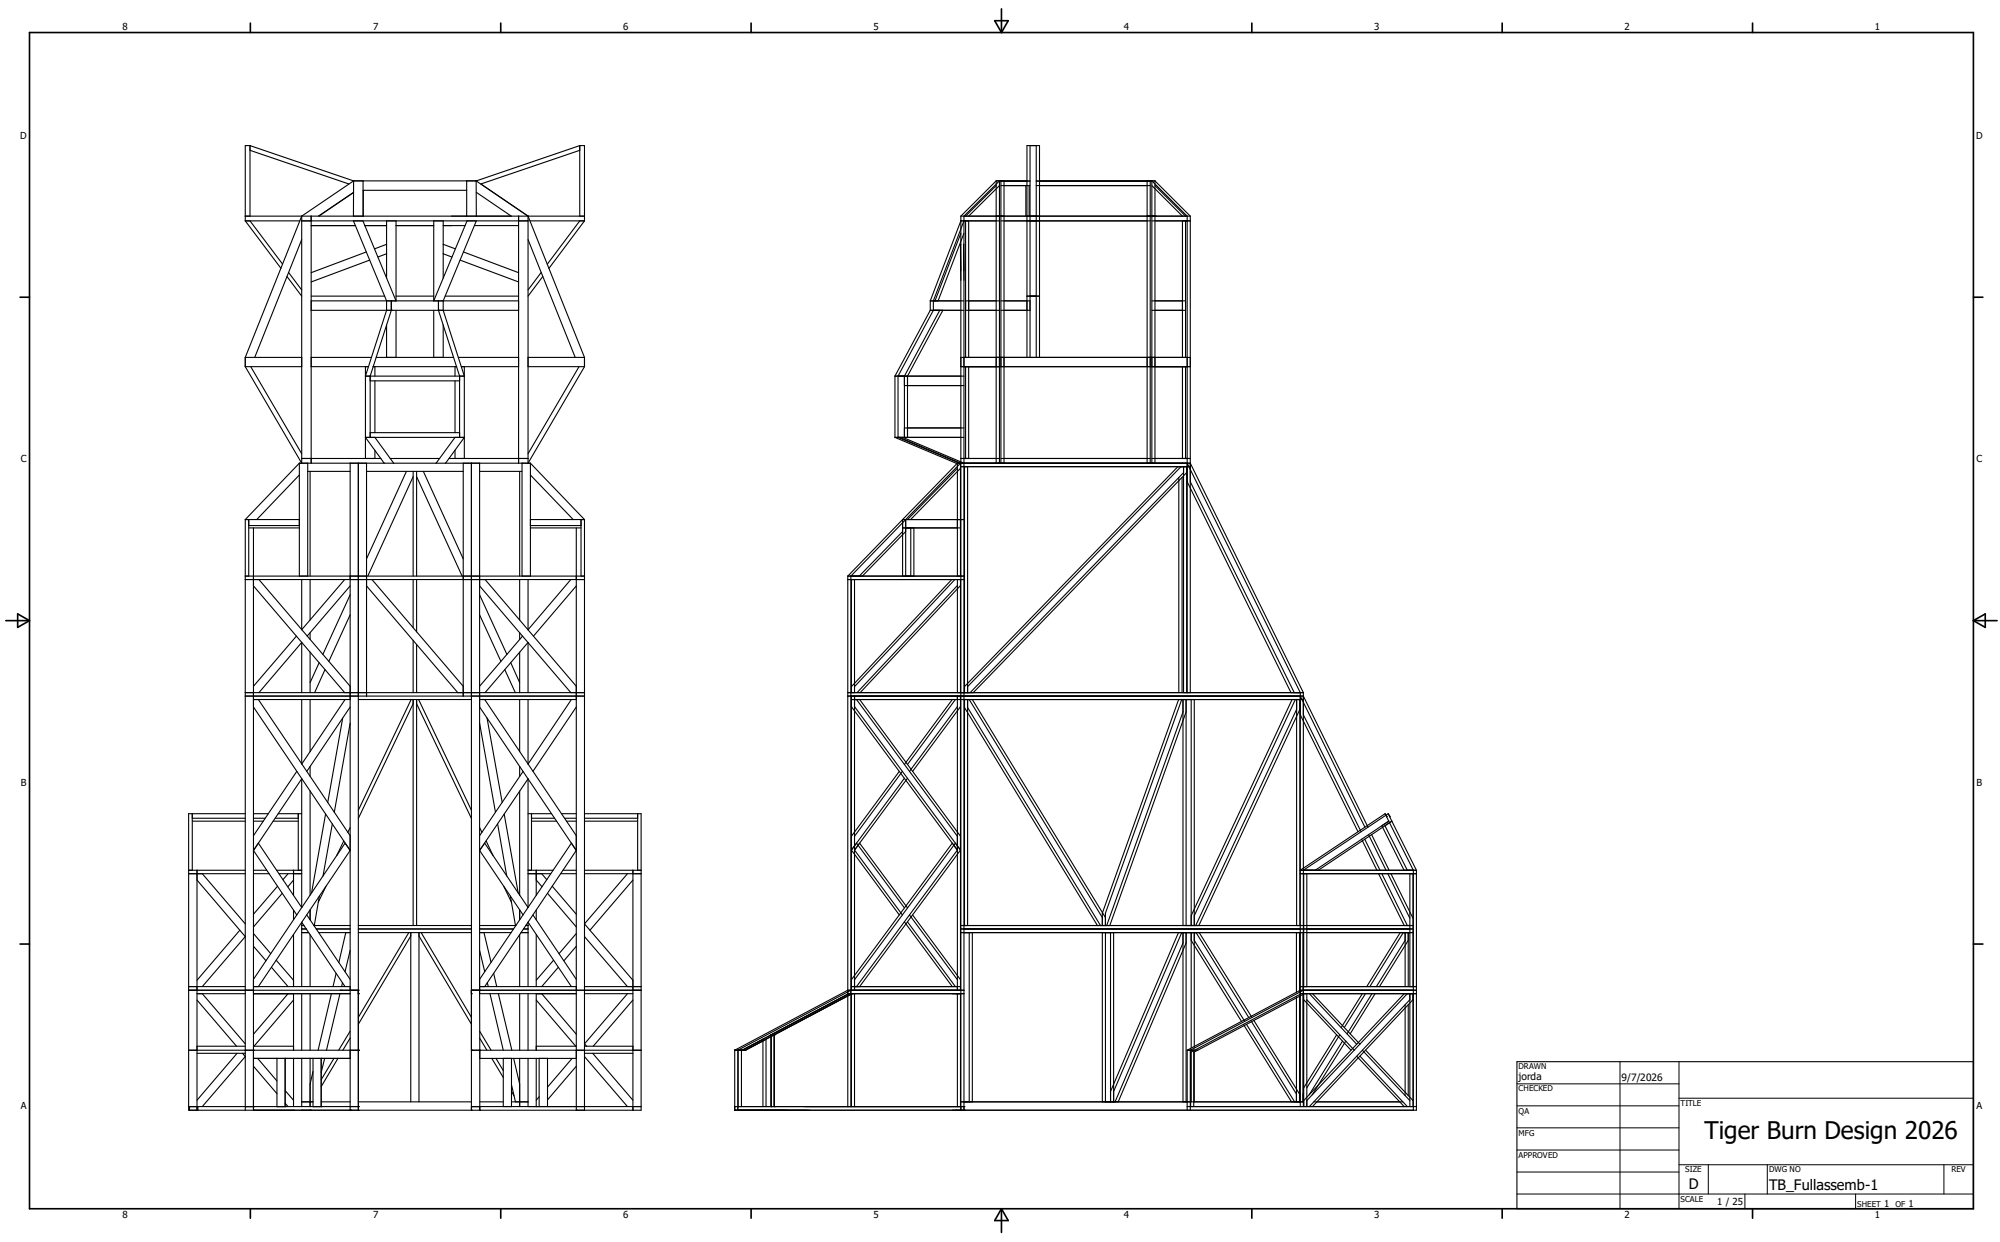
[picture p110: page 1]
jorda; DWG NO

SHEET 1 OF 1 DRAWN
CHECKED QA MFG

TB_Fullassemb-1 TITLE
1 / 25 Tiger Burn Design 2026

APPROVED

SCALE SIZE D | REV
