UofSC-ASME/USC-ASME-TigerBurn-2026/UofSC-ASME-Tiger-Burn-Design-2025-main/UofSC-ASME-Tiger-Burn-Design-2025-main/Documents/Drawings/Base_assemb.pdf

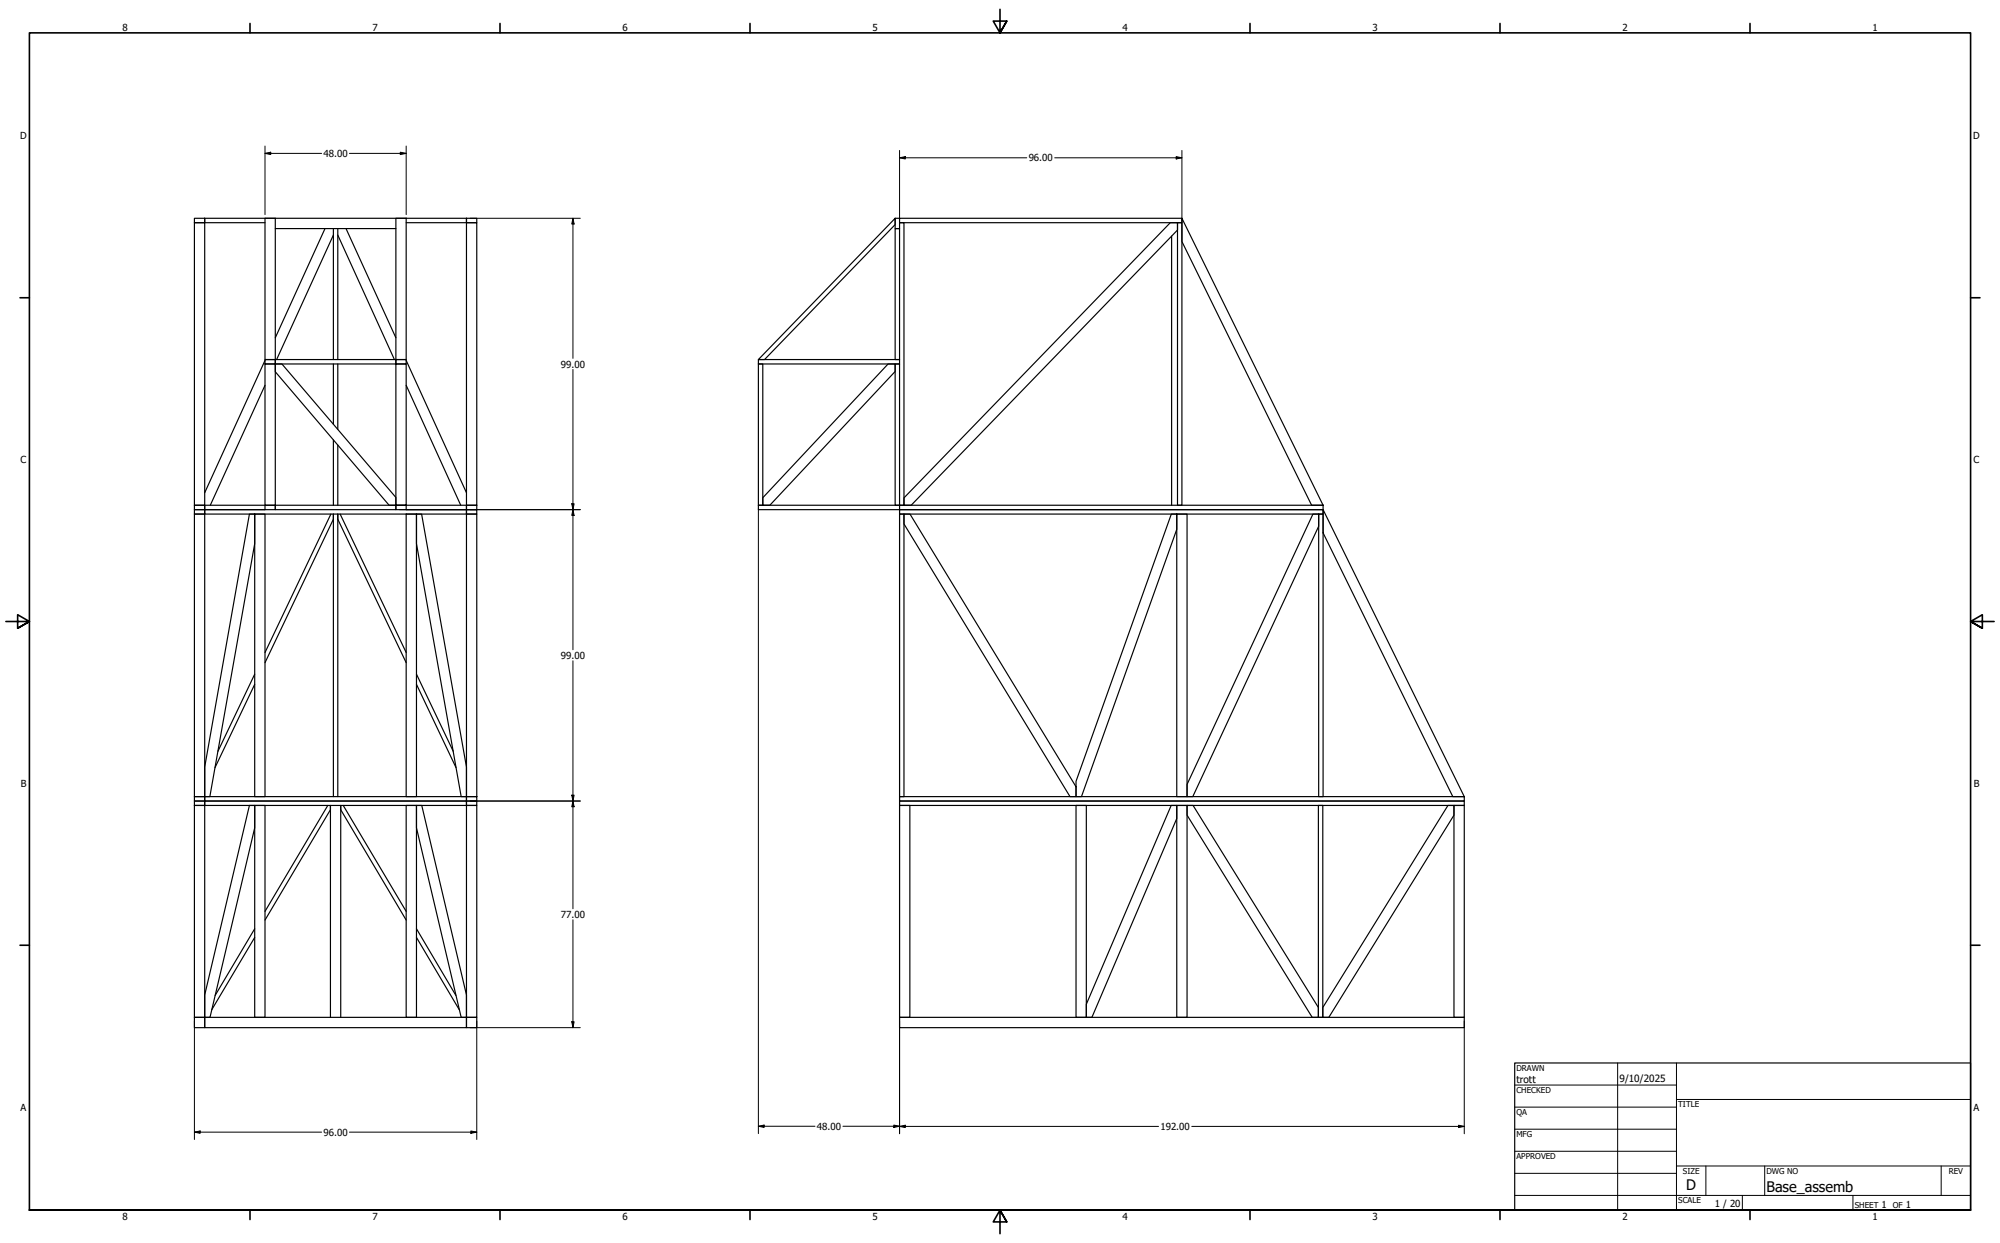
[picture p111: page 1]

DRAWN trott | 9/10/2025

CHECKED

MFG

APPROVED

SIZE D | DWG NO Base_assemb | REV

SCALE 1 / 20 | | SHEET 1 OF 1
