UofSC-ASME/USC-ASME-TigerBurn-2026/UofSC-ASME-Tiger-Burn-Design-2025-main/UofSC-ASME-Tiger-Burn-Design-2025-main/Documents/Drawings/TB_Fullassemb.pdf

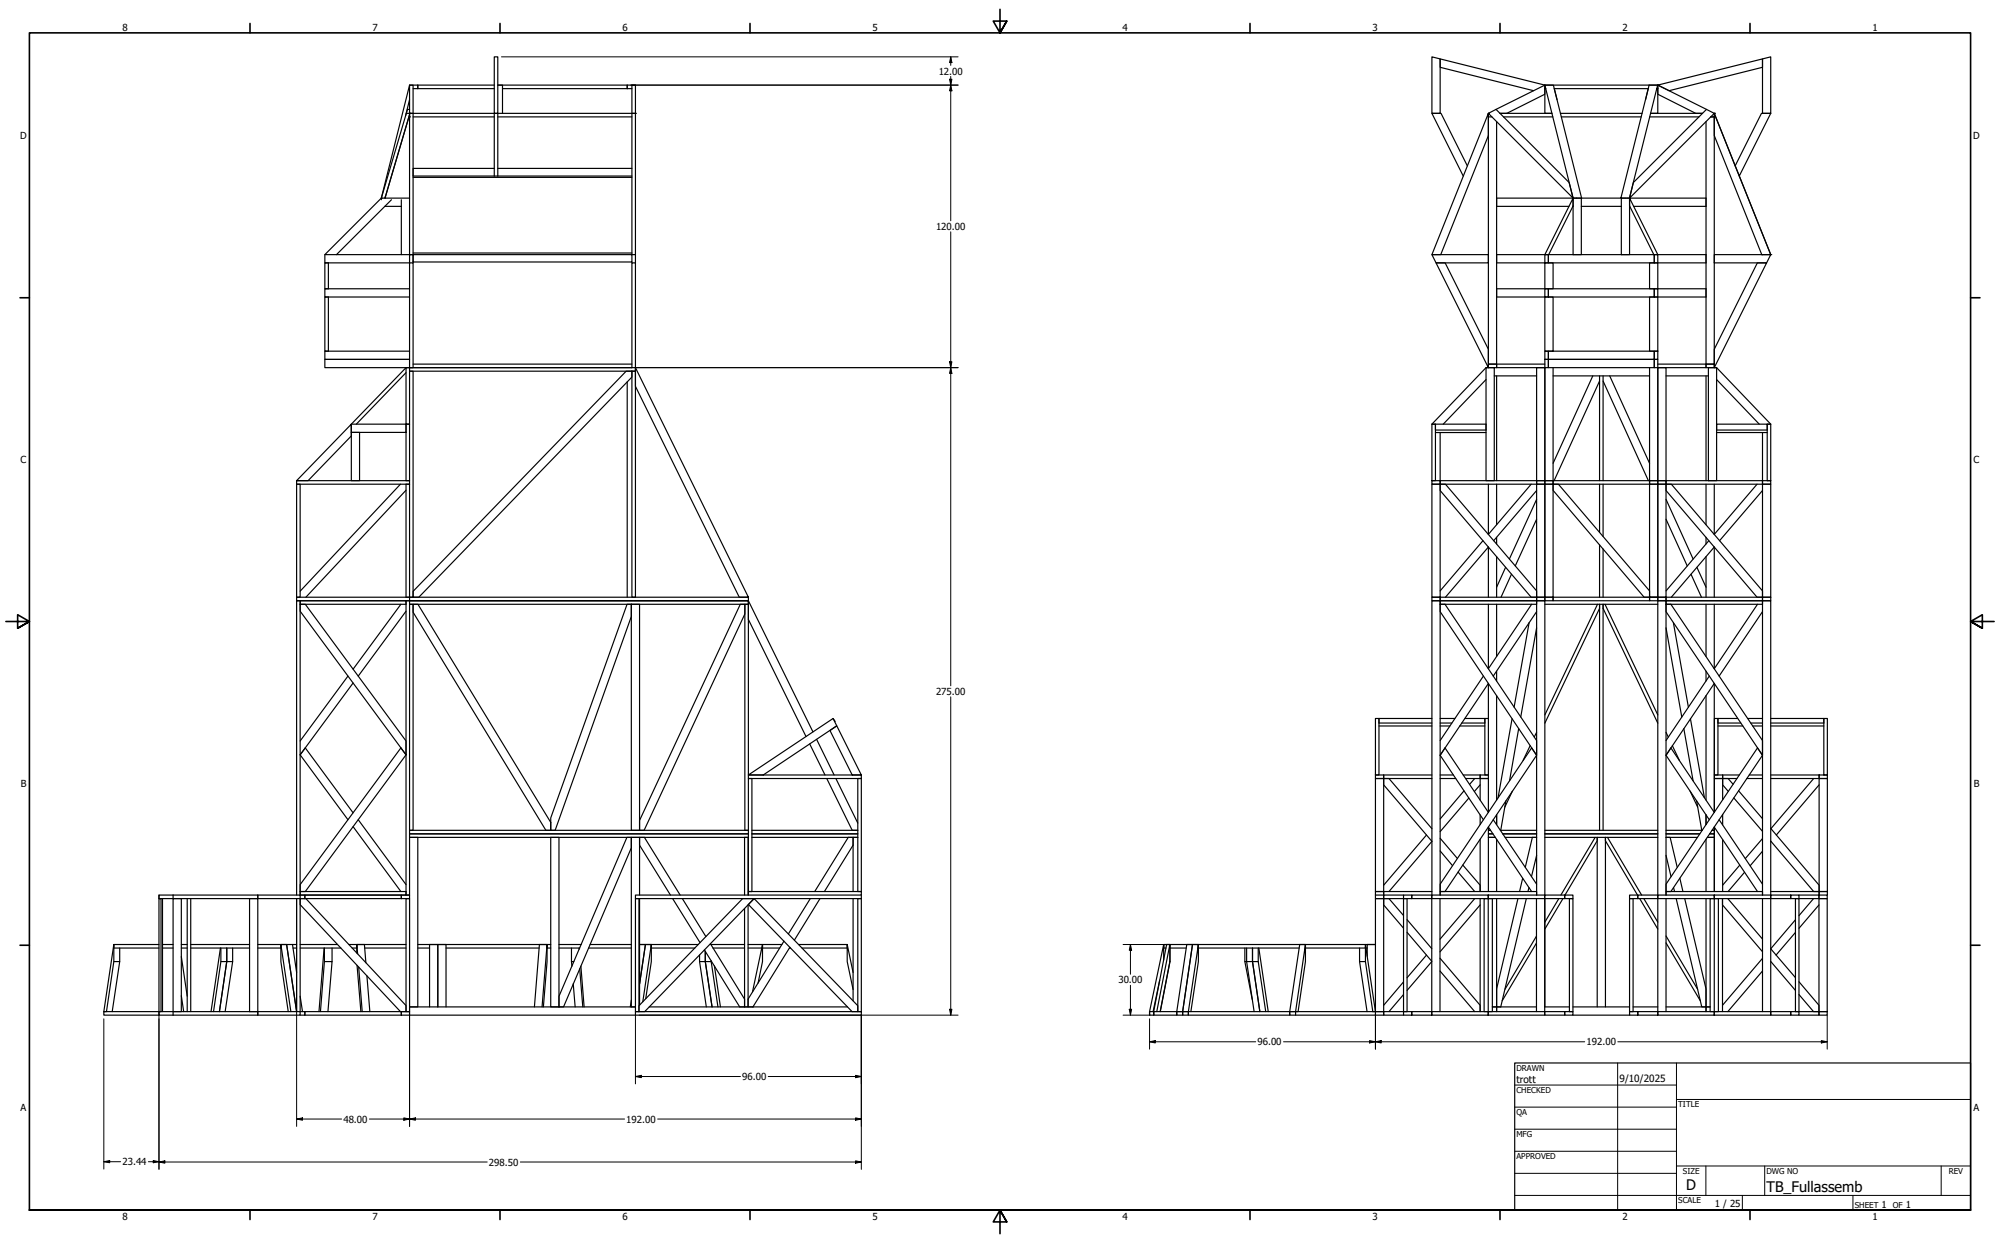
[picture p112: page 1]

DRAWN trott | 9/10/2025

CHECKED

MFG

APPROVED

SIZE D | DWG NO TB_Fullassemb | REV

SCALE 1 / 25 | | SHEET 1 OF 1
