UofSC-ASME/USC-ASME-TigerBurn-2026/tiger burn cuts - head and feet.pdf

B | Foot | (8+ t) | (10ft) | (12ft) | (16ft)
| | 2 .

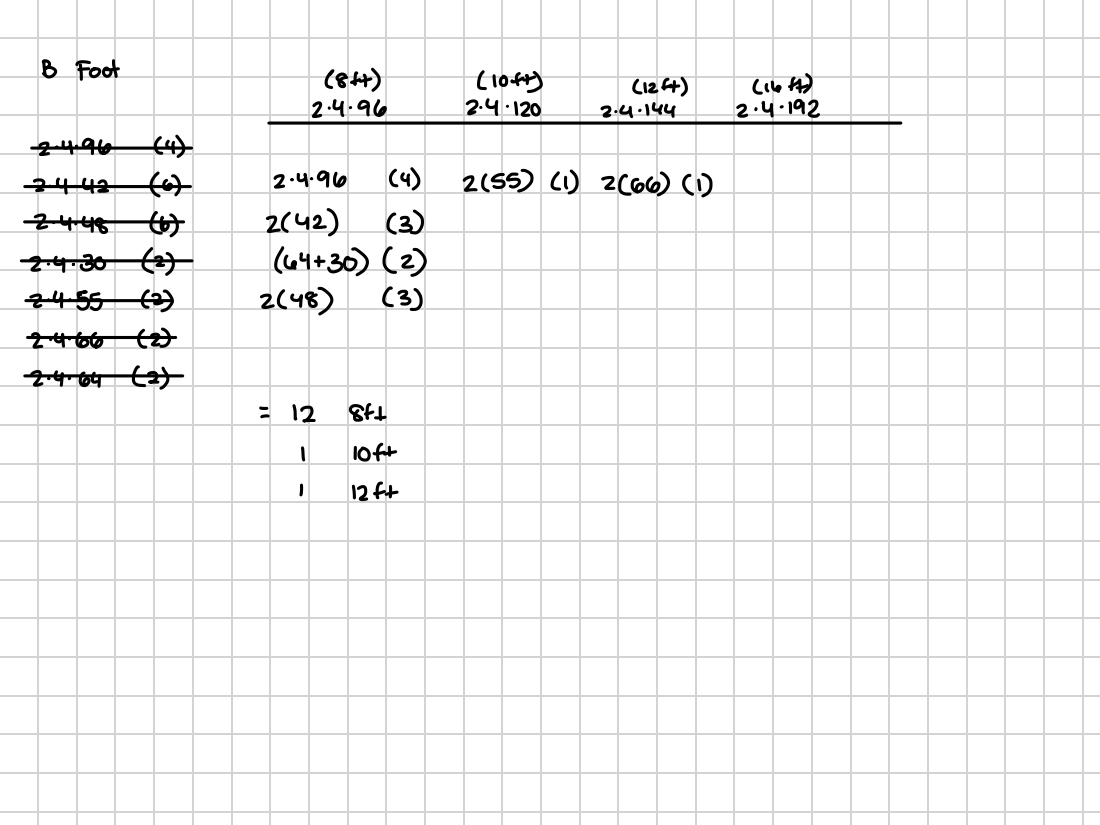
[picture p113: page 1]
Oft

# FFt

(8+ t) | (10ft) | (12ft) | (16ft)

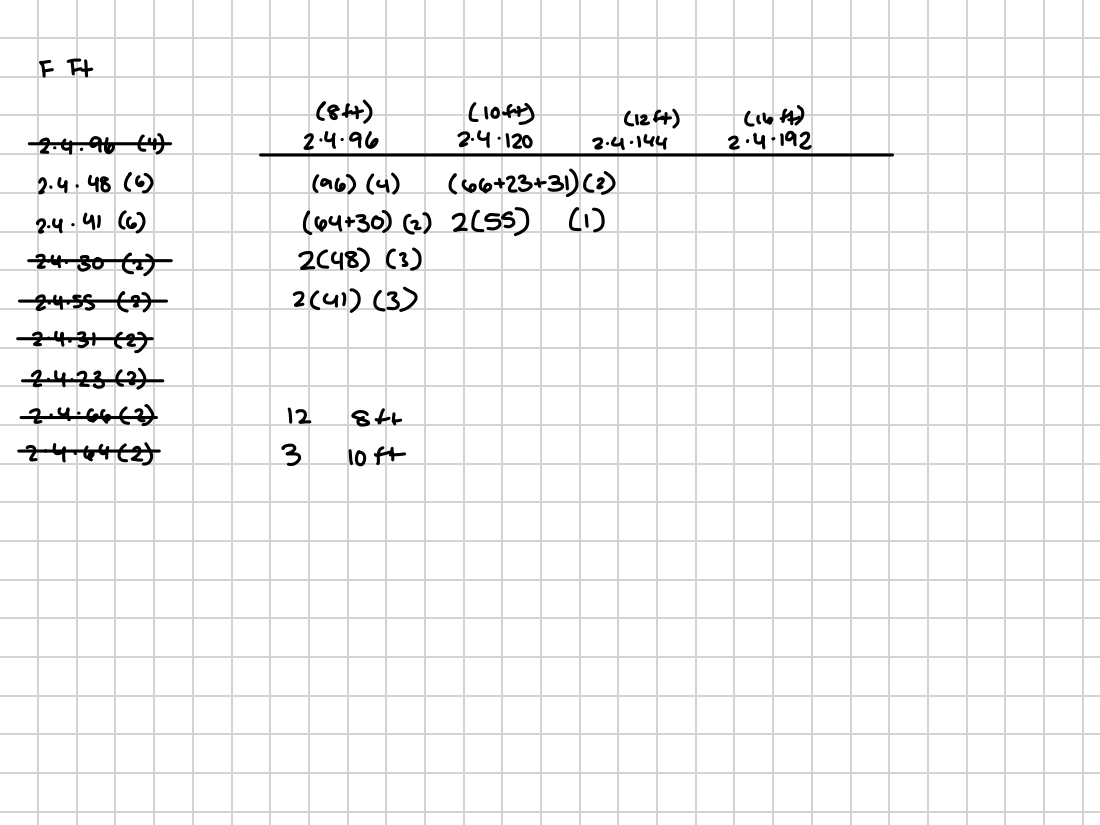
[picture p114: page 2]

(8+ t) | (10ft) | (12ft) | (16ft)
Head | 2 | .

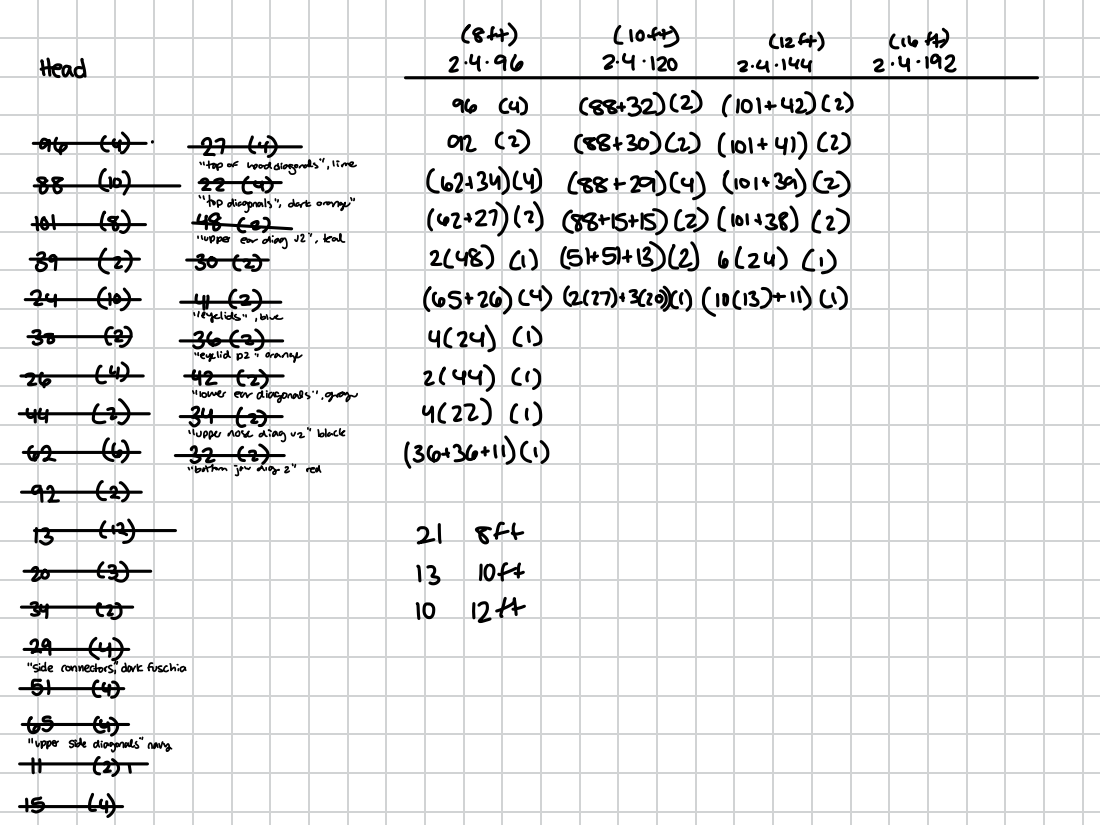
[picture p115: page 3]
41)(2) "Top of; read diagonals" ,; lime; (88 + 29)(4)(10¹ ⁺ 3a)(2) "top diagonals",; dark; orange"; 27)(2)(88⁺15+15) (2) (101 + 38)(2) "upper; ear diag -2" ,; teal; (1) "eyelid; p2 orange; 2(44)(1) "lower; ear diagonals" ,gray; u(22)(1) "upper nose diag v2"; black; (36⁺ ³⁶⁺ 11)(1) "bottom; jow dig I" red; (4)11 "Side connectors,; dark fuschia; (4) "upper side diagonals" navy

3(20))(1)(10(13)⁺ ¹¹⁾⁽⁾ leyelids" , bive
