UofSC-ASME/USC-ASME-TigerBurn-2026/(commit log)

2026-04-24 Drawing of Head and sideprofile Tail
    [TigerBurn2026Head.idw]
2026-06-02 Add files via upload
    Still in progress, added a screenshot of what it looks like so far. Any adjustments anyone has/questions are welcome.
    [2026 Tiger Burn Head.iam, 2x4x(20x39).ipt, 2x4x(20x41).ipt, 2x4x(24x41).ipt, 2x4x(24x43).ipt, 2x4x(24x43)_MIR.ipt, 2x4x(24x43)_MIR1.ipt, 2x4x(24x43)_MIR_MIR.ipt]
2026-09-01 update 8/30
    [2026 Tiger Burn Head.iam, 2x4x(20x39).ipt, 2x4x(20x41).ipt, 2x4x(24x41).ipt, 2x4x(24x43).ipt, 2x4x(24x43)_MIR.ipt, 2x4x(24x43)_MIR1.ipt, 2x4x(24x43)_MIR_MIR.ipt]
2026-09-03 update 9/1
    [2x4x12.0008.ipt, 2x4x12.ipt, 2x4x20.5.0002.ipt, 2x4x20.5.ipt, 2x4x22.5.0001.ipt, 2x4x24.0004.ipt, 2x4x24.ipt, 2x4x36.0004.ipt]
2026-09-04 update 9/4
    [2x4x41.ipt, S_2x4x14.42.0001.ipt, S_2x4x14.42.ipt, S_2x4x73.75.0003.ipt, S_2x4x73.75.ipt, S_2x4x80.31.ipt, S_2x4x84.0002.ipt, S_2x4x84.ipt]
2026-09-04 head 9/4
    [10'x2x4.0002.ipt, 10'x2x4.ipt, 12'x2x4.0001.ipt, 12'x2x4.ipt, 16'x2x4.0002.ipt, 16'x2x4.ipt, 16'x4x4.ipt, 2026 Tiger Burn Head.iam]
2026-09-04 head files to main
    [2026 Tiger Burn Head updated 9-4.iam, 2026 Tiger Burn Head.iam, 2026.iam, 2x4x(20x39).ipt, 2x4x(20x41).ipt, 2x4x(24x41).ipt, 2x4x(24x43).ipt, 2x4x(24x43)_MIR.ipt]
2026-09-08 9/4 2
    [F_Foot_v2.0005.iam, F_Foot_v2.0006.iam, F_Foot_v2.iam, TB_BOM_2026.xlsx]
2026-09-08 9/4 3
    [2026 Tiger Burn Head updated 9-4 - Copy.iam, B_Foot_v2.0009.iam, B_Foot_v2.0010.iam, B_Foot_v2.iam, F_Foot_v2.0006.iam, F_Foot_v2.0007.iam, F_Foot_v2.iam, TB_BOM_2026.xlsx]
2026-10-09 Board Cuts for the Head based off an image
    Couldn't add dimensions, weirdly enough, but if paired with the image Jordan made for cuts, it should be serviceable.
    [BoardCutsTigerBurnHead2026.iam]
2026-10-11 Add build instructions and board cuts links for 2026
    Added links to board cuts and build instructions for 2026.
2026-10-12 Add build instructions for Front Foot 2026
    Added build instructions for Front Foot 2026, including a link to the presentation and notes on BOM members.
